HydraResearchLLC/Nautilus-Hardware/Nautilus PCBs/EIP PCB/EIP PCB Rev0.1/Extruders in Serise PCB/OUTPUT/BOM/Bill of Materials-EIP PCB0.1.xls

Comment | Description | Designator | Digi-Key Part Number | Footprint | LibRef | Manufacturer | Manufacturer Part Number | Quantity
Header 4 | CONN HEADER 4POS .100 VERT TIN | E0-1, E0-2 | WM4113-ND | HDR1X4 | Header 4 | Molex, LLC | 0022272041 | 2.0
Header 4H | CONN RECEPT 4POS .100 R/A PCB | P1 | WM3002-ND | HDR1X4H | Header 4H |  | 0022152046 | 1.0
