HydraResearchLLC/Nautilus-Hardware/Nautilus PCBs/EIP PCB/EIP PCB Rev0.1/Extruders in Serise PCB/OUTPUT/BOM/Bill of Materials-REV0.3.xls

Comment | Description | Designator | Footprint | LibRef | Quantity
Header 4H | CONN RECEPT 4POS .100 R/A PCB |  | HDR1X4H | Header 4H | 1.0
Header 4 | CONN HEADER 4POS .100 VERT TIN | E0-1, E0-2 | HDR1X4 | Header 4 | 2.0
