HydraResearchLLC/Nautilus-Hardware/Nautilus PCBs/Tool Head PCB/REV0.3_modified/REV0.3_modified/OUTPUT/BOM/Bill of Materials-REV0.3.xls

Comment | Description | Designator | Footprint | LibRef | Quantity
A125081CT |  | U01, U02, U03, U04 | A125081CT-ND | A125081CT | 4.0
WM17990CT |  | U11, U12, U13, U14 | WM17990CT-ND-l | WM17990CT | 4.0
