HydraResearchLLC/Nautilus-Hardware/Nautilus PCBs/Tool Head PCB/REV0.3_modified/REV0.3_modified/OUTPUT/BOM/Bill of Materials-REV0.3.xlsx

Comment | Description | Designator | Footprint | LibRef | MPN | Quantity
A125081CT |  | U01, U02, U03, U04 | A125081CT-ND | A125081CT | A125081CT-ND | 4
WM17990CT |  | U11, U12, U13, U14 | WM17990CT-ND-l | WM17990CT | WM17990CT-ND | 4
