HydraResearchLLC/Nautilus-Hardware/Nautilus PCBs/Tool PCB/REV0.4_modified/REV0.4_modified/OUTPUT/BOM/Bill of Materials-REV04.xls

Comment | Description | Designator | Footprint | LibRef | MPN | Quantity
WM17990CT |  | 1, 2, 3, 4 | WM17990CT-ND-l | WM17990CT | WM17990CT-ND | 4.0
CONTACT |  | J1, J2, J3, J4 | CONTRACT PAD | CONTACT | N/C | 4.0
