HydraResearchLLC/Nautilus-Hardware/Acrylic Enclosure/Acrylic Enclosure v1/XYZ v1.dxf

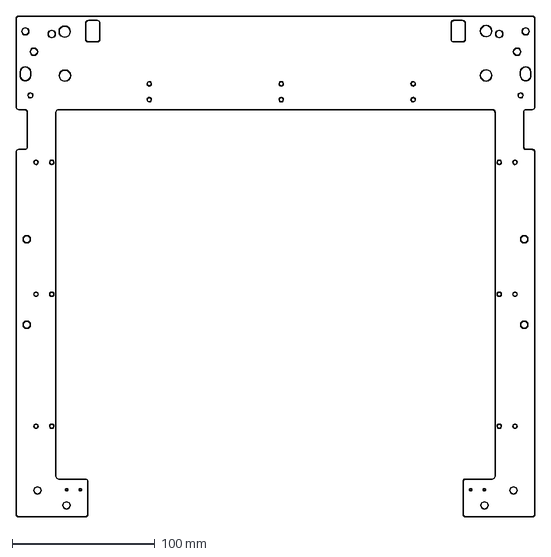
[picture p1: CAD file, 2019-06-13]
Acrylic Enclosure/Acrylic Enclosure v1/XYZ v1.dxf
364.0 x 351.2 mm
