HydraResearchLLC/Nautilus-Hardware/Jig & Fixtures/Hot Teighten Jig Top.stl

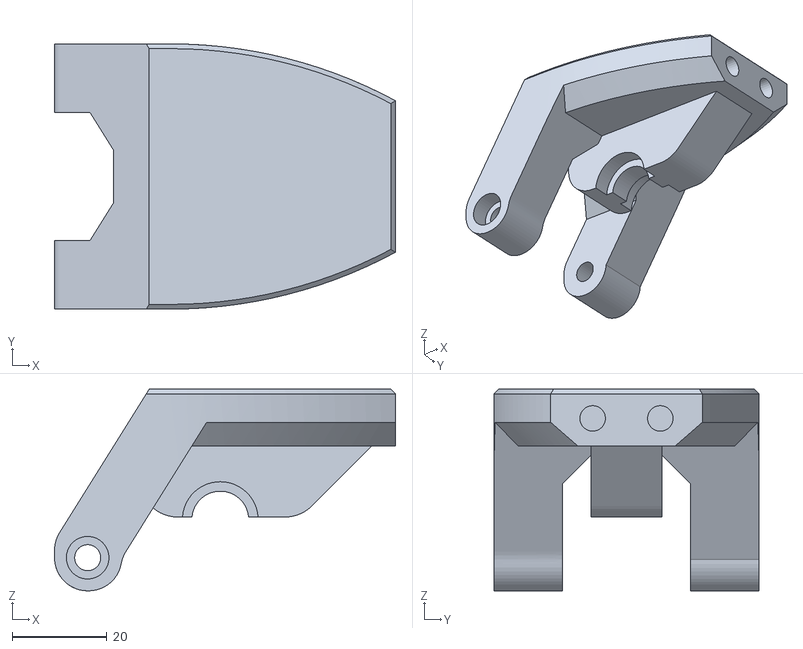
[picture p2: CAD file, 2019-05-24]
Jig & Fixtures/Hot Teighten Jig Top.stl
72.0 x 56.0 x 42.6
