HydraResearchLLC/Nautilus-Hardware/Machined Parts/Belt Tensioner/Belt Tensioner v1.step

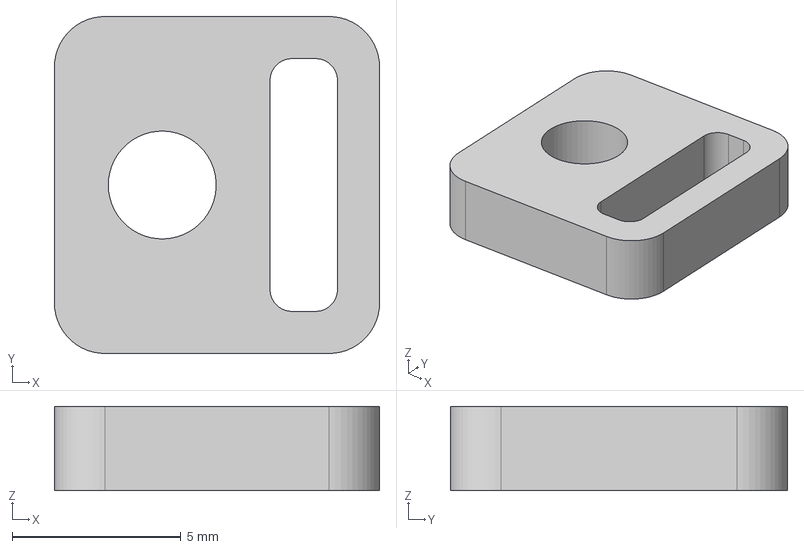
[picture p3: CAD file, 2019-05-24]
Machined Parts/Belt Tensioner/Belt Tensioner v1.step
9.65 x 10.0 x 2.50 mm
