HydraResearchLLC/Nautilus-Hardware/Machined Parts/Build Plate/Build Plate Rev0.9/Build Plate Rev0.9.step

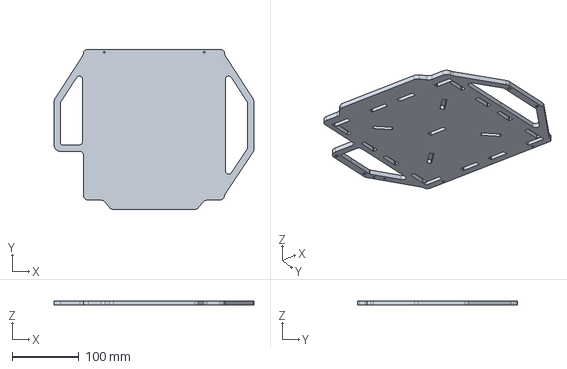
[picture p4: CAD file, 2019-05-24]
Machined Parts/Build Plate/Build Plate Rev0.9/Build Plate Rev0.9.step
300.0 x 240.0 x 6.35 mm
