HydraResearchLLC/Nautilus-Hardware/Nautilus PCBs/EIP PCB/EIP PCB Rev0.1/Extruders in Serise PCB/OUTPUT/ExportSTEP/PCB1.step

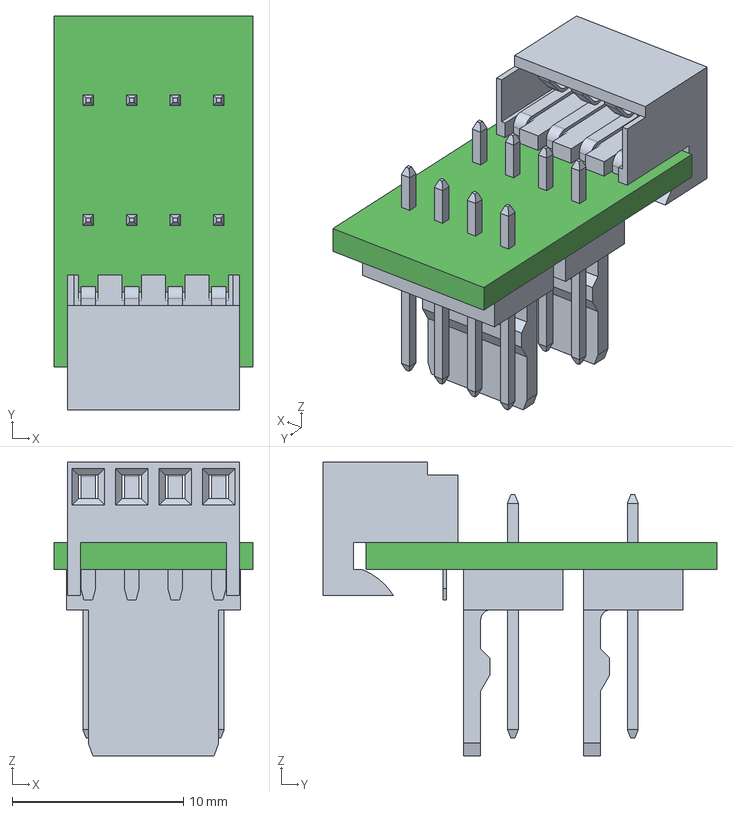
[picture p5: CAD file, 2019-05-24]
Nautilus PCBs/EIP PCB/EIP PCB Rev0.1/Extruders in Serise PCB/OUTPUT/ExportSTEP/PCB1.step
11.6 x 23.0 x 17.2 mm
Board
