HydraResearchLLC/Nautilus-Hardware/Nautilus PCBs/Tool Head PCB/REV0.3_modified/REV0.3_modified/OUTPUT/ExportSTEP/PCB1.step

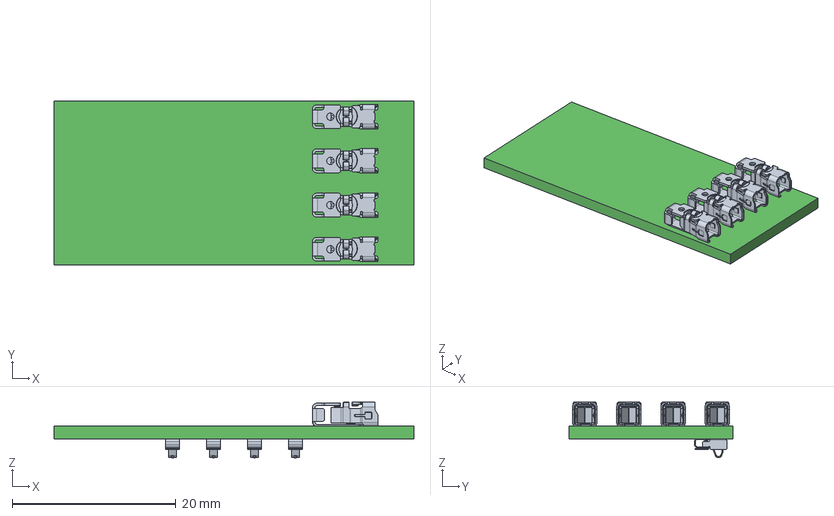
[picture p6: CAD file, 2019-05-24]
Nautilus PCBs/Tool Head PCB/REV0.3_modified/REV0.3_modified/OUTPUT/ExportSTEP/PCB1.step
44.0 x 20.0 x 6.79 mm
Board
c-2286211-3-a-3d x 4
