HydraResearchLLC/Nautilus-Hardware/Nautilus PCBs/Tool PCB/REV0.4_modified/REV0.4_modified/OUTPUT/ExportSTEP/REV04.step

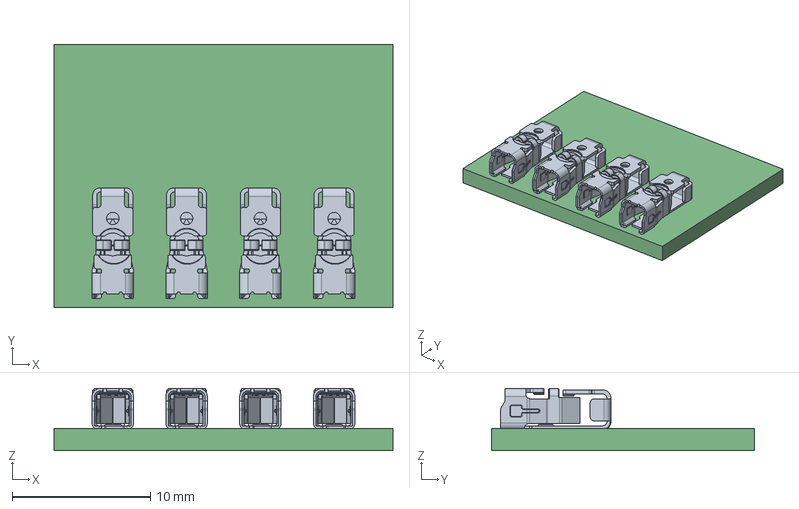
[picture p7: CAD file, 2019-05-24]
Nautilus PCBs/Tool PCB/REV0.4_modified/REV0.4_modified/OUTPUT/ExportSTEP/REV04.step
24.5 x 19.0 x 4.49 mm
Board
