HydraResearchLLC/Nautilus-Hardware/Printed Parts/STL/IO Cover Plate/IO a (2).stl

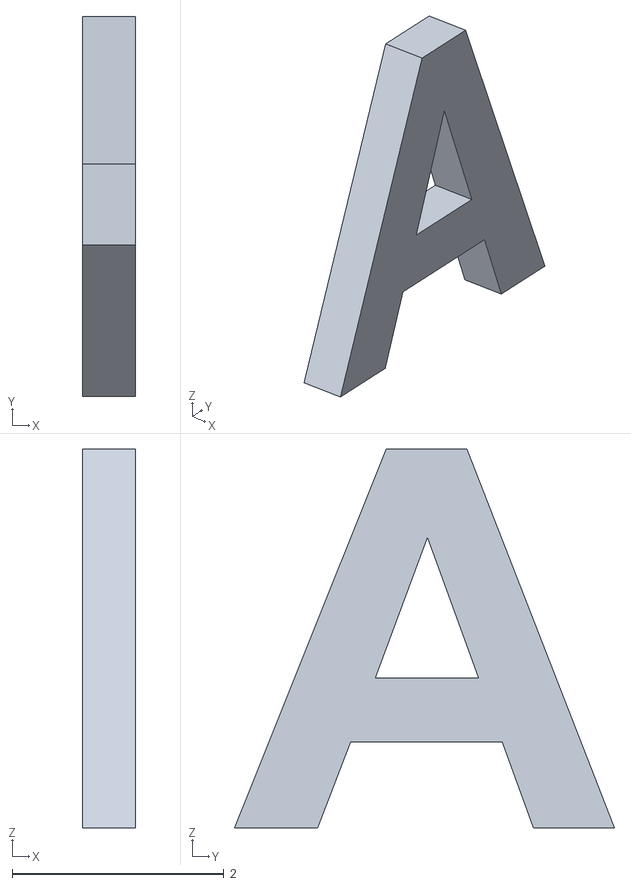
[picture p8: CAD file, 2019-05-24]
Printed Parts/STL/IO Cover Plate/IO a (2).stl
0.5 x 3.59 x 3.58
