HydraResearchLLC/Nautilus-Hardware/Printed Parts/STL/Y Back L.stl

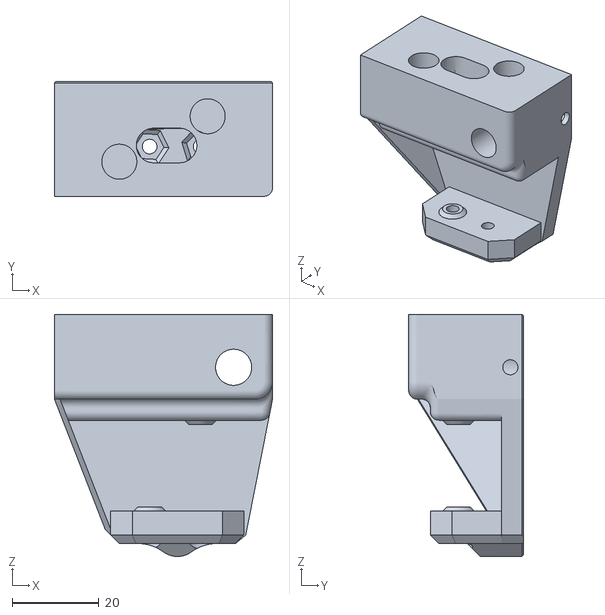
[picture p9: CAD file, 2019-06-29]
Printed Parts/STL/Y Back L.stl
50.4 x 26.5 x 55.9
