HydraResearchLLC/Nautilus-Hardware/Jig & Fixtures/Silicon Square 2'' Jig Top.stl

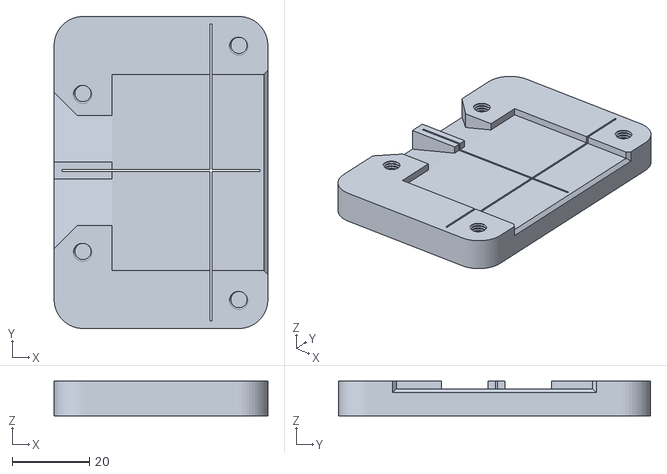
[picture p11: CAD file, 2019-05-24]
Jig & Fixtures/Silicon Square 2'' Jig Top.stl
55.5 x 81.0 x 9.00
