HydraResearchLLC/Nautilus-Hardware/Jig & Fixtures/TC PTFE Jig Pt1.stl

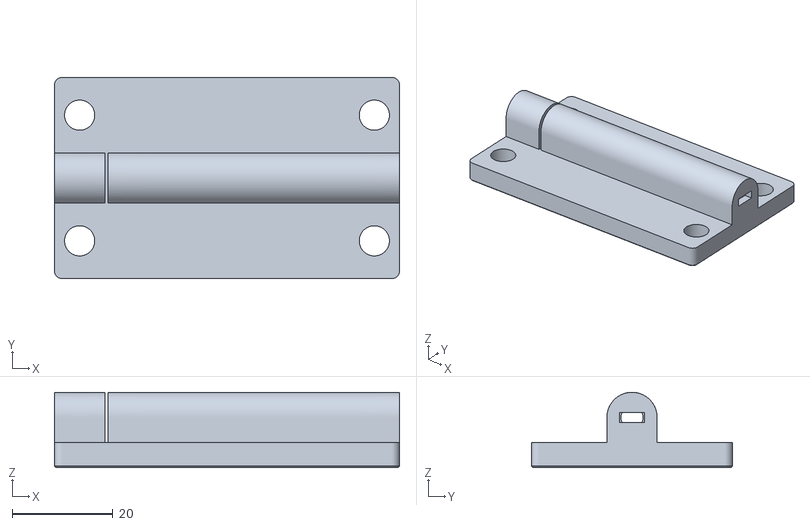
[picture p13: CAD file, 2019-05-24]
Jig & Fixtures/TC PTFE Jig Pt1.stl
68.6 x 40.0 x 15.0
