HydraResearchLLC/Nautilus-Hardware/Machined Parts/Print Surface/Build Surface rev0.4.dxf

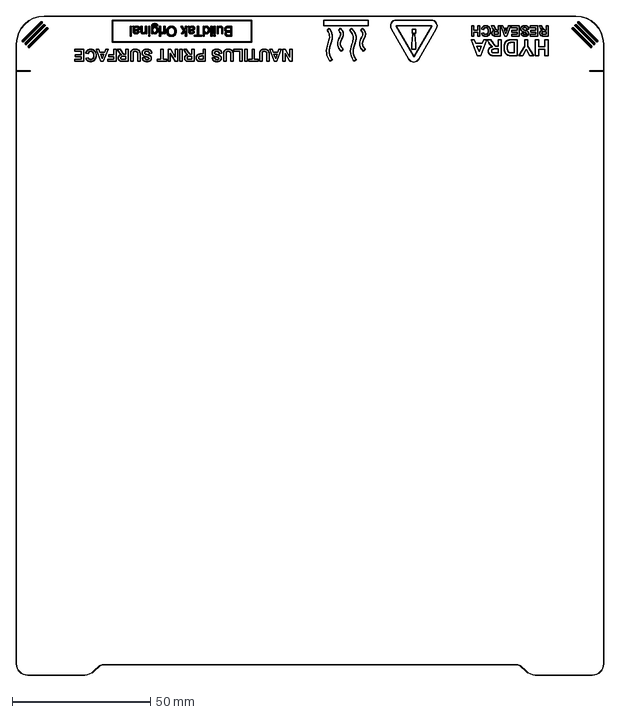
[picture p14: CAD file, 2019-05-24]
Machined Parts/Print Surface/Build Surface rev0.4.dxf
212.0 x 238.0 mm
