HydraResearchLLC/Nautilus-Hardware/Printed Parts/STL/IO Cover Plate/IO Cover Plate.stl

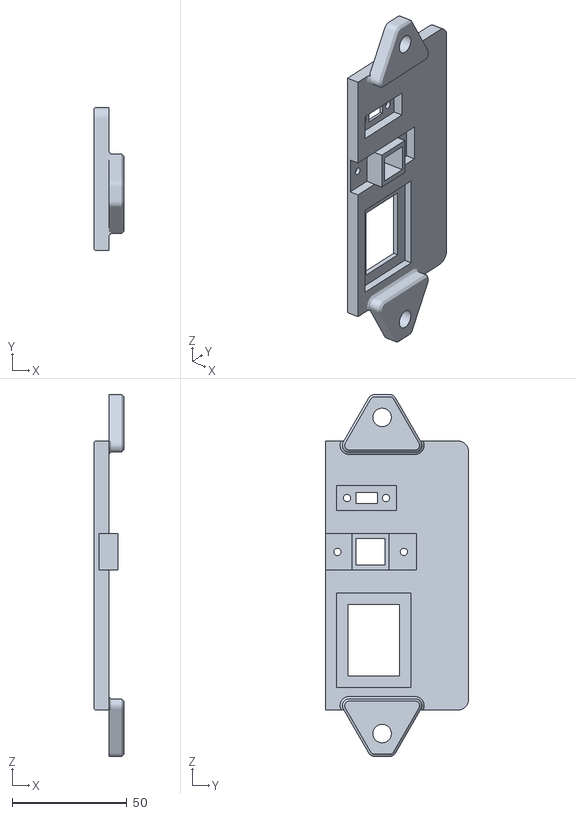
[picture p15: CAD file, 2019-05-24]
Printed Parts/STL/IO Cover Plate/IO Cover Plate.stl
13.1 x 62.6 x 158.0
