HydraResearchLLC/Nautilus-Hardware/Printed Parts/STL/Z-Axis Bottom Mount.stl

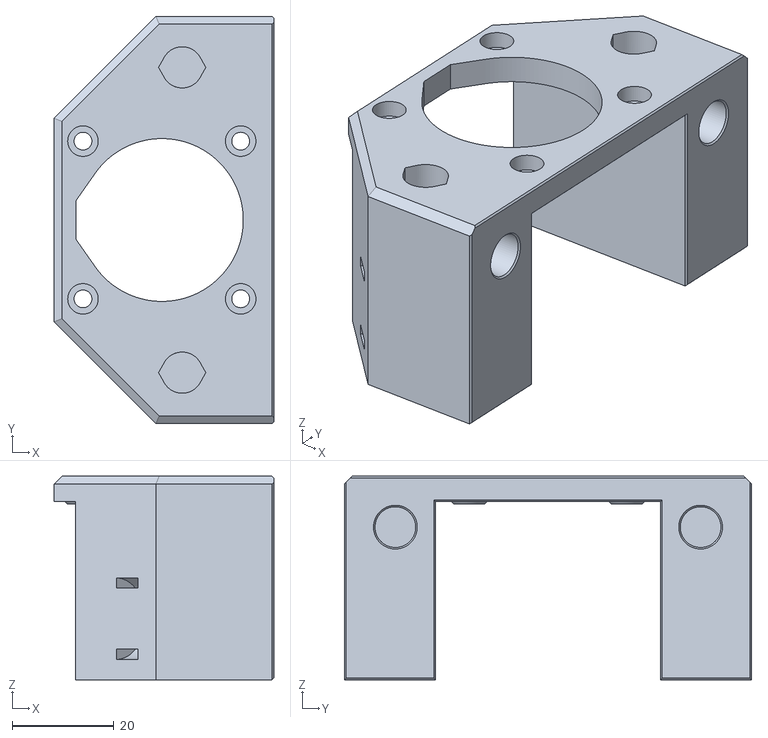
[picture p16: CAD file, 2019-06-29]
Printed Parts/STL/Z-Axis Bottom Mount.stl
43.1 x 80.0 x 40.0
