HydraResearchLLC/Nautilus-Hardware/Acrylic Enclosure/Acrylic Enclosure v1/Frame Side L v1.dxf

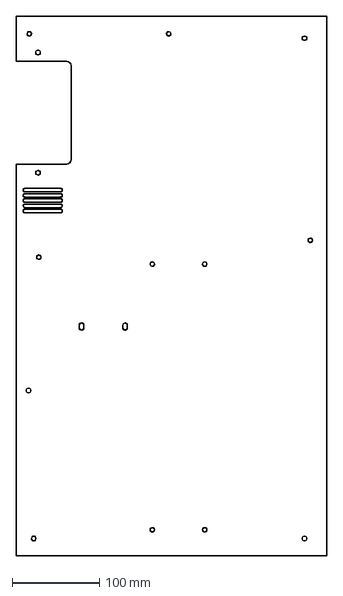
[picture p17: CAD file, 2019-06-13]
Acrylic Enclosure/Acrylic Enclosure v1/Frame Side L v1.dxf
356.7 x 620.3 mm
