HydraResearchLLC/Nautilus-Hardware/Jig & Fixtures/TH Test Jig.stl

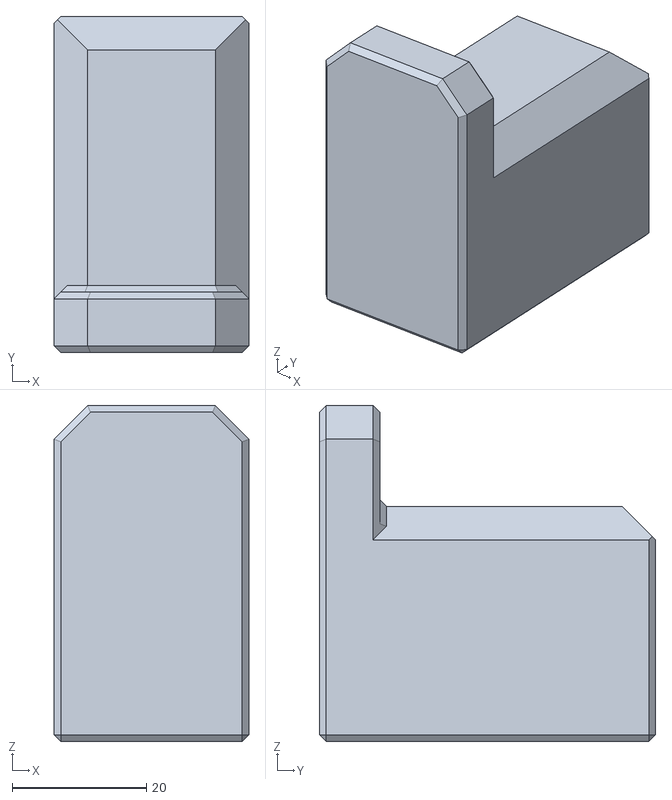
[picture p18: CAD file, 2019-05-24]
Jig & Fixtures/TH Test Jig.stl
29.0 x 50.0 x 50.0
