HydraResearchLLC/Nautilus-Hardware/Printed Parts/STL/IO Cover Plate/IO i.stl

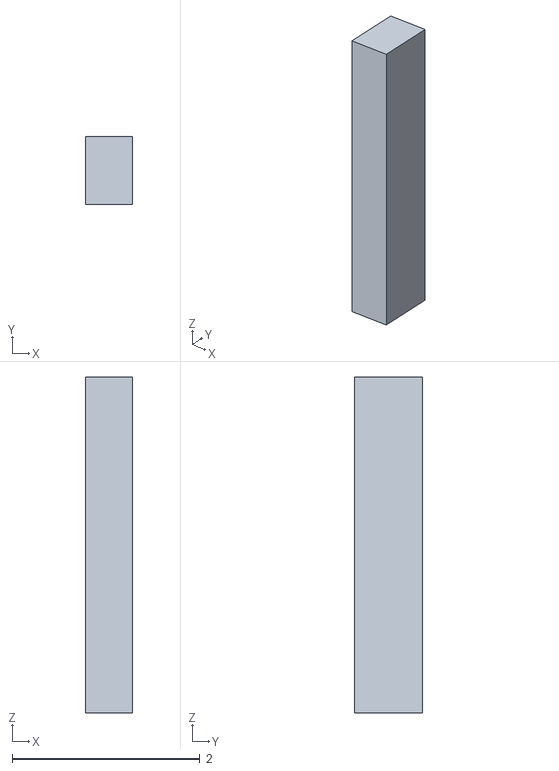
[picture p19: CAD file, 2019-05-24]
Printed Parts/STL/IO Cover Plate/IO i.stl
0.5 x 0.723 x 3.58
