HydraResearchLLC/Nautilus-Hardware/Printed Parts/STL/Tool Cartridge B 250.stl

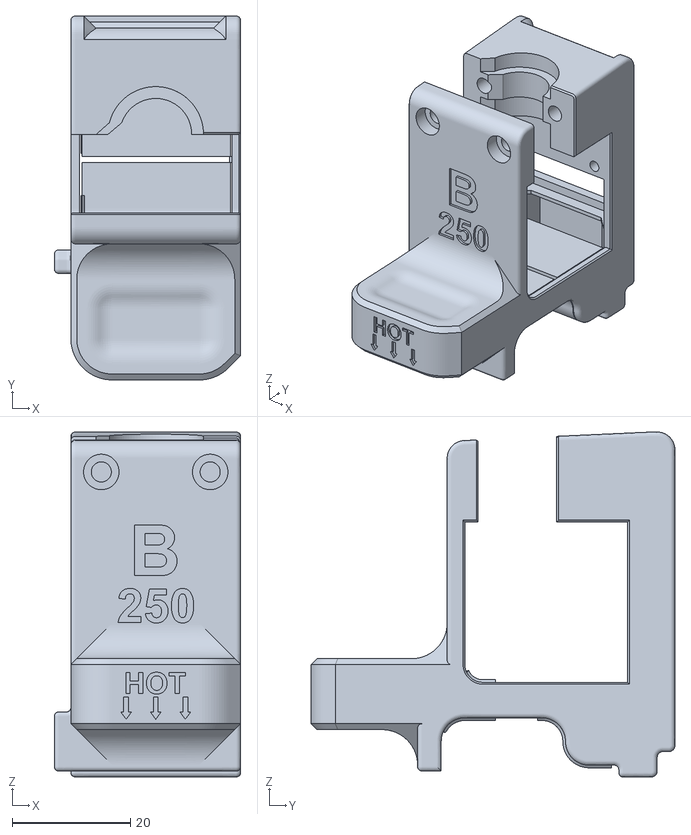
[picture p20: CAD file, 2019-06-13]
Printed Parts/STL/Tool Cartridge B 250.stl
31.5 x 61.5 x 58.3
