HydraResearchLLC/Nautilus-Hardware/Acrylic Enclosure/Acrylic Enclosure v1/Electonics Enclosure Back v1.dxf

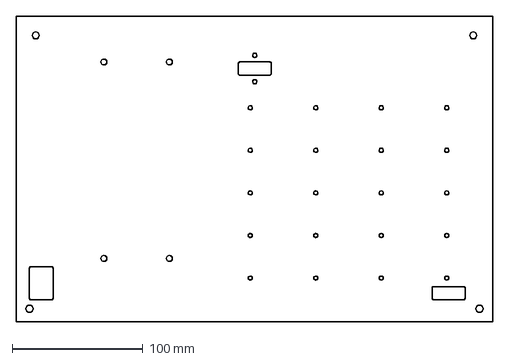
[picture p21: CAD file, 2019-05-24]
Acrylic Enclosure/Acrylic Enclosure v1/Electonics Enclosure Back v1.dxf
363.6 x 233.5 mm
