HydraResearchLLC/Nautilus-Hardware/Jig & Fixtures/Silicon Square 2'' Jig Bottom.stl

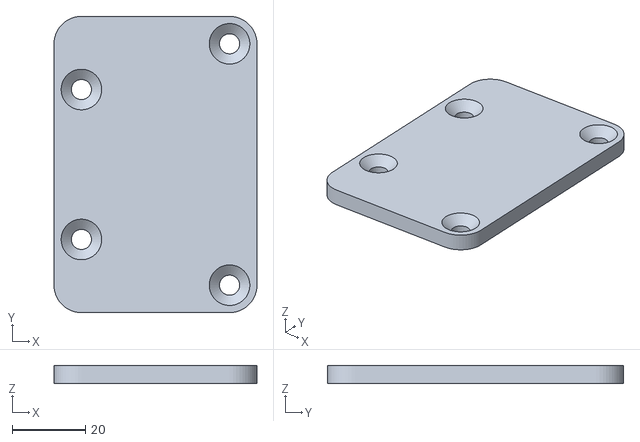
[picture p22: CAD file, 2019-05-24]
Jig & Fixtures/Silicon Square 2'' Jig Bottom.stl
55.5 x 81.0 x 5.00
