HydraResearchLLC/Nautilus-Hardware/Machined Parts/Print Surface/Build Surface rev 0.7 (no graphics).dxf

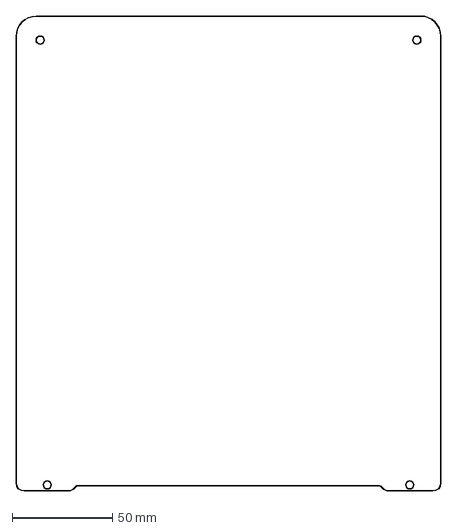
[picture p23: CAD file, 2019-05-24]
Machined Parts/Print Surface/Build Surface rev 0.7 (no graphics).dxf
212.0 x 237.0 mm
