HydraResearchLLC/Nautilus-Hardware/Printed Parts/STL/IO Cover Plate/IO O.stl

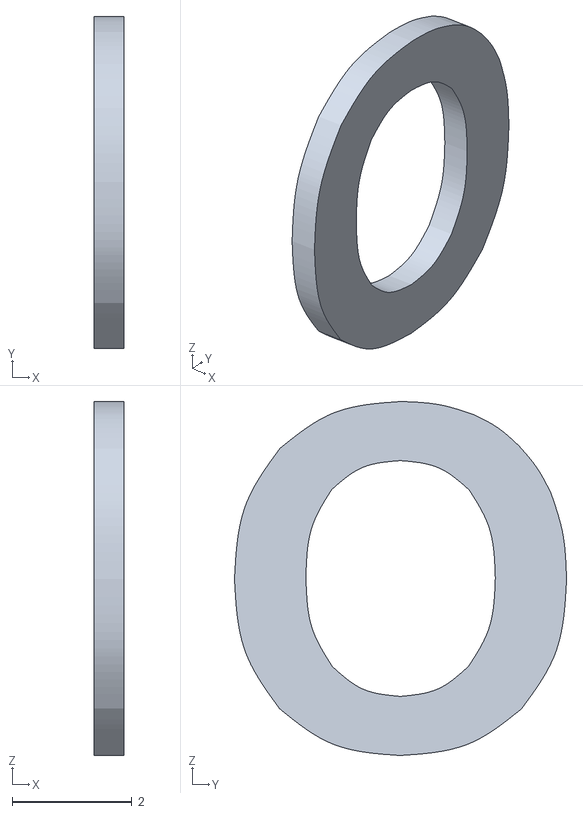
[picture p24: CAD file, 2019-05-24]
Printed Parts/STL/IO Cover Plate/IO O.stl
0.5 x 5.55 x 5.92
