HydraResearchLLC/Nautilus-Hardware/Printed Parts/STL/XY-Axis Idler Spacer.stl

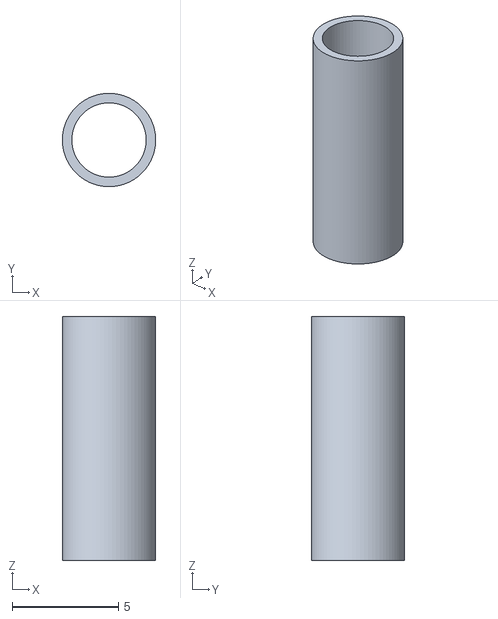
[picture p25: CAD file, 2019-06-13]
Printed Parts/STL/XY-Axis Idler Spacer.stl
4.40 x 4.40 x 11.5
