HydraResearchLLC/Nautilus-Hardware/Acrylic Enclosure/Acrylic Enclosure v1/Frame Back Rev v1.dxf

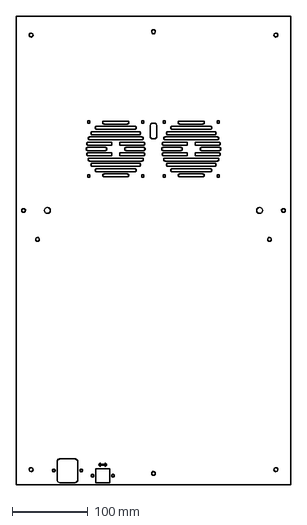
[picture p26: CAD file, 2019-05-24]
Acrylic Enclosure/Acrylic Enclosure v1/Frame Back Rev v1.dxf
364.0 x 620.3 mm
