HydraResearchLLC/Nautilus-Hardware/Jig & Fixtures/Hot Tighten Jig Bottom.stl

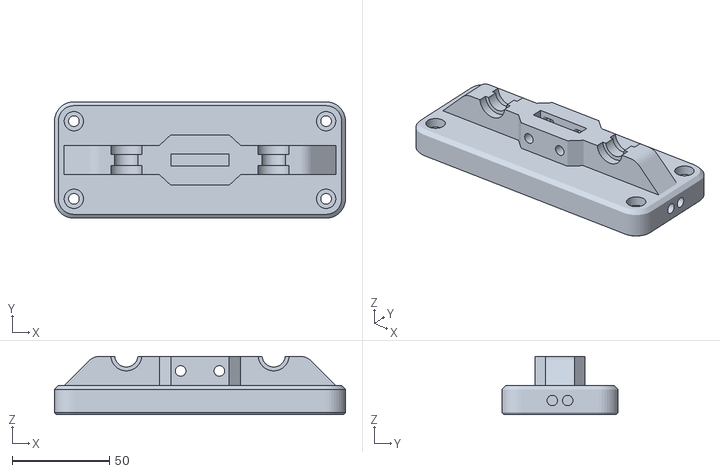
[picture p27: CAD file, 2019-05-24]
Jig & Fixtures/Hot Tighten Jig Bottom.stl
150.0 x 60.0 x 30.0
