HydraResearchLLC/Nautilus-Hardware/Acrylic Enclosure/Acrylic Enclosure v1/Frame Front v1.dxf

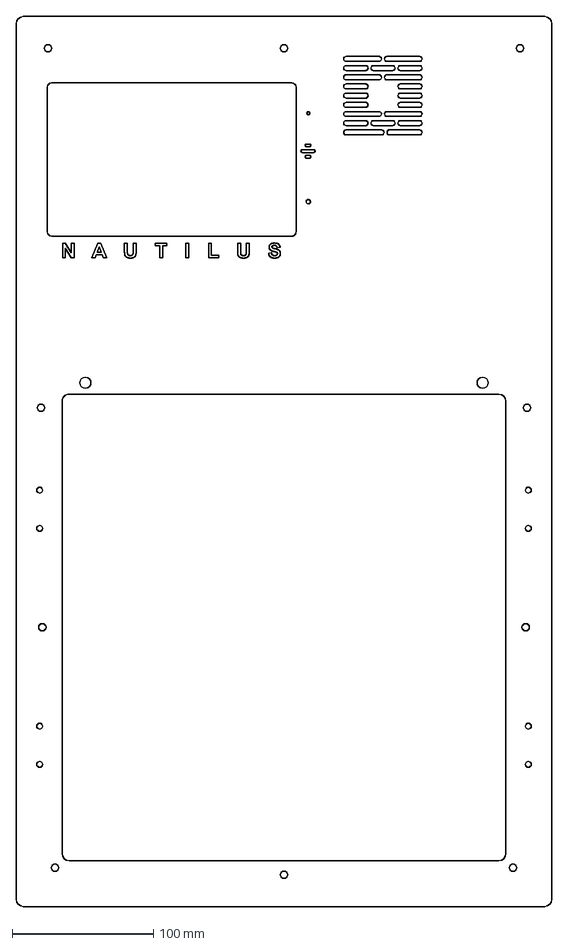
[picture p28: CAD file, 2019-05-24]
Acrylic Enclosure/Acrylic Enclosure v1/Frame Front v1.dxf
379.0 x 629.8 mm
