HydraResearchLLC/Nautilus-Hardware/Jig & Fixtures/FIP PTFE Jig Pt2.stl

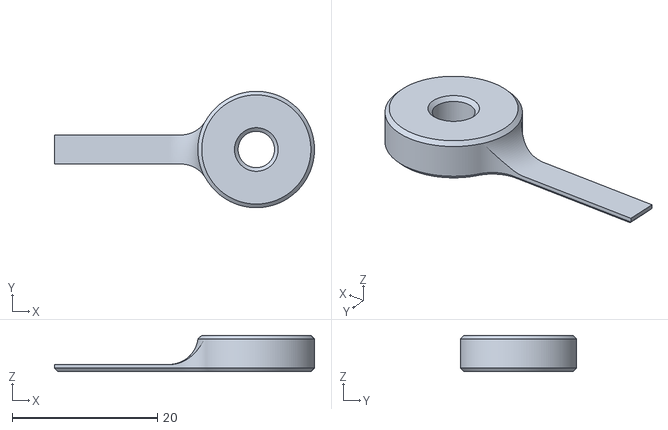
[picture p29: CAD file, 2019-05-24]
Jig & Fixtures/FIP PTFE Jig Pt2.stl
35.7 x 16.0 x 5.00
