HydraResearchLLC/Nautilus-Hardware/Machined Parts/Print Surface/Build Surface rev0.2 (w grapichs).dxf

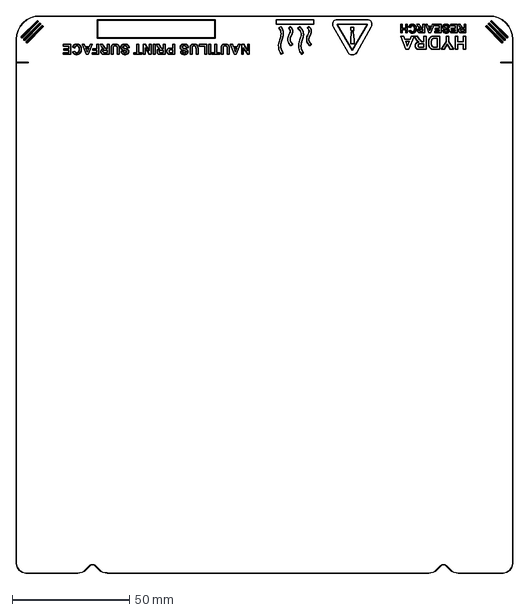
[picture p30: CAD file, 2019-05-24]
Machined Parts/Print Surface/Build Surface rev0.2 (w grapichs).dxf
212.0 x 238.0 mm
