HydraResearchLLC/Nautilus-Hardware/Printed Parts/STL/IO Cover Plate/IO nn.stl

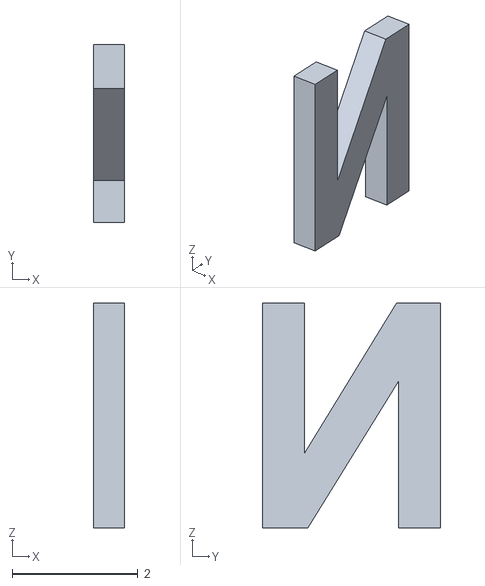
[picture p31: CAD file, 2019-05-24]
Printed Parts/STL/IO Cover Plate/IO nn.stl
0.5 x 2.84 x 3.58
