HydraResearchLLC/Nautilus-Hardware/Acrylic Enclosure/Acrylic Enclosure v1/Frame Bottom v1.dxf

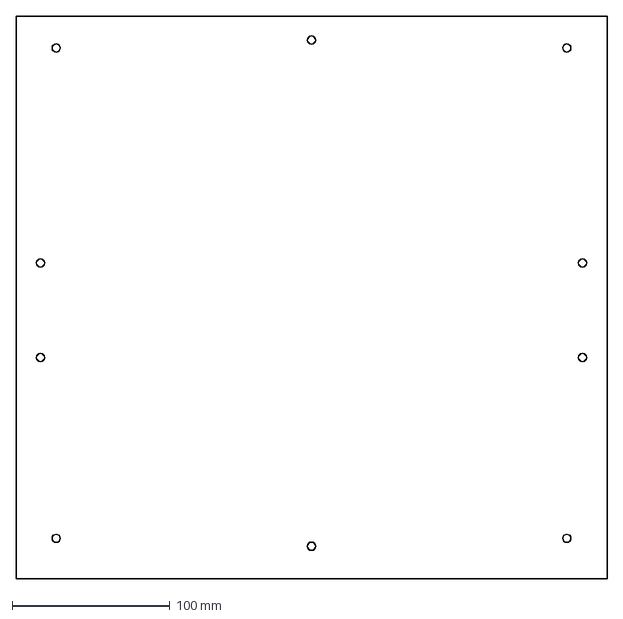
[picture p32: CAD file, 2019-05-24]
Acrylic Enclosure/Acrylic Enclosure v1/Frame Bottom v1.dxf
375.0 x 356.7 mm
