HydraResearchLLC/Nautilus-Hardware/Printed Parts/STL/IO Cover Plate/IO F.stl

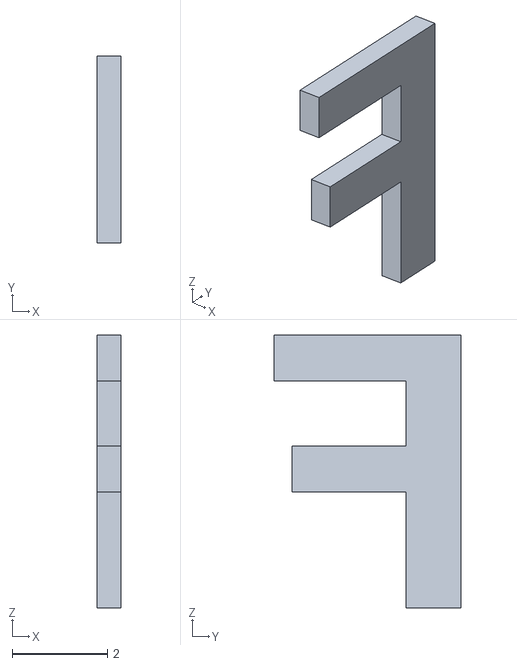
[picture p33: CAD file, 2019-05-24]
Printed Parts/STL/IO Cover Plate/IO F.stl
0.5 x 3.93 x 5.73
