HydraResearchLLC/Nautilus-Hardware/Printed Parts/STL/Tool Head Gantry.stl

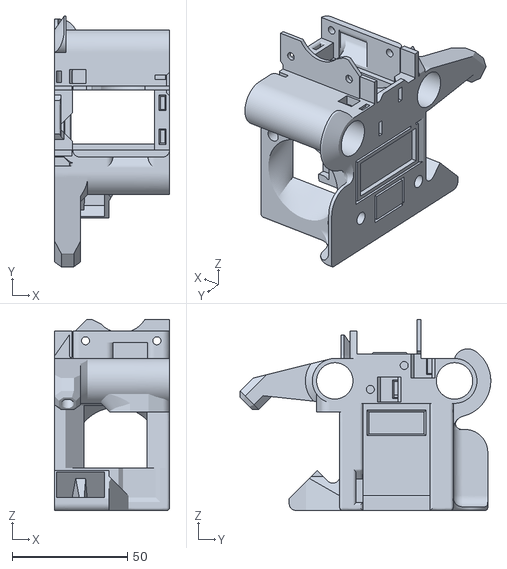
[picture p34: CAD file, 2019-06-13]
Printed Parts/STL/Tool Head Gantry.stl
50.0 x 108.9 x 82.9
