HydraResearchLLC/Nautilus-Hardware/Acrylic Enclosure/Acrylic Enclosure v1/Door v1.dxf

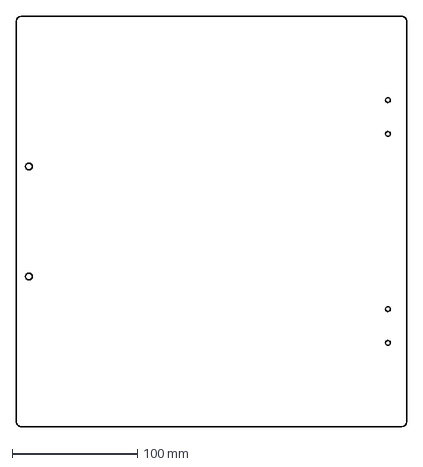
[picture p35: CAD file, 2019-05-24]
Acrylic Enclosure/Acrylic Enclosure v1/Door v1.dxf
312.0 x 328.1 mm
