HydraResearchLLC/Nautilus-Hardware/Jig & Fixtures/TC Test Jig.stl

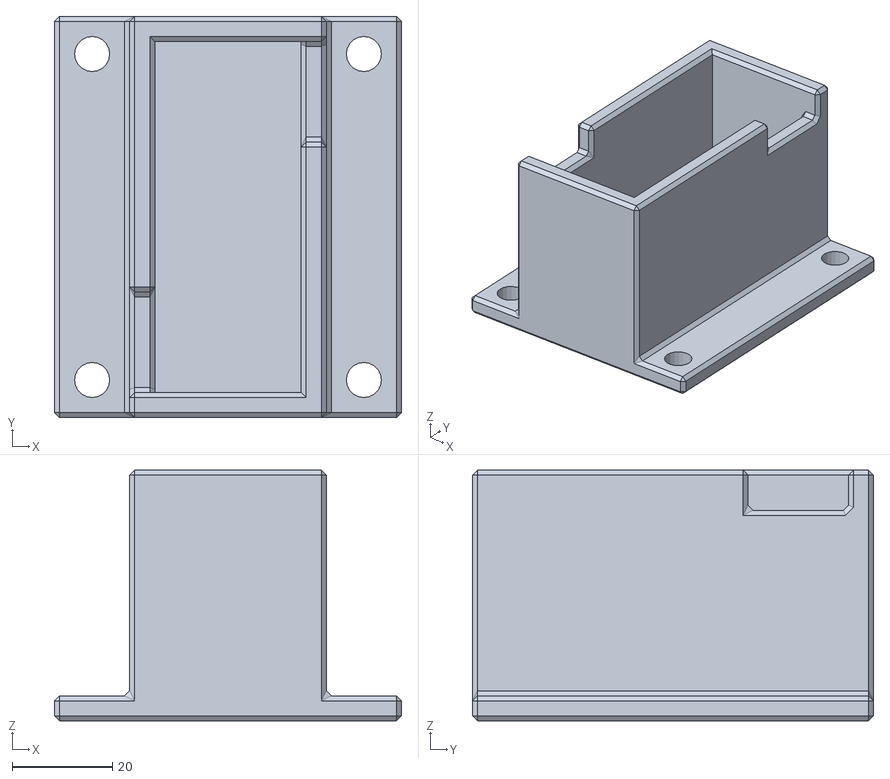
[picture p36: CAD file, 2019-05-24]
Jig & Fixtures/TC Test Jig.stl
69.2 x 80.0 x 50.0
