HydraResearchLLC/Nautilus-Hardware/Printed Parts/STL/Build Plate Cable Mount.stl

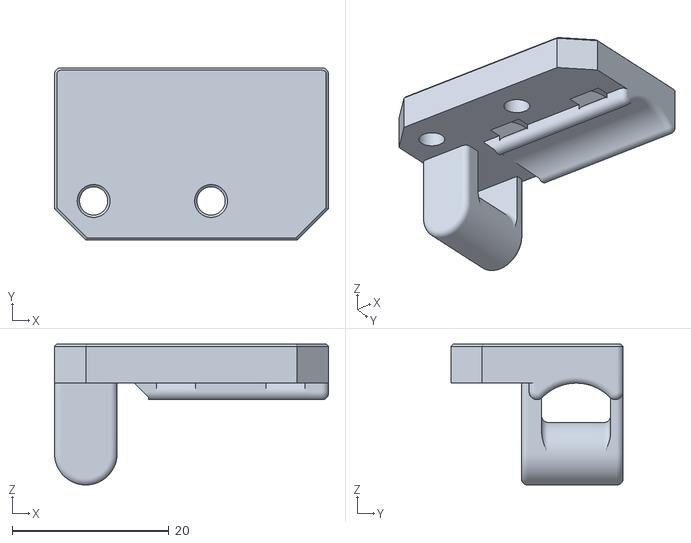
[picture p37: CAD file, 2019-06-13]
Printed Parts/STL/Build Plate Cable Mount.stl
35.0 x 22.0 x 18.0
