HydraResearchLLC/Nautilus-Hardware/Printed Parts/STL/IO Cover Plate/IO n.stl

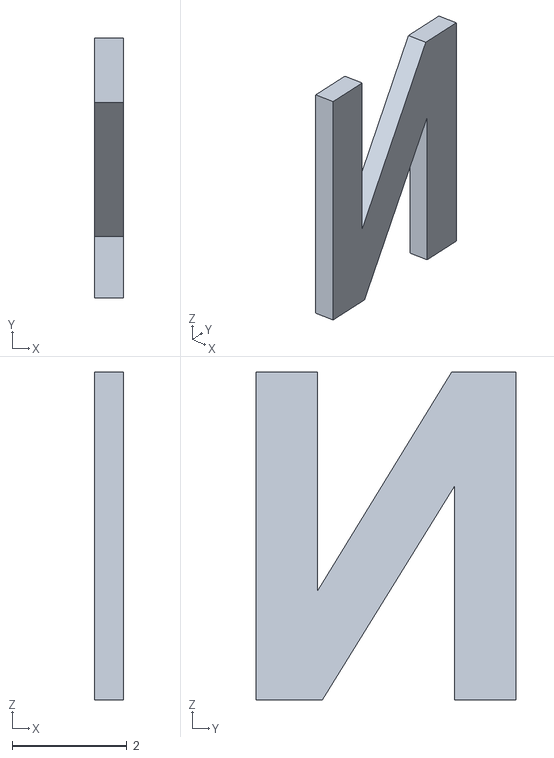
[picture p38: CAD file, 2019-05-24]
Printed Parts/STL/IO Cover Plate/IO n.stl
0.5 x 4.54 x 5.73
