HydraResearchLLC/Nautilus-Hardware/Jig & Fixtures/Band Sawe Mag Strips Jig.stl

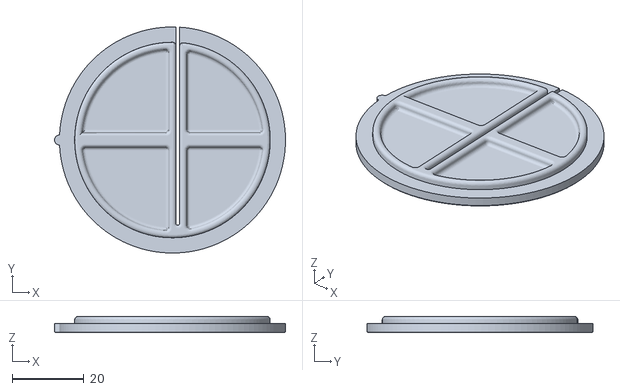
[picture p39: CAD file, 2019-05-24]
Jig & Fixtures/Band Sawe Mag Strips Jig.stl
64.4 x 63.0 x 4.50
