HydraResearchLLC/Nautilus-Hardware/Printed Parts/STL/Extruder Body.stl

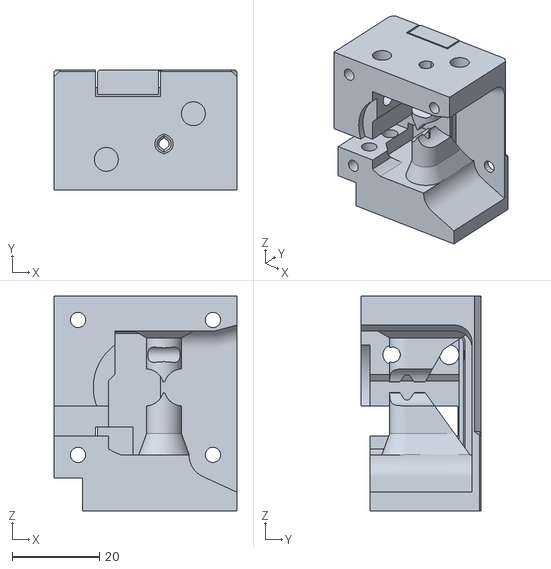
[picture p40: CAD file, 2019-06-13]
Printed Parts/STL/Extruder Body.stl
42.0 x 27.5 x 49.4
