HydraResearchLLC/Nautilus-Hardware/Printed Parts/STL/IO Cover Plate/IO m.stl

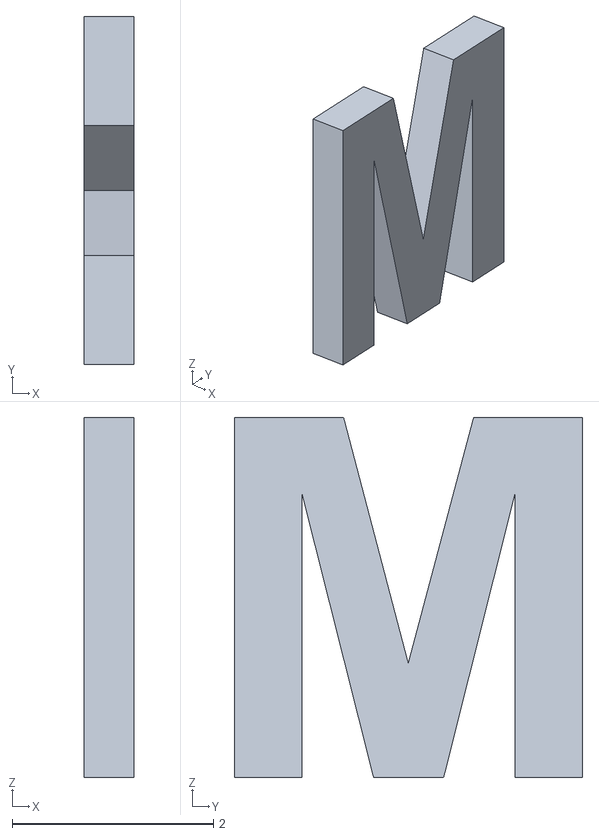
[picture p41: CAD file, 2019-05-24]
Printed Parts/STL/IO Cover Plate/IO m.stl
0.5 x 3.46 x 3.58
