HydraResearchLLC/Nautilus-Hardware/Jig & Fixtures/FIP PTFE Jig Pt1.stl

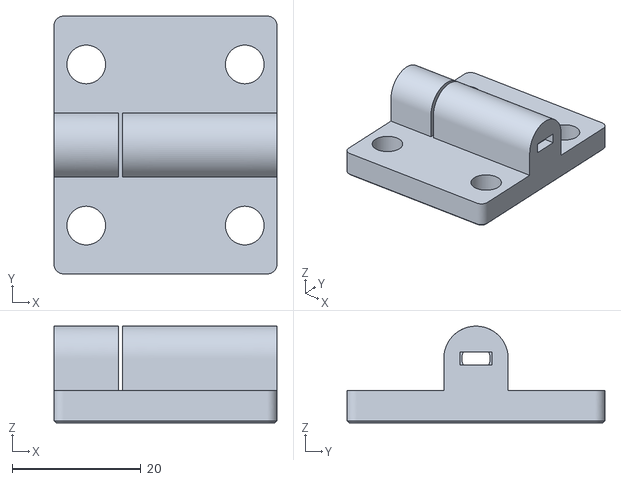
[picture p42: CAD file, 2019-05-24]
Jig & Fixtures/FIP PTFE Jig Pt1.stl
34.6 x 40.0 x 15.0
