HydraResearchLLC/Nautilus-Hardware/Printed Parts/STL/Door Mag Holder.stl

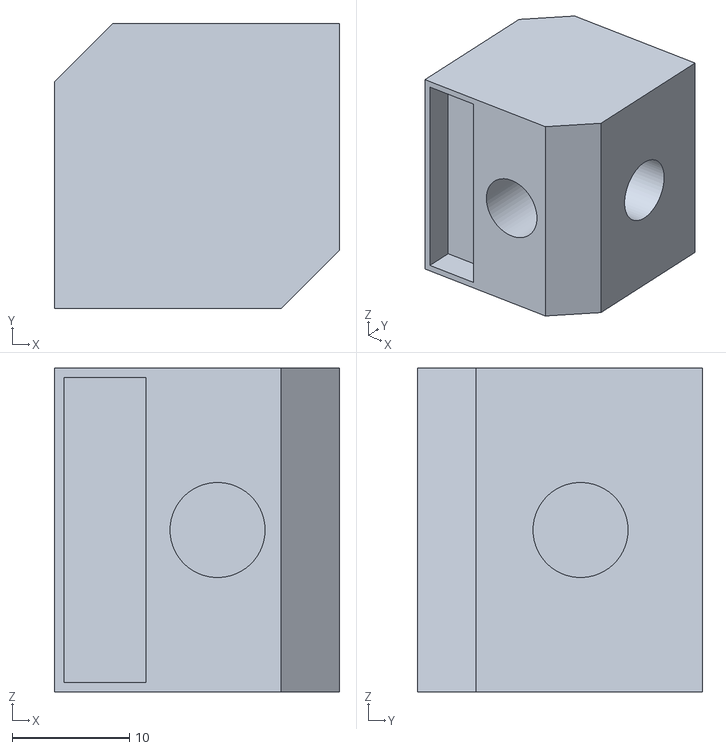
[picture p43: CAD file, 2019-05-24]
Printed Parts/STL/Door Mag Holder.stl
24.3 x 24.3 x 27.6
