HydraResearchLLC/Nautilus-Hardware/Printed Parts/STL/IO Cover Plate/IO p.stl

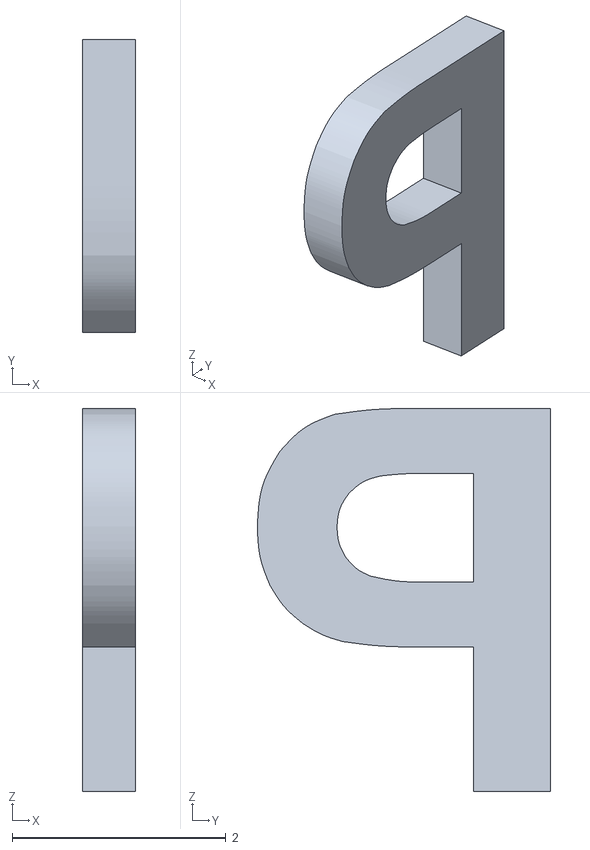
[picture p44: CAD file, 2019-05-24]
Printed Parts/STL/IO Cover Plate/IO p.stl
0.5 x 2.74 x 3.58
