HydraResearchLLC/Nautilus-Hardware/Printed Parts/STL/Duet Touch Mount.stl

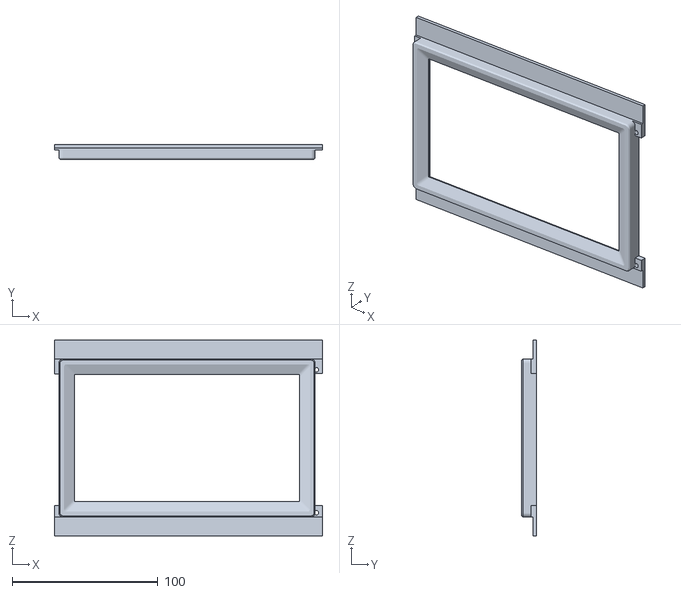
[picture p45: CAD file, 2019-05-24]
Printed Parts/STL/Duet Touch Mount.stl
183.7 x 9.95 x 134.2
