HydraResearchLLC/Nautilus-Hardware/Printed Parts/STL/Wire Guide Top.stl

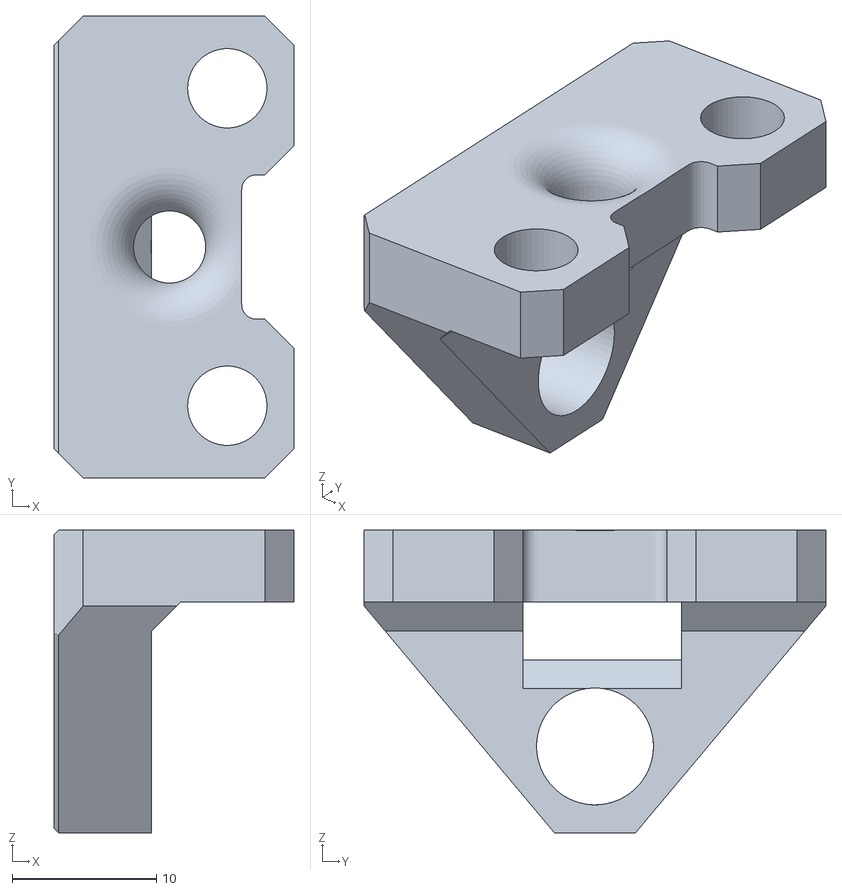
[picture p46: CAD file, 2019-05-24]
Printed Parts/STL/Wire Guide Top.stl
16.6 x 32.0 x 21.0
