HydraResearchLLC/Nautilus-Hardware/Printed Parts/STL/IO Cover Plate/IO e.stl

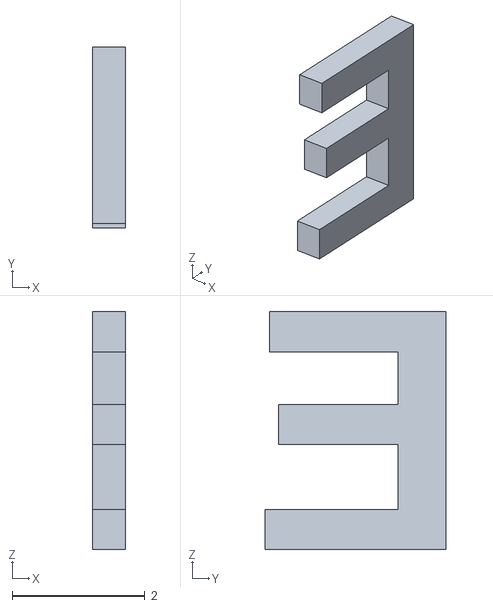
[picture p47: CAD file, 2019-05-24]
Printed Parts/STL/IO Cover Plate/IO e.stl
0.5 x 2.72 x 3.58
