HydraResearchLLC/Nautilus-Hardware/Printed Parts/STL/Nautils Rubber Feet.stl

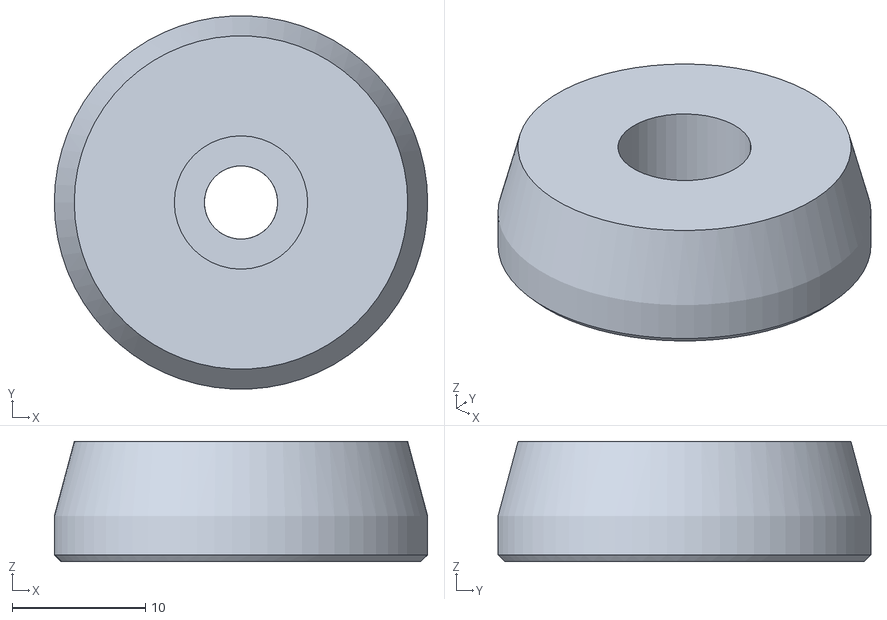
[picture p48: CAD file, 2019-05-24]
Printed Parts/STL/Nautils Rubber Feet.stl
28.0 x 28.0 x 9.00
