HydraResearchLLC/Nautilus-Hardware/Printed Parts/STL/IO Cover Plate/IO l.stl

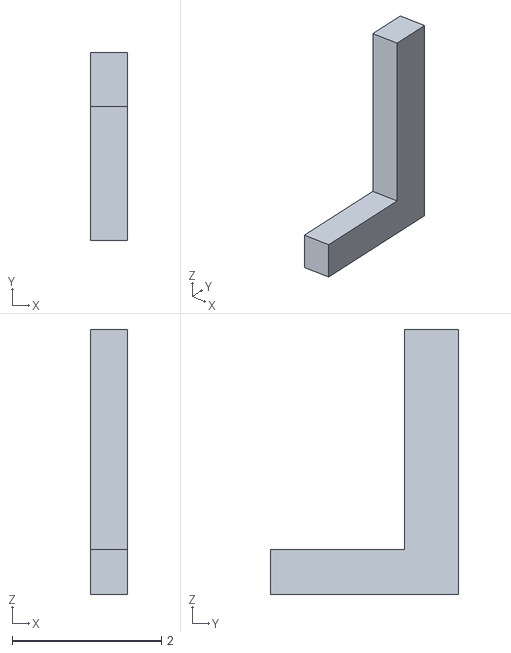
[picture p49: CAD file, 2019-05-24]
Printed Parts/STL/IO Cover Plate/IO l.stl
0.5 x 2.52 x 3.55
