HydraResearchLLC/Nautilus-Hardware/Printed Parts/STL/Purge Bucket.stl

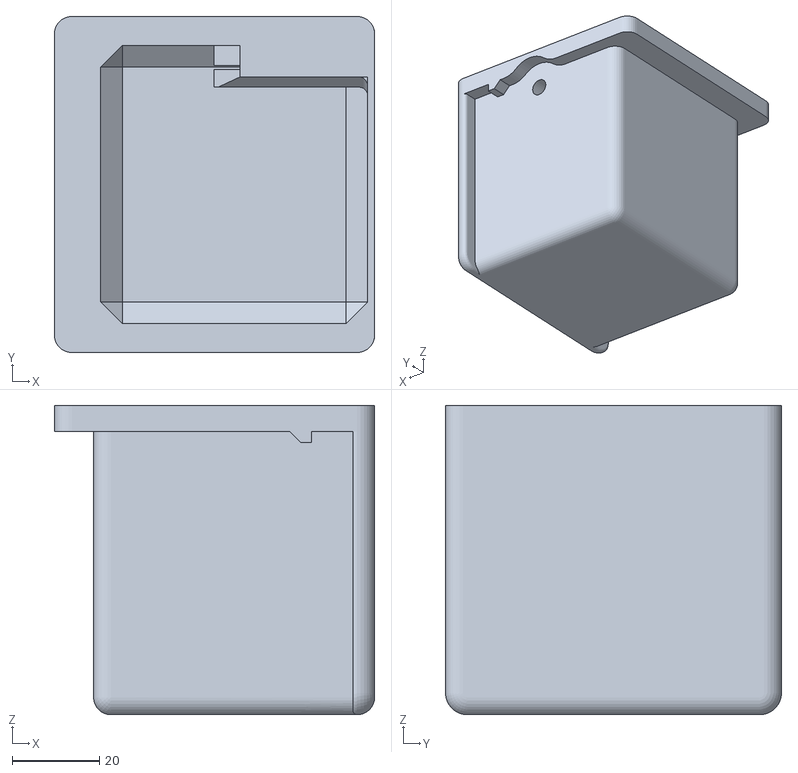
[picture p50: CAD file, 2019-05-24]
Printed Parts/STL/Purge Bucket.stl
73.5 x 77.1 x 71.0
