HydraResearchLLC/Nautilus-Hardware/Printed Parts/STL/Wire Guide Chamber.stl

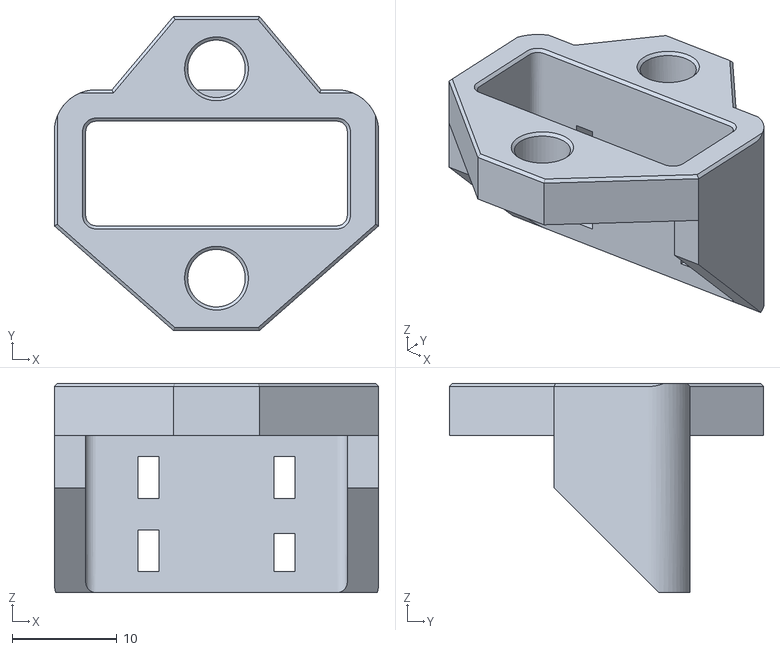
[picture p51: CAD file, 2019-05-24]
Printed Parts/STL/Wire Guide Chamber.stl
31.0 x 30.0 x 20.0
