HydraResearchLLC/Nautilus-Hardware/Printed Parts/STL/Ethernet Cover.stl

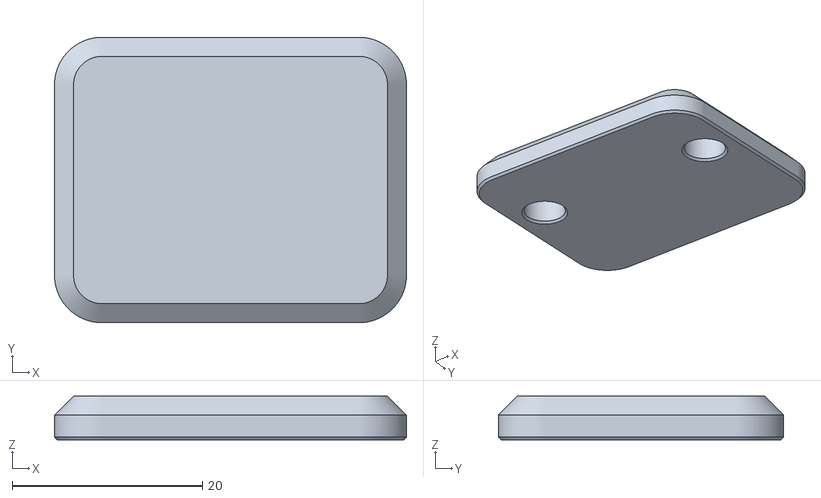
[picture p52: CAD file, 2019-05-24]
Printed Parts/STL/Ethernet Cover.stl
37.0 x 30.0 x 4.60
