HydraResearchLLC/Nautilus-Hardware/Printed Parts/STL/Door Handle.stl

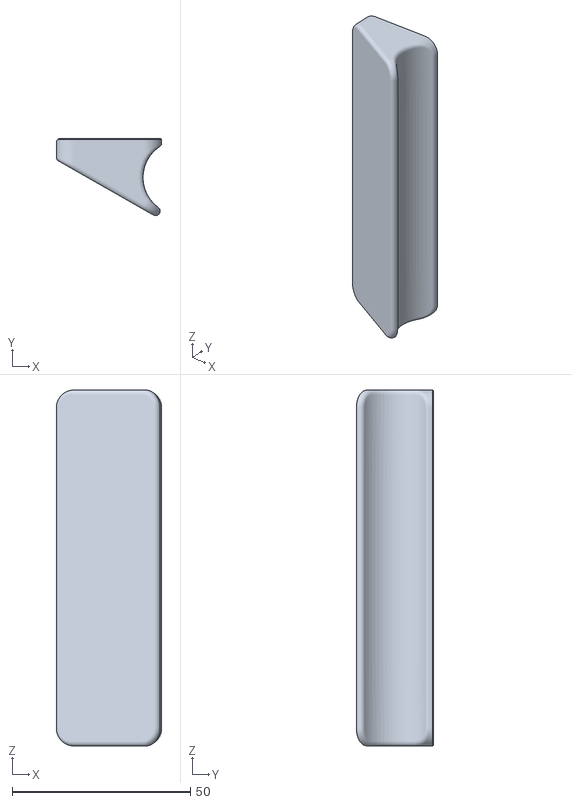
[picture p53: CAD file, 2019-05-24]
Printed Parts/STL/Door Handle.stl
29.6 x 21.7 x 100.0
