HydraResearchLLC/Nautilus-Hardware/Printed Parts/STL/Duet Mount.stl

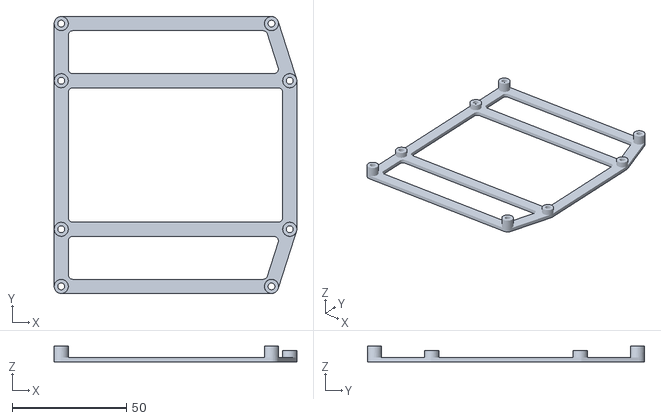
[picture p54: CAD file, 2019-05-24]
Printed Parts/STL/Duet Mount.stl
106.2 x 121.2 x 7.00
