HydraResearchLLC/Nautilus-Hardware/Printed Parts/STL/Electronics Enclosure bottoms.stl

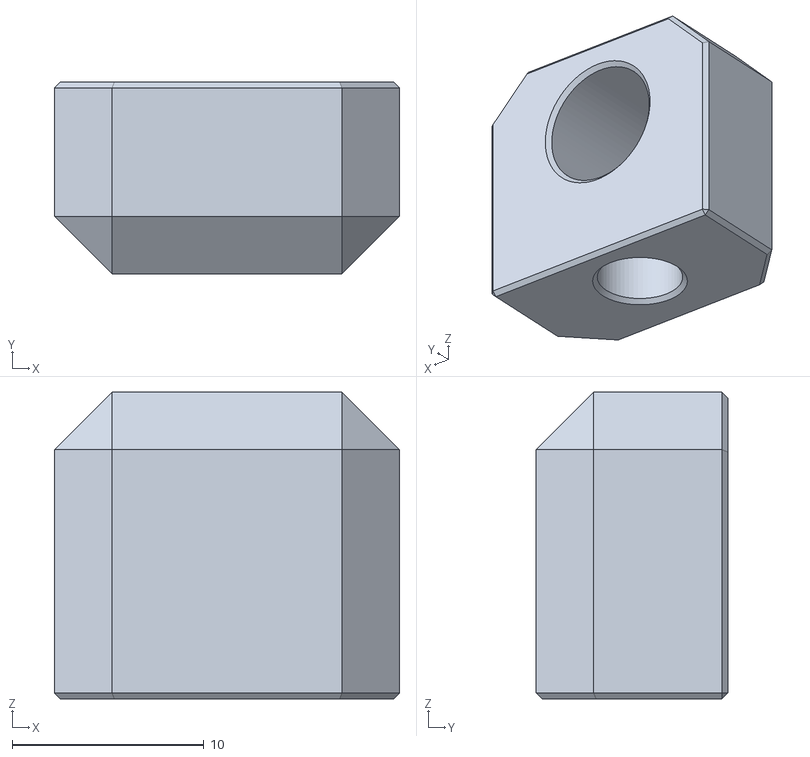
[picture p55: CAD file, 2019-05-24]
Printed Parts/STL/Electronics Enclosure bottoms.stl
18.0 x 10.0 x 16.0
