HydraResearchLLC/Nautilus-Hardware/Printed Parts/STL/Y Front L.stl

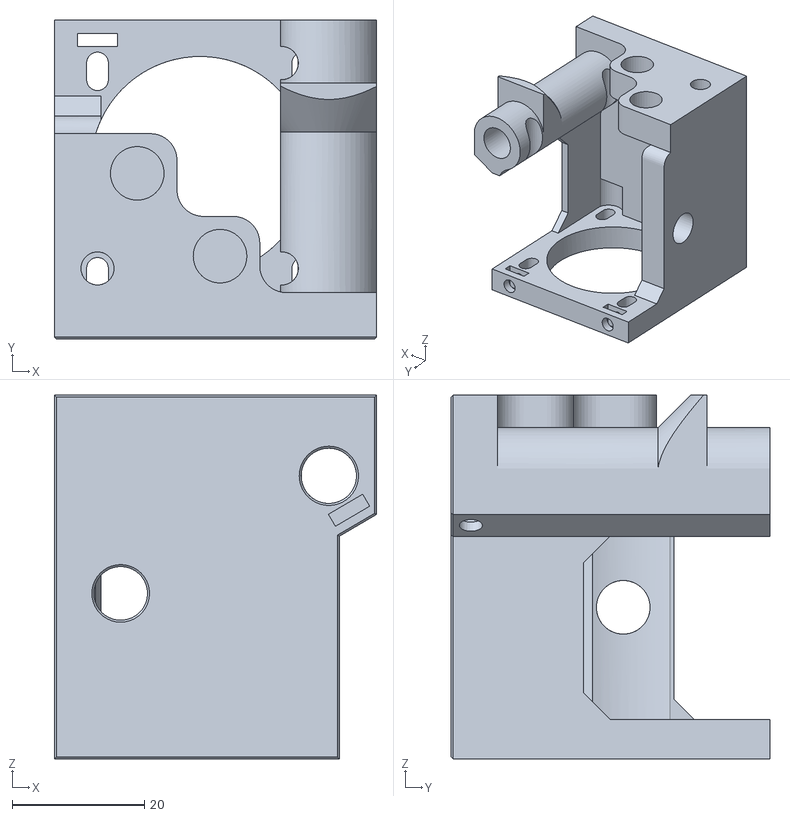
[picture p56: CAD file, 2019-05-24]
Printed Parts/STL/Y Front L.stl
48.6 x 48.1 x 55.0
