HydraResearchLLC/Nautilus-Hardware/Printed Parts/STL/Spool Holder.stl

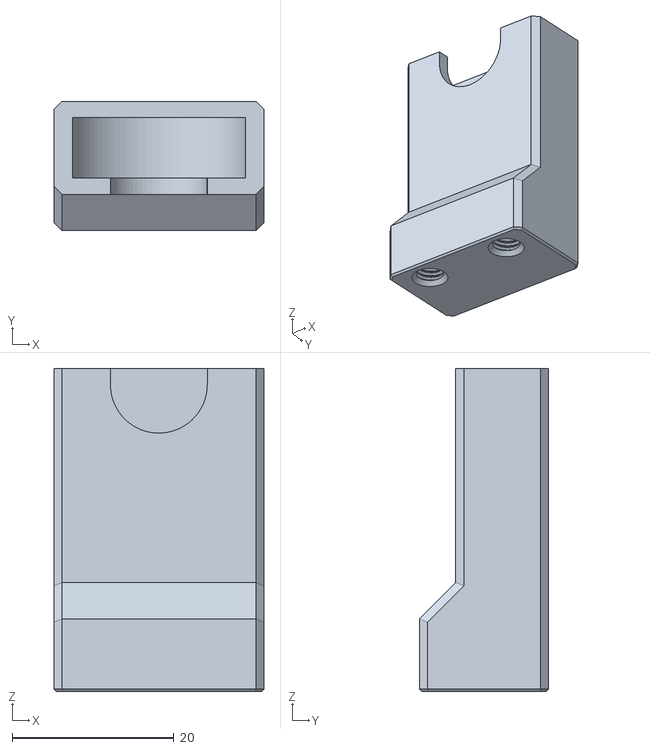
[picture p57: CAD file, 2019-05-24]
Printed Parts/STL/Spool Holder.stl
26.0 x 16.0 x 40.0
