HydraResearchLLC/Nautilus-Hardware/Printed Parts/STL/Extruder Cover.stl

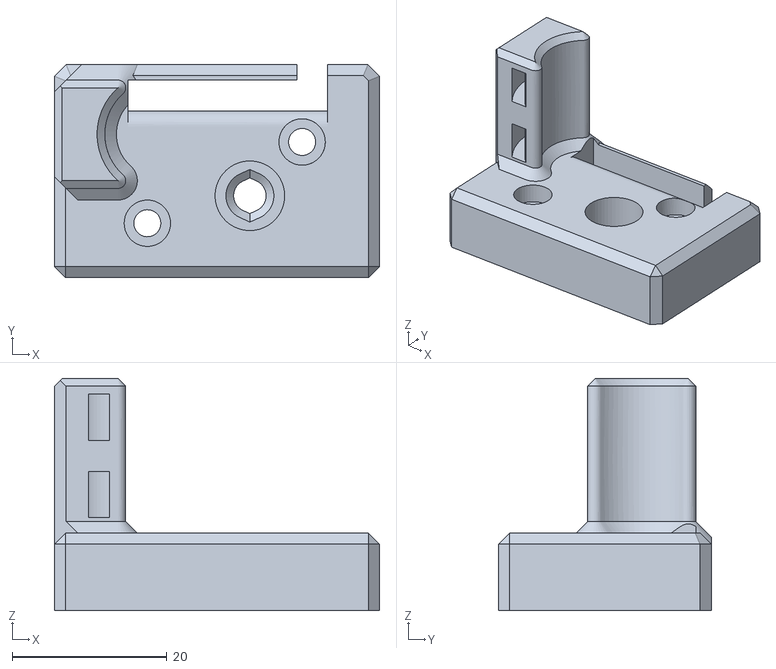
[picture p58: CAD file, 2019-05-24]
Printed Parts/STL/Extruder Cover.stl
42.0 x 27.5 x 30.0
