HydraResearchLLC/Nautilus-Hardware/Printed Parts/STL/Z-Axis Top Mount.stl

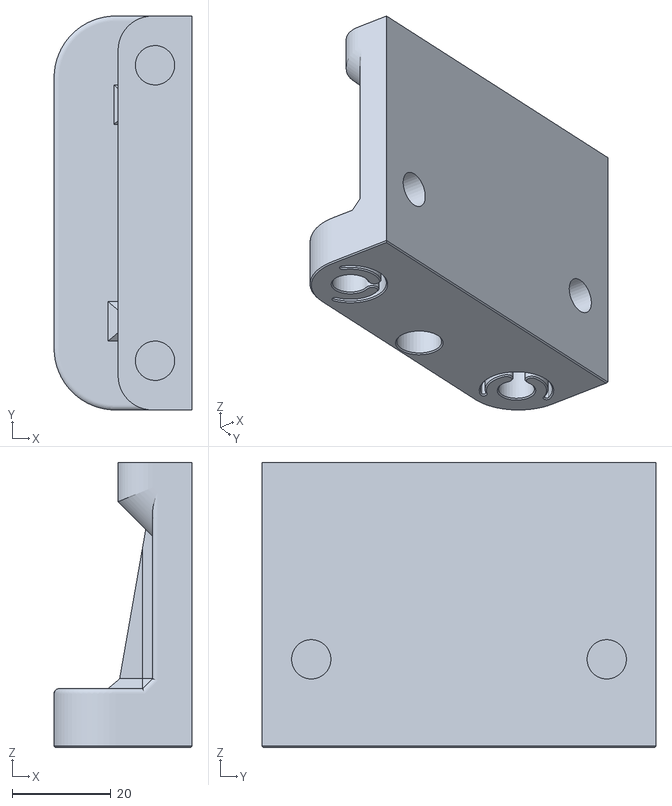
[picture p59: CAD file, 2019-05-24]
Printed Parts/STL/Z-Axis Top Mount.stl
28.0 x 80.0 x 57.9
