HydraResearchLLC/Nautilus-Hardware/Printed Parts/STL/Tool Cartridge Clip.stl

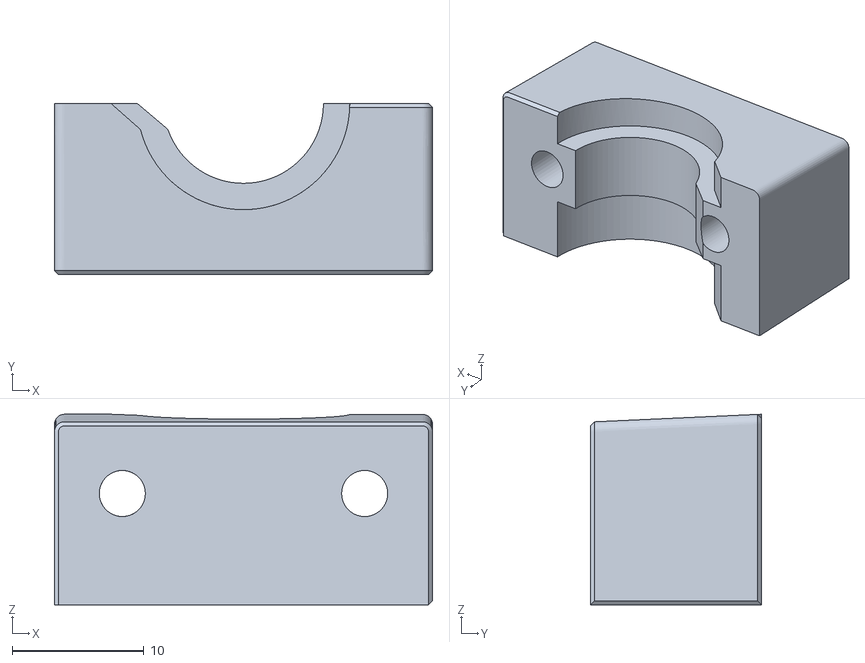
[picture p60: CAD file, 2019-05-24]
Printed Parts/STL/Tool Cartridge Clip.stl
28.7 x 13.0 x 14.5
