HydraResearchLLC/Nautilus-Hardware/Printed Parts/STL/Electronics Enclosure Bracket Tops.stl

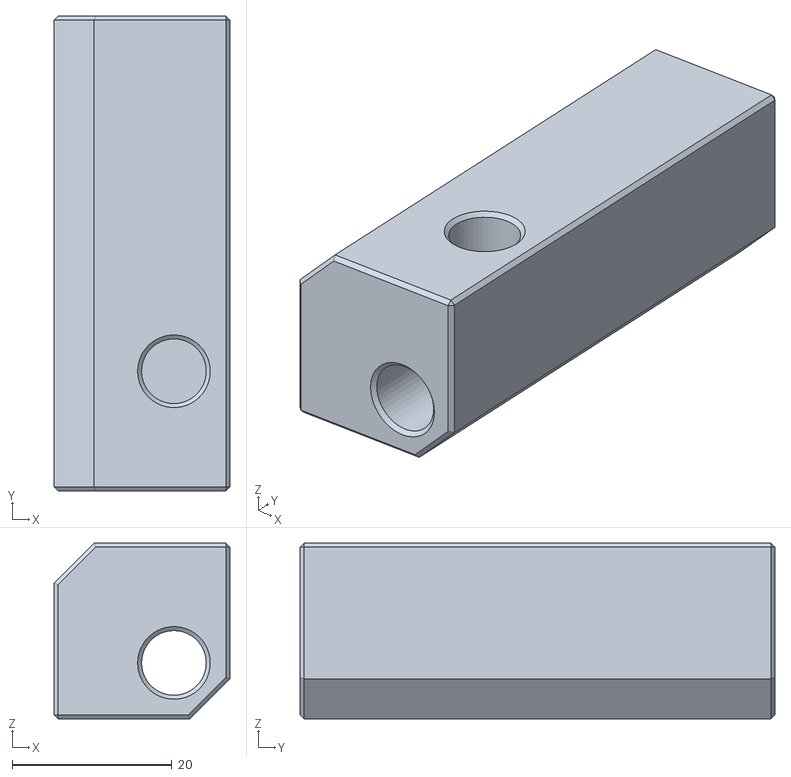
[picture p61: CAD file, 2019-05-24]
Printed Parts/STL/Electronics Enclosure Bracket Tops.stl
22.0 x 59.5 x 22.0
