HydraResearchLLC/Nautilus-Hardware/Printed Parts/STL/Extruder Idle Lever.stl

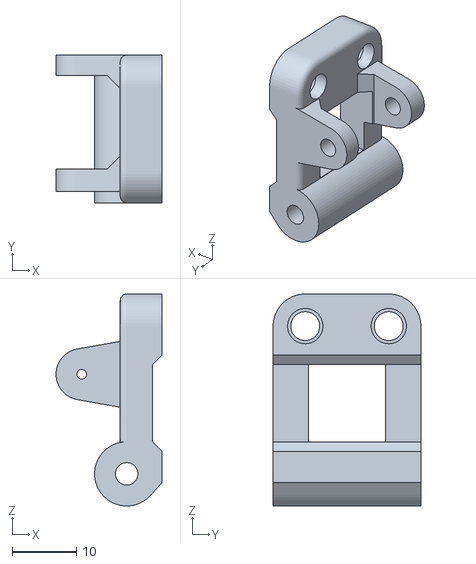
[picture p62: CAD file, 2019-05-24]
Printed Parts/STL/Extruder Idle Lever.stl
16.5 x 23.0 x 33.0
