HydraResearchLLC/Nautilus-Hardware/Printed Parts/STL/Power Inlet Mount.stl

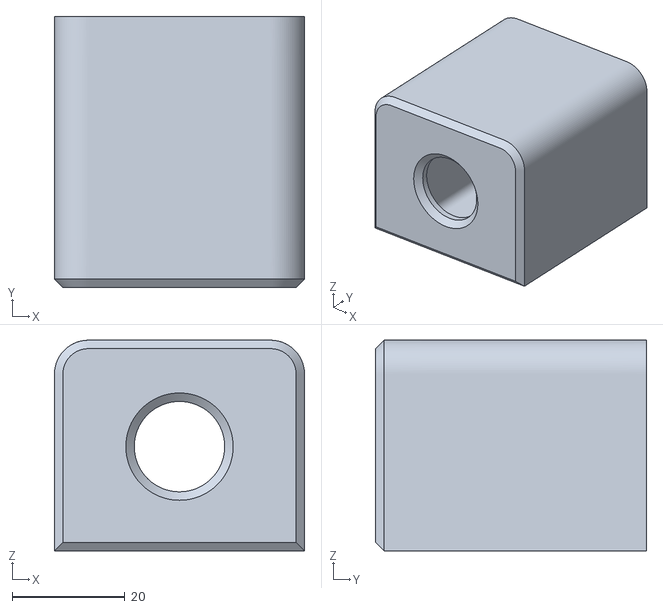
[picture p63: CAD file, 2019-05-24]
Printed Parts/STL/Power Inlet Mount.stl
44.3 x 48.0 x 37.3
