HydraResearchLLC/Nautilus-Hardware/Printed Parts/STL/FIP Body.stl

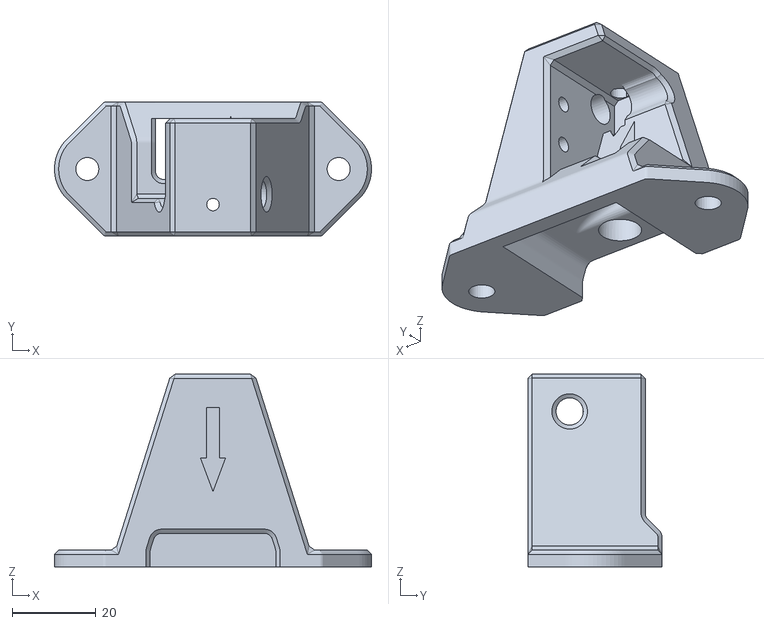
[picture p64: CAD file, 2019-05-24]
Printed Parts/STL/FIP Body.stl
75.7 x 32.0 x 46.0
