HydraResearchLLC/Nautilus-Hardware/Printed Parts/STL/Frame Center Bracket.stl

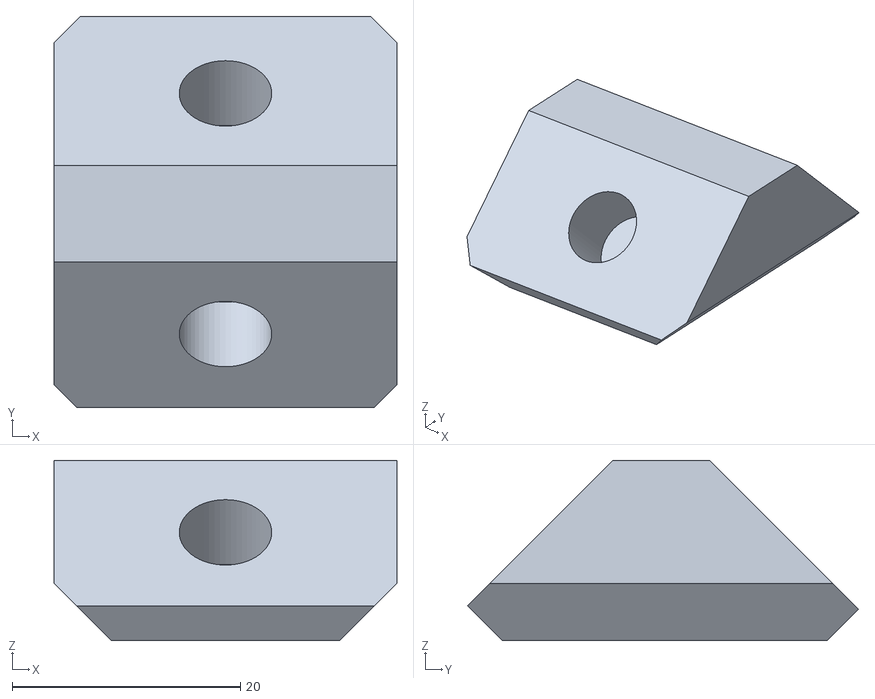
[picture p65: CAD file, 2019-05-24]
Printed Parts/STL/Frame Center Bracket.stl
30.0 x 34.2 x 15.8
