HydraResearchLLC/Nautilus-Hardware/Printed Parts/STL/Y Gantry L.stl

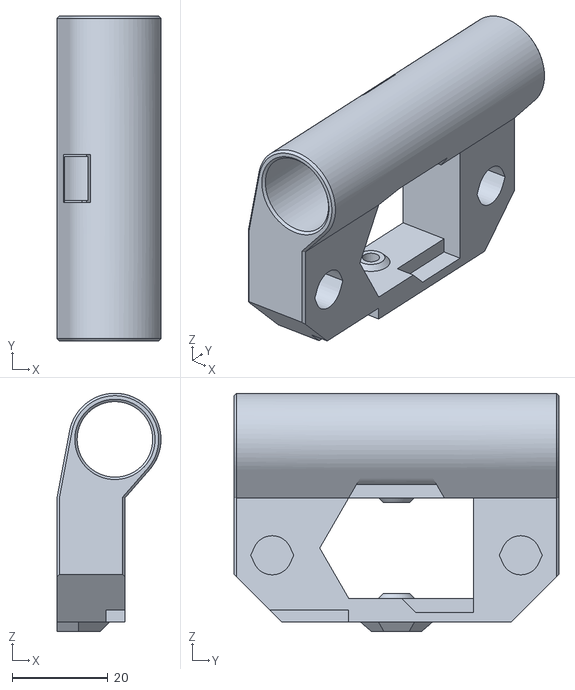
[picture p66: CAD file, 2019-05-24]
Printed Parts/STL/Y Gantry L.stl
21.8 x 68.0 x 49.9
