HydraResearchLLC/Nautilus-Hardware/Printed Parts/STL/Y Gantry R.stl

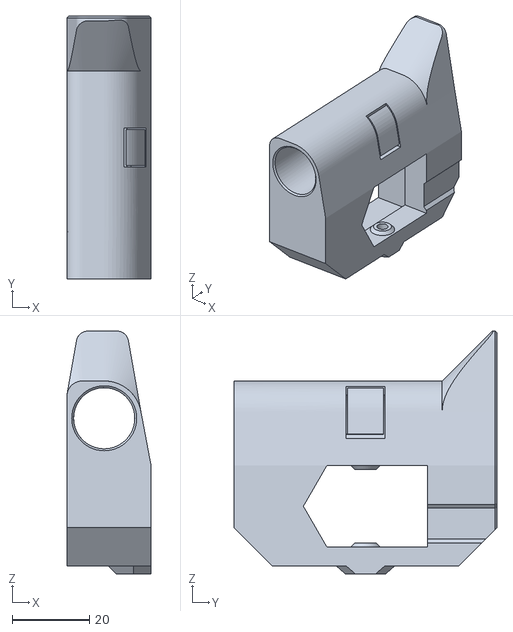
[picture p67: CAD file, 2019-05-24]
Printed Parts/STL/Y Gantry R.stl
21.8 x 68.0 x 62.8
