HydraResearchLLC/Nautilus-Hardware/Printed Parts/STL/Frame Conner Bracket.stl

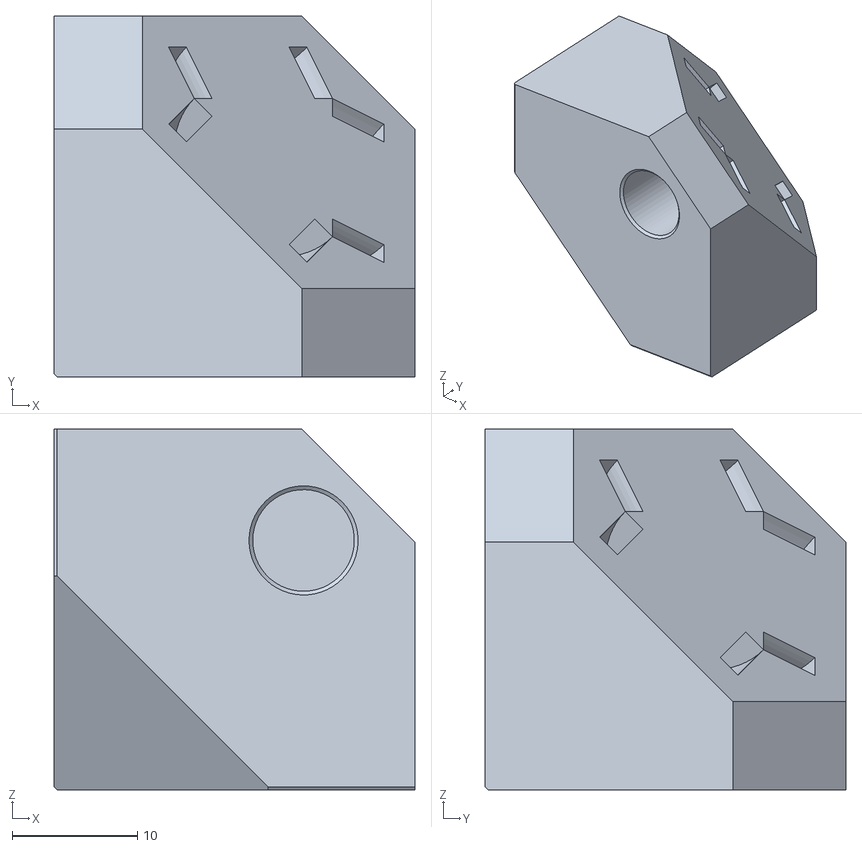
[picture p68: CAD file, 2019-05-24]
Printed Parts/STL/Frame Conner Bracket.stl
28.8 x 28.8 x 28.8
