HydraResearchLLC/Nautilus-Hardware/Printed Parts/STL/Y Front R.stl

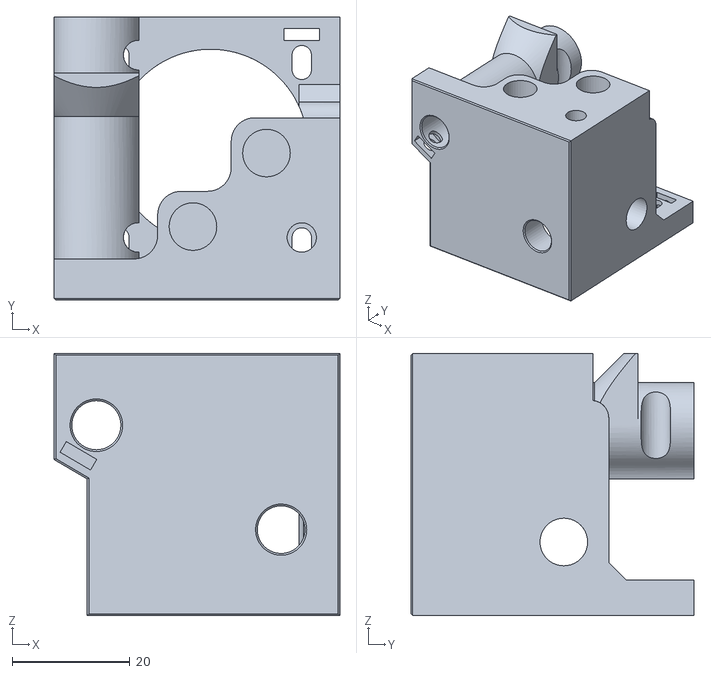
[picture p69: CAD file, 2019-05-24]
Printed Parts/STL/Y Front R.stl
48.6 x 48.1 x 44.6
