HydraResearchLLC/Nautilus-Hardware/Printed Parts/STL/Tool Head Cover.stl

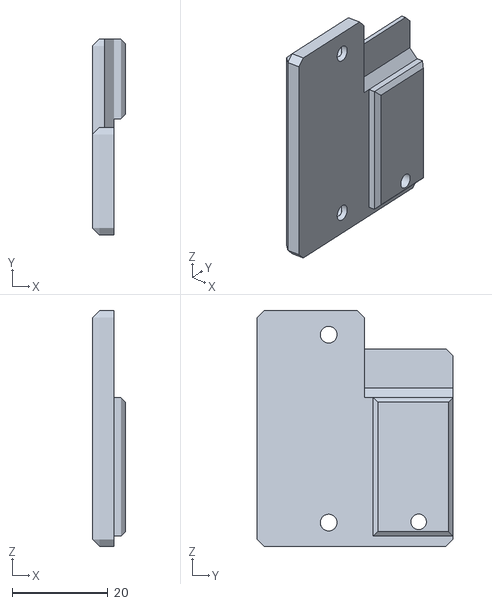
[picture p70: CAD file, 2019-05-24]
Printed Parts/STL/Tool Head Cover.stl
6.95 x 41.0 x 49.3
