HydraResearchLLC/Nautilus-Hardware/Printed Parts/STL/FIP Arrow.stl

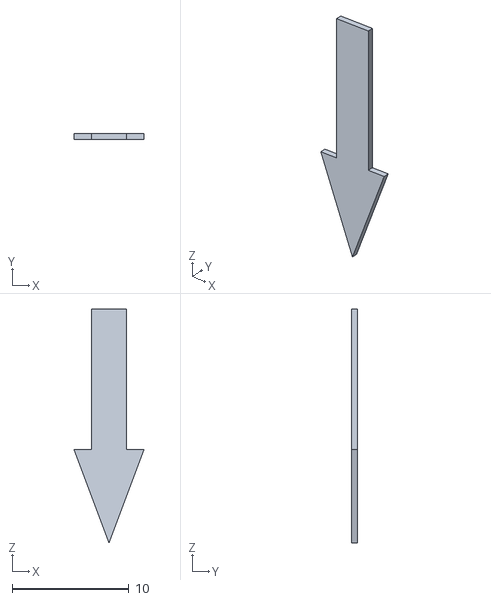
[picture p71: CAD file, 2019-05-24]
Printed Parts/STL/FIP Arrow.stl
6.00 x 0.5 x 20.0
