HydraResearchLLC/Nautilus-Hardware/Printed Parts/STL/Fume Vent Cover.stl

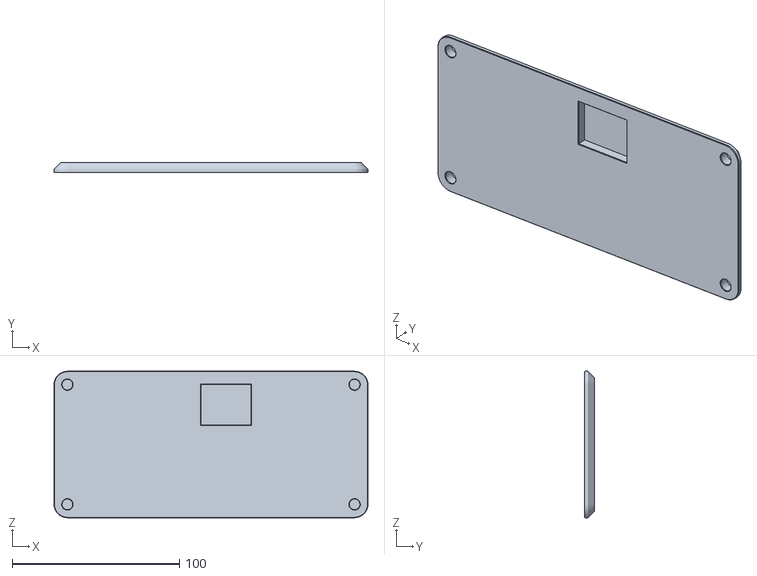
[picture p72: CAD file, 2019-05-24]
Printed Parts/STL/Fume Vent Cover.stl
187.5 x 6.00 x 87.5
