HydraResearchLLC/Nautilus-Hardware/Printed Parts/STL/Purge Bucket Mount.stl

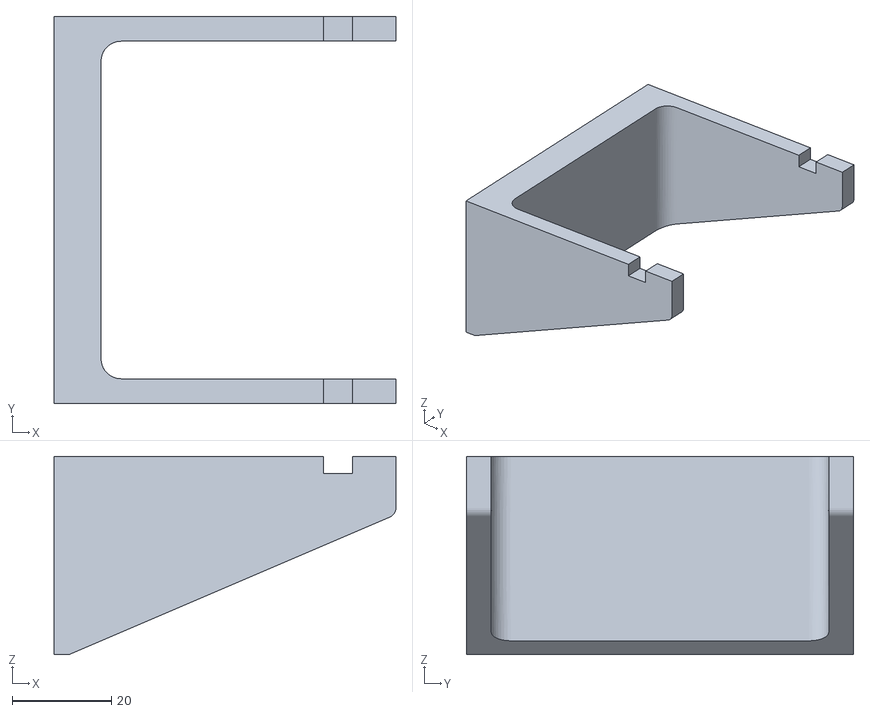
[picture p73: CAD file, 2019-05-24]
Printed Parts/STL/Purge Bucket Mount.stl
69.0 x 78.1 x 40.0
