HydraResearchLLC/Nautilus-Hardware/Printed Parts/STL/Z Carriage.stl

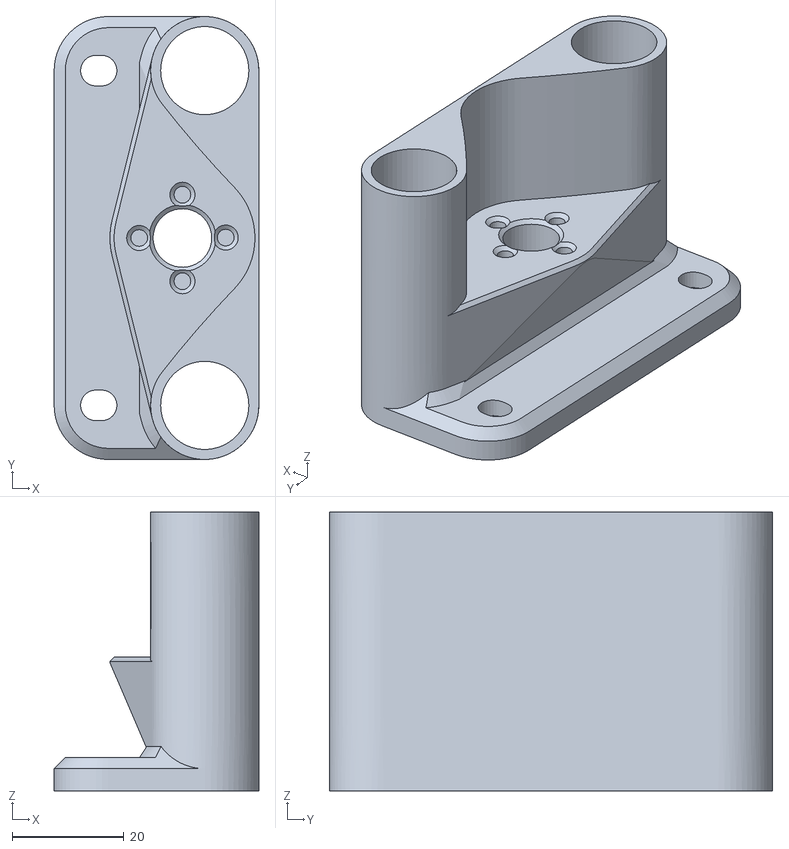
[picture p74: CAD file, 2019-05-24]
Printed Parts/STL/Z Carriage.stl
36.7 x 79.4 x 50.0
