HydraResearchLLC/Nautilus-Hardware/(list of files, cad)

Other CAD files:
Nautilus PCBs/Tool Head PCB/Too Head PCB REV0.3/Too Head PCB REV0.3/OUTPUT/ExportSTEP/PCB1.step
Nautilus PCBs/Tool PCB/Tool Rev 0.4/REV0.4/REV0.4/OUTPUT/ExportSTEP/REV04.step
Printed Parts/STL/Y Back R.stl
Printed Parts/STL/IO Cover Plate/IO a (1).stl
Printed Parts/STL/Tool Cartridge X 800.stl
Printed Parts/STL/Tool Cartridge X 400.stl
Acrylic Enclosure/Acrylic Enclosure Rev0.2/Back rev0.2.dxf
Acrylic Enclosure/Acrylic Enclosure Rev0.2/Bottom rev0.2.dxf
Acrylic Enclosure/Acrylic Enclosure Rev0.2/Door rev0.2.dxf
Acrylic Enclosure/Acrylic Enclosure Rev0.2/Electronics Enclosure Back rev0.2.dxf
Acrylic Enclosure/Acrylic Enclosure Rev0.2/Front rev0.2.dxf
Acrylic Enclosure/Acrylic Enclosure Rev0.2/Side L rev0.2.dxf
Acrylic Enclosure/Acrylic Enclosure Rev0.2/Side R rev0.2.dxf
Acrylic Enclosure/Acrylic Enclosure Rev0.2/Top rev 0.2.dxf
Acrylic Enclosure/Acrylic Enclosure Rev0.2/XY rev0.2.dxf
Acrylic Enclosure/Acrylic Enclosure Rev0.3/Top Rev0.3.dxf
Acrylic Enclosure/Acrylic Enclosure Rev0.4/Back rev0.4.dxf
Acrylic Enclosure/Acrylic Enclosure Rev0.4/Bottom rev0.4.dxf
Acrylic Enclosure/Acrylic Enclosure Rev0.4/Door rev0.4.dxf
Acrylic Enclosure/Acrylic Enclosure Rev0.4/Electronics Enclosure rev0.4.dxf
Acrylic Enclosure/Acrylic Enclosure Rev0.4/Front rev0.4.dxf
Acrylic Enclosure/Acrylic Enclosure Rev0.4/Side L rev0.4.dxf
Acrylic Enclosure/Acrylic Enclosure Rev0.4/Side R rev0.4.dxf
Acrylic Enclosure/Acrylic Enclosure Rev0.4/Top rev0.4.1.dxf
Acrylic Enclosure/Acrylic Enclosure Rev0.4/Top rev0.4.2.dxf
Acrylic Enclosure/Acrylic Enclosure Rev0.4/Top rev0.4.dxf
Acrylic Enclosure/Acrylic Enclosure Rev0.4/XYZ rev0.4.dxf
Acrylic Enclosure/Acrylic Enclosure Rev0.5/Back Rev0.5.dxf
Acrylic Enclosure/Acrylic Enclosure Rev0.5/Bottom Rev0.5.dxf
Acrylic Enclosure/Acrylic Enclosure Rev0.5/Door Rev0.5.dxf
Acrylic Enclosure/Acrylic Enclosure Rev0.5/Electronics Back Rev0.5.dxf
Acrylic Enclosure/Acrylic Enclosure Rev0.5/Front Rev0.5.dxf
Acrylic Enclosure/Acrylic Enclosure Rev0.5/Side L Rev0.5.dxf
Acrylic Enclosure/Acrylic Enclosure Rev0.5/Side R Rev0.5.dxf
Acrylic Enclosure/Acrylic Enclosure Rev0.5/Top Rev0.5.dxf
Acrylic Enclosure/Acrylic Enclosure Rev0.5/Top Single Rev0.5.1.dxf
Acrylic Enclosure/Acrylic Enclosure Rev0.5/XYZ Rev0.5.dxf
Acrylic Enclosure/Acrylic Enclosure Rev0.9/Frame Side L Rev0.9.dxf
Acrylic Enclosure/Acrylic Enclosure Rev0.9/Frame Side R Rev0.9.dxf
Acrylic Enclosure/Acrylic Enclosure Rev0.9/Top Rev0.9.dxf
Acrylic Enclosure/Acrylic Enclosure Rev0.9/XYZ Rev0.9.dxf
Machined Parts/Build Plate/Build Plate Rev0.2/Build Plate Rev0.2.iges
Machined Parts/Build Plate/Build Plate Rev0.8/Build Plate Rev0.8.step
Machined Parts/Build Plate/Build Plate rev0.3/Build Plate rev0.3.iges
Machined Parts/Build Plate/Build Plate rev0.4/Build Plate rev0.4.iges
Machined Parts/Build Plate/Build Plate rev0.5/Build Plate rev0.iges
Machined Parts/Build Plate/Build Plate rev0.6/Build Plate rev0.iges
Machined Parts/Build Plate/Build Plate rev0.7/Build Plate Rev0.7.step
Machined Parts/Build Plate/Build Plate rev0.7/Build Plate rev0.7.iges
Machined Parts/Build Plate/Build Plate rev0.7/Build Plate v127.step
Machined Parts/Print Surface/Build Surface rev0.2.dxf
Machined Parts/Print Surface/Build Surface rev0.3.dxf
Machined Parts/Print Surface/Build Surface rev0.5 (no graphics).dxf
Machined Parts/Print Surface/Build Surface rev0.6 (no graphics).dxf
Printed Parts/STL/IO Cover Plate/IO F (1).stl
Printed Parts/STL/IO Cover Plate/IO O (1).stl
Printed Parts/STL/IO Cover Plate/IO n (2).stl
