HydraResearchLLC/Nautilus-Hardware/Machined Parts/Print Surface/Print-Surface-Marking-PEI-rev0.4.pdf

NAUTILUS PRINT SURFACE HYDRATM

RESEARCH | BuildTak TM PEI
