HydraResearchLLC/Nautilus-Hardware/Machined Parts/Belt Tensioner/Belt Tensioner Drawing V1.pdf

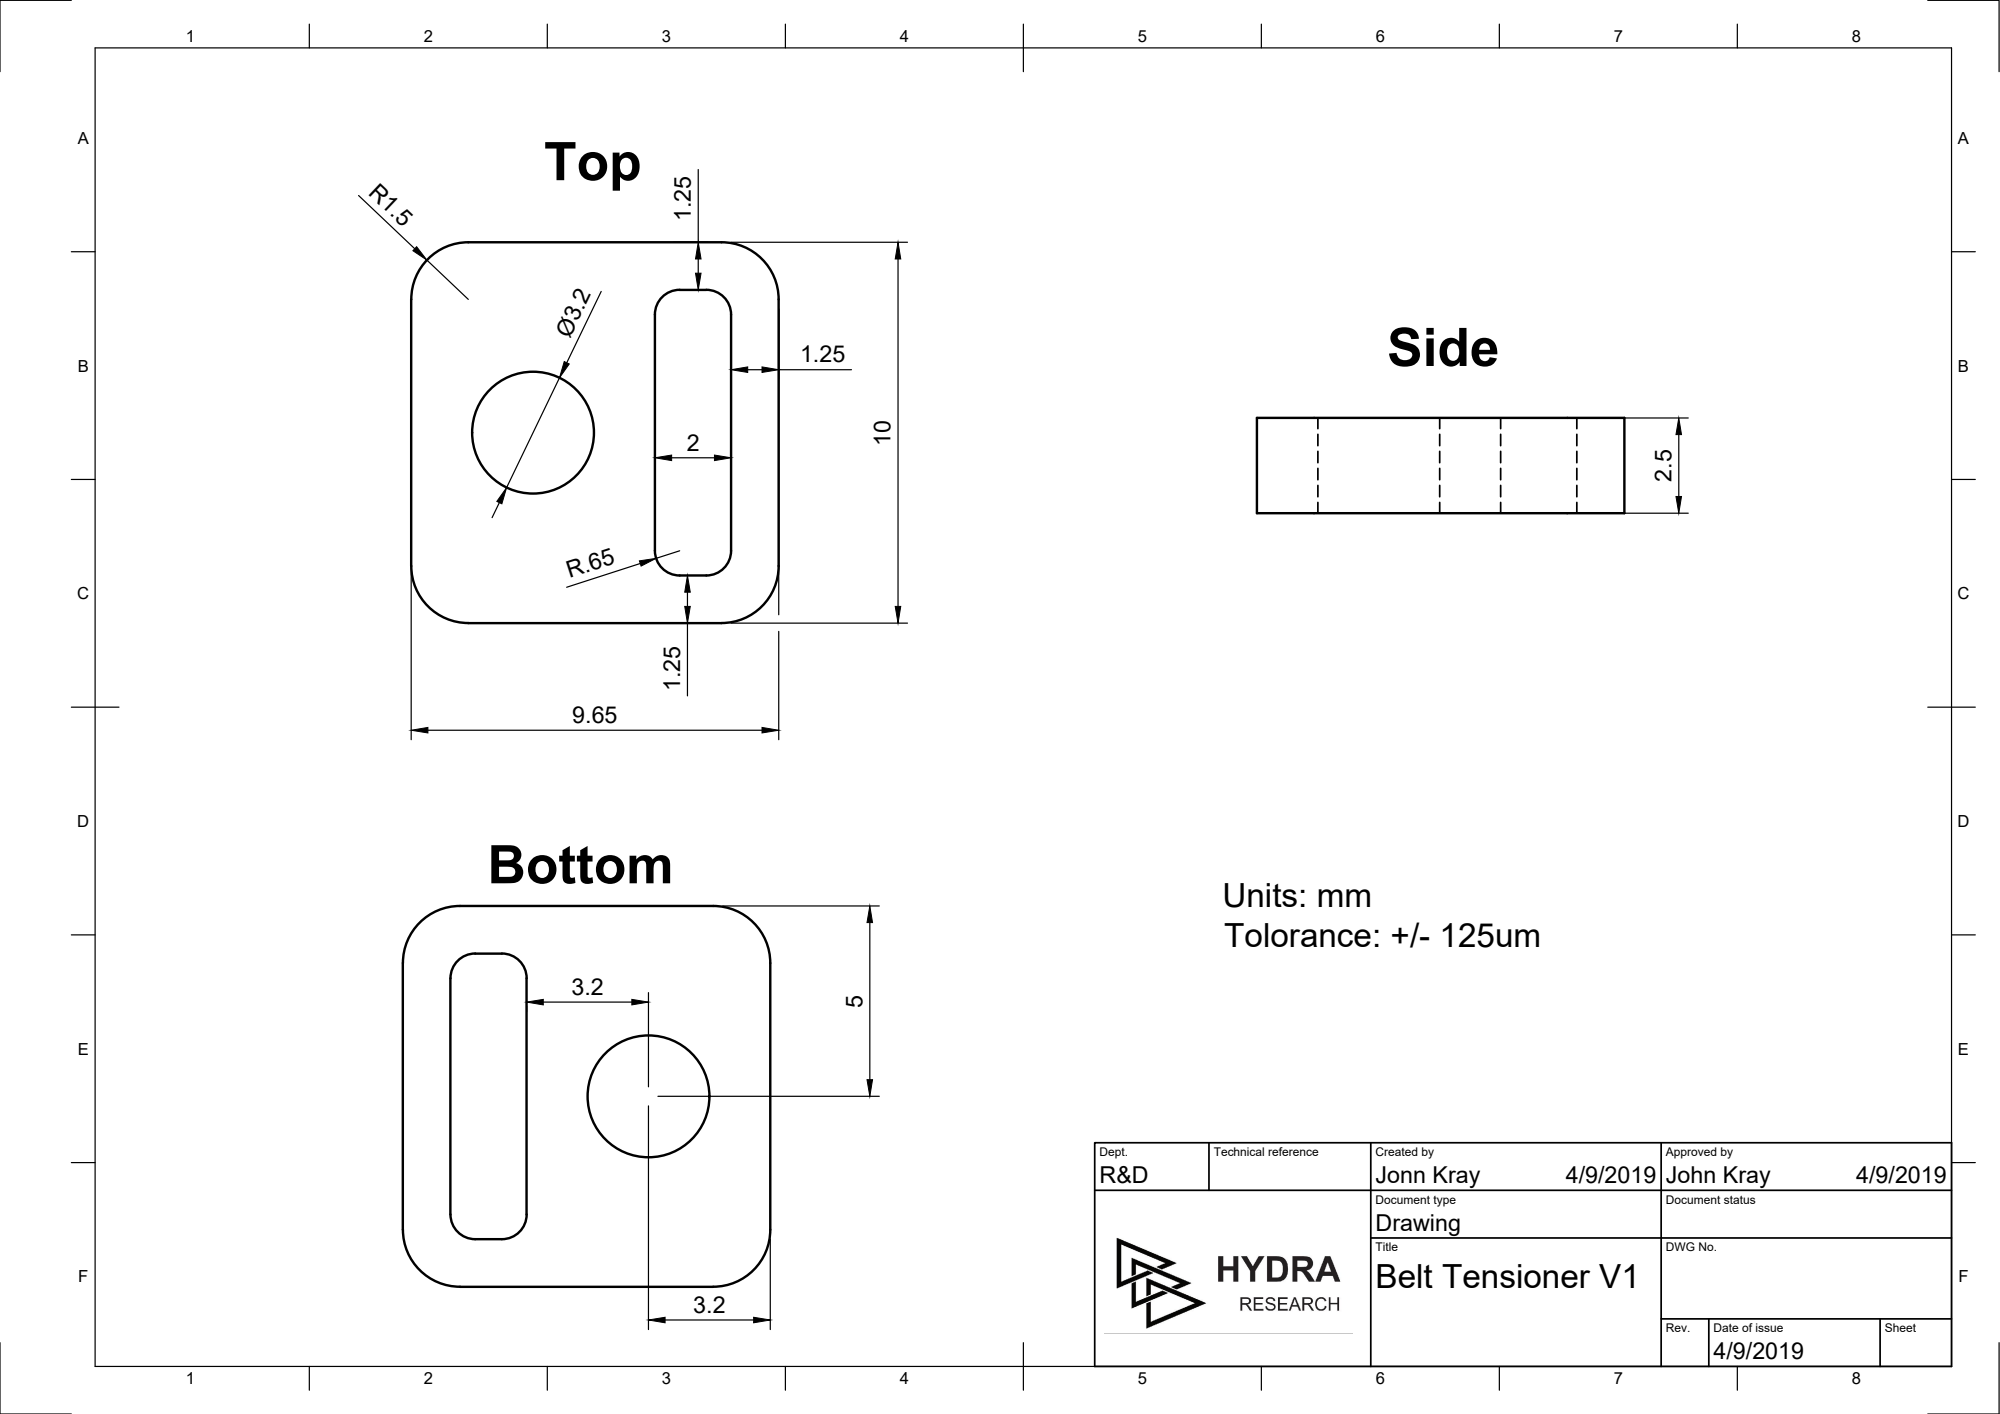
[picture p75: page 1]
Units: mm Tolorance: +/- 125um

Dept. R&D | Technical reference | Created by Jonn Kray 4/9/2019 | Approved by John Kray 4/9/2019

Document type Drawing | Document status

Title Belt Tensioner V1 | DWG No.

Rev. | Date of issue 4/9/2019 | Sheet
