HydraResearchLLC/Nautilus-Hardware/Machined Parts/Print Surface/Print Surface Dwaring (not text).pdf

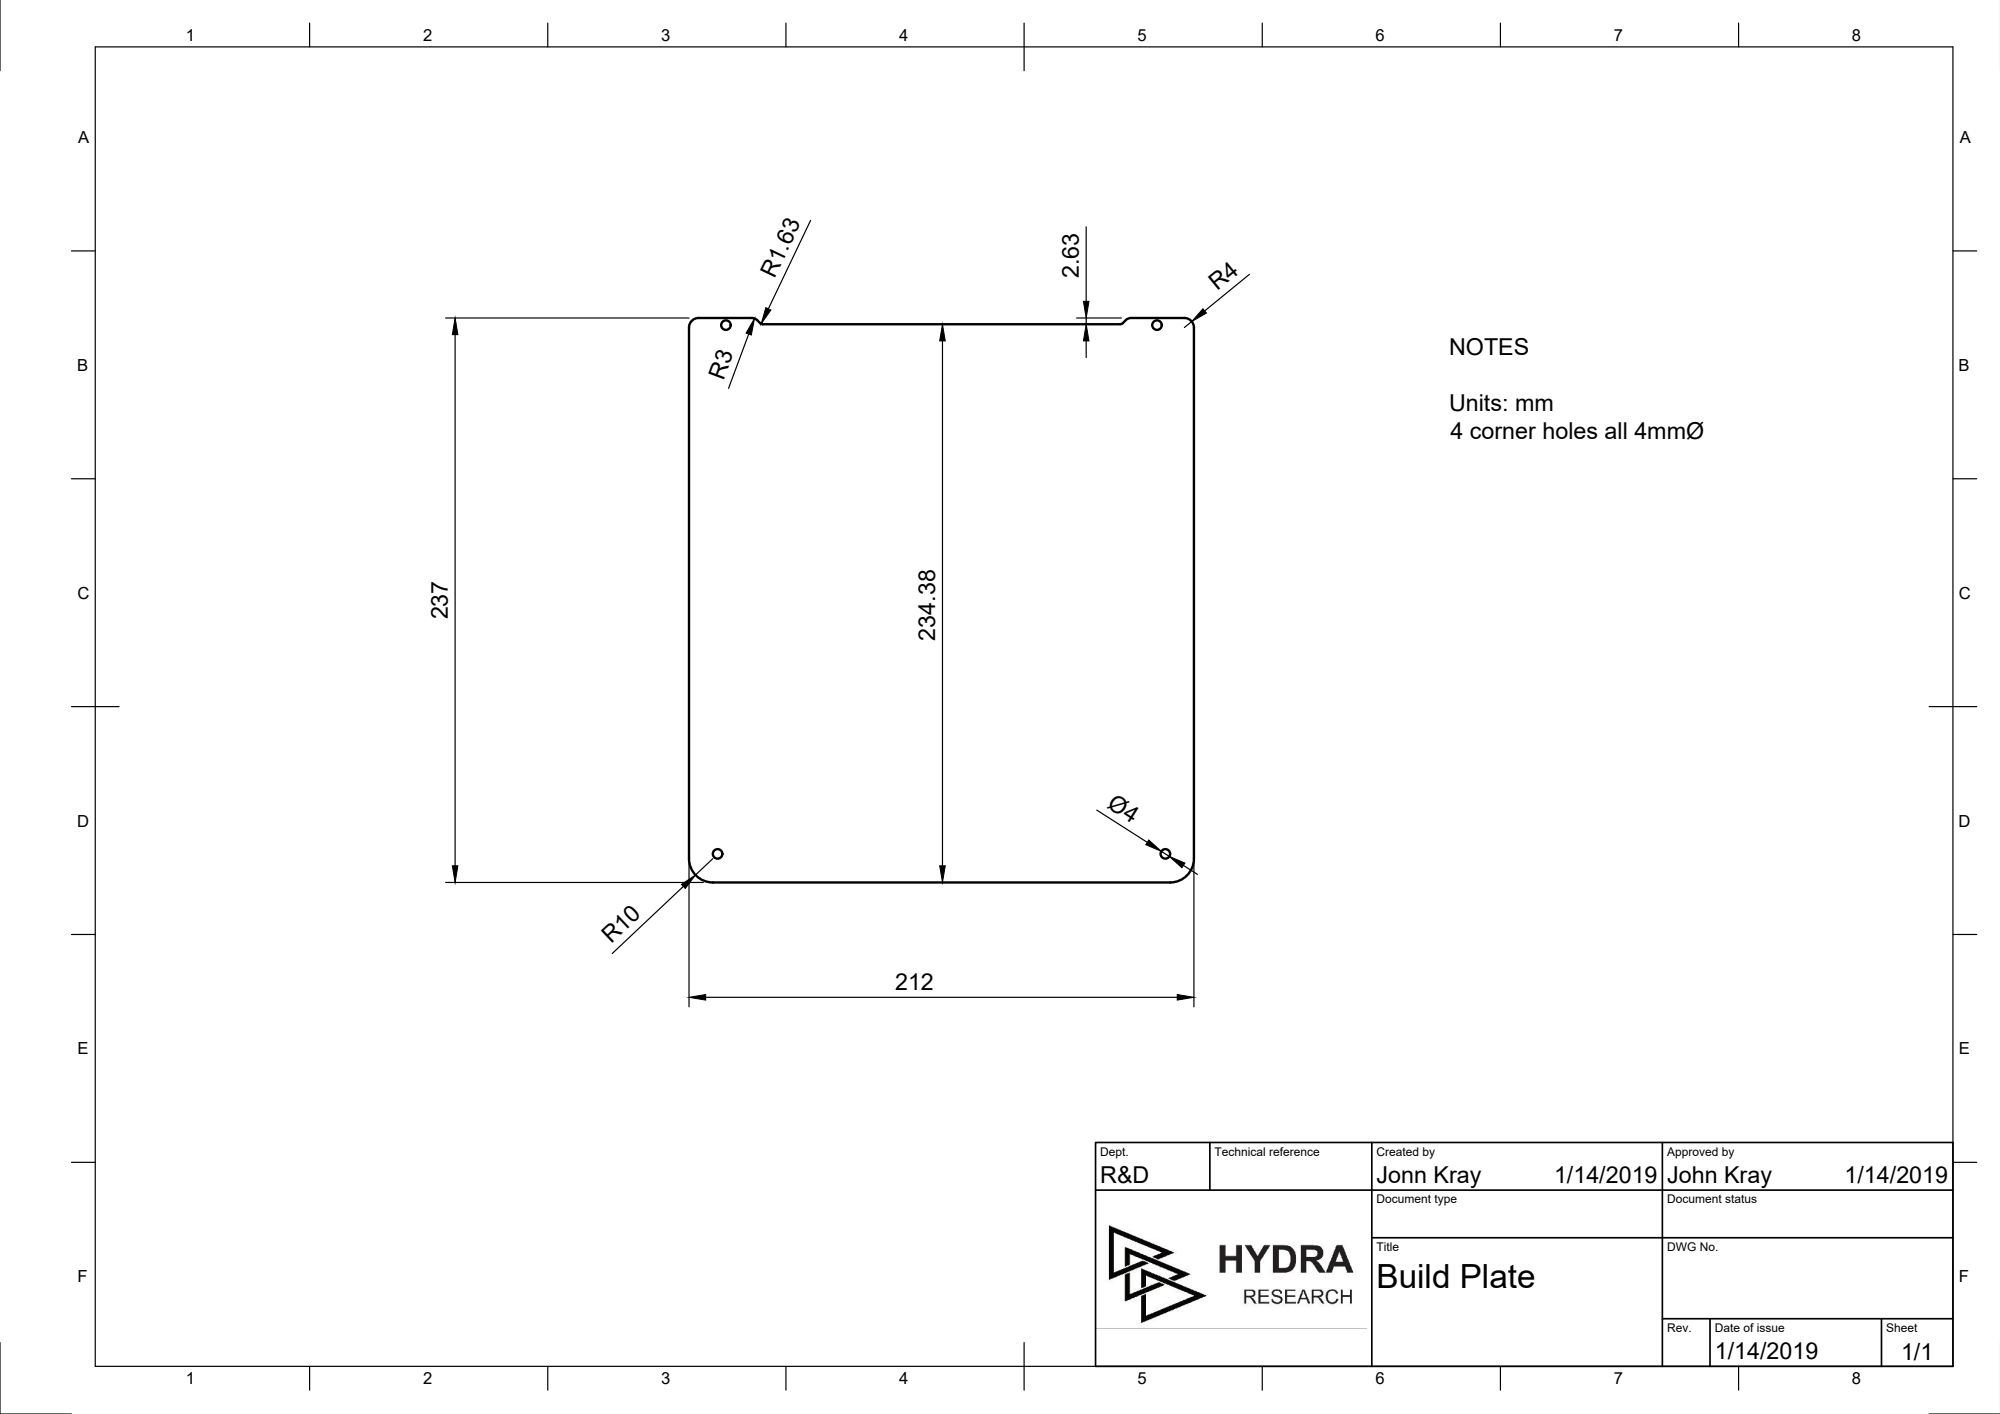
[picture p76: page 1]
R3 NOTES

Units: mm
4 corner holes all 4mmØ

Dept. R&D | Technical reference | Created by Jonn Kray 1/14/2019 | Approved by John Kray 1/14/2019

Document type | Document status

Title Build Plate | DWG No.

Rev. | Date of issue 1/14/2019 | Sheet 1/1
