HydraResearchLLC/Nautilus-Hardware/Machined Parts/Build Plate/Build Plate Rev0.9/Build Plate Drawing Rev0.9.pdf

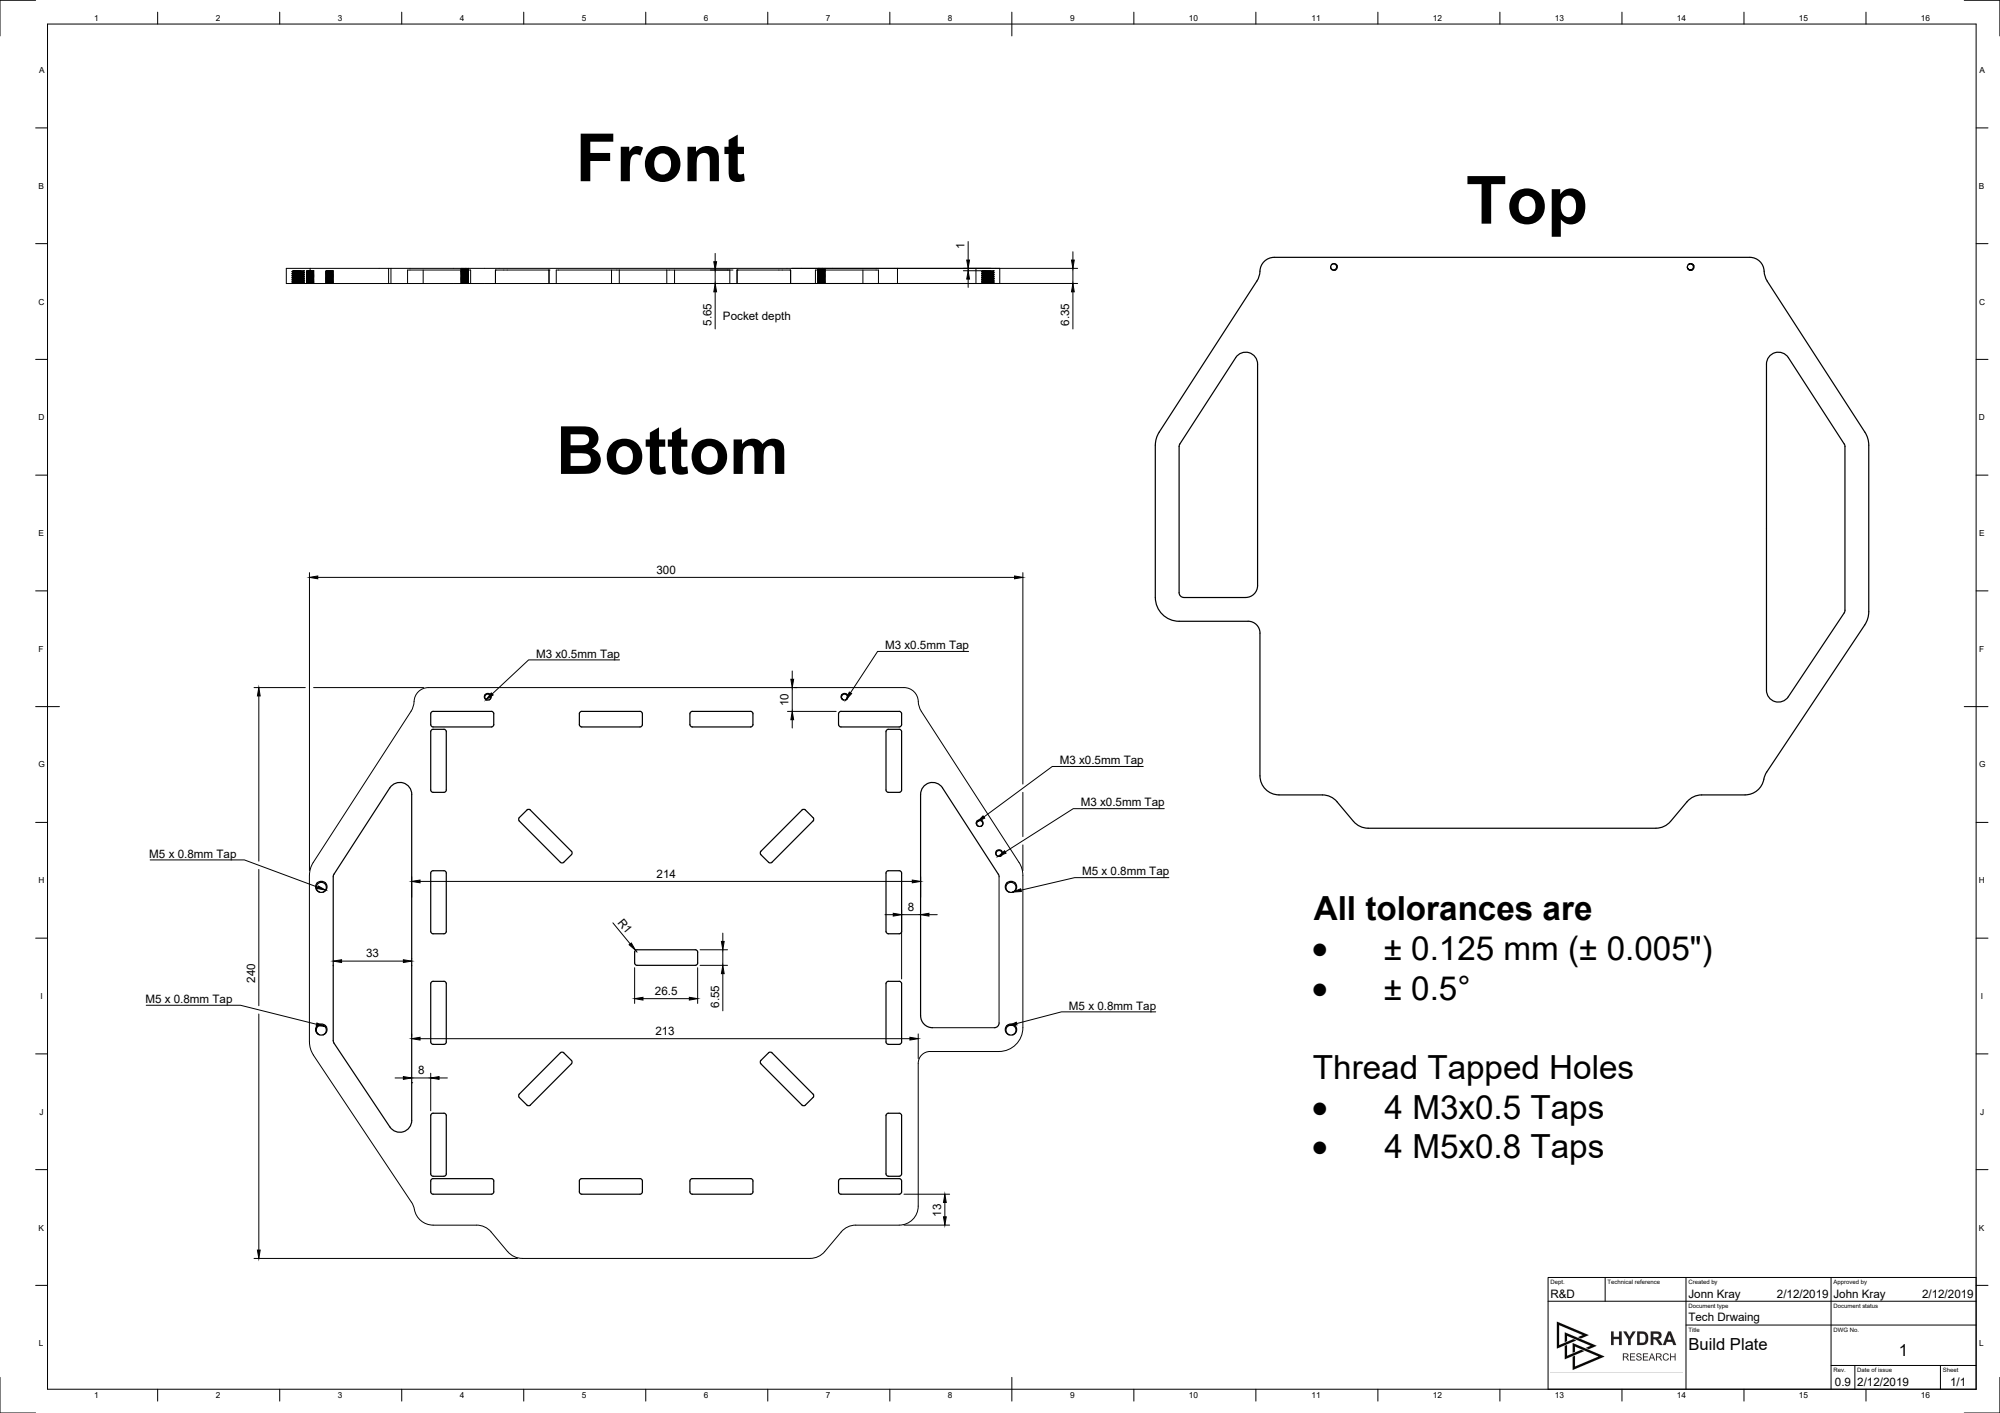
[picture p77: page 1]
M3 x0.5mm Tap; M3 x0.5mm Tap M3 x0.5mm Tap; M5 x 0.8mm Tap; All tolorances are · ± 0.125 mm (± 0.005") · ± 0.5°; Pocket depth

Thread Tapped Holes
· 4 M3x0.5 Taps
· 4 M5x0.8 Taps

Dept. R&D | Technical reference | Created by Jonn Kray 2/12/2019 | Approved by John Kray 2/12/2019

Document type Tech Drwaing | Document status

Title | DWG No. 1 Build Plate

Rev. 0.9 | Date of issue 2/12/2019 | Sheet 1/1
