HydraResearchLLC/Nautilus-Hardware/Nautilus PCBs/EIP PCB/EIP PCB Rev0.1/Extruders In Parallel PCB Drawing v2.pdf

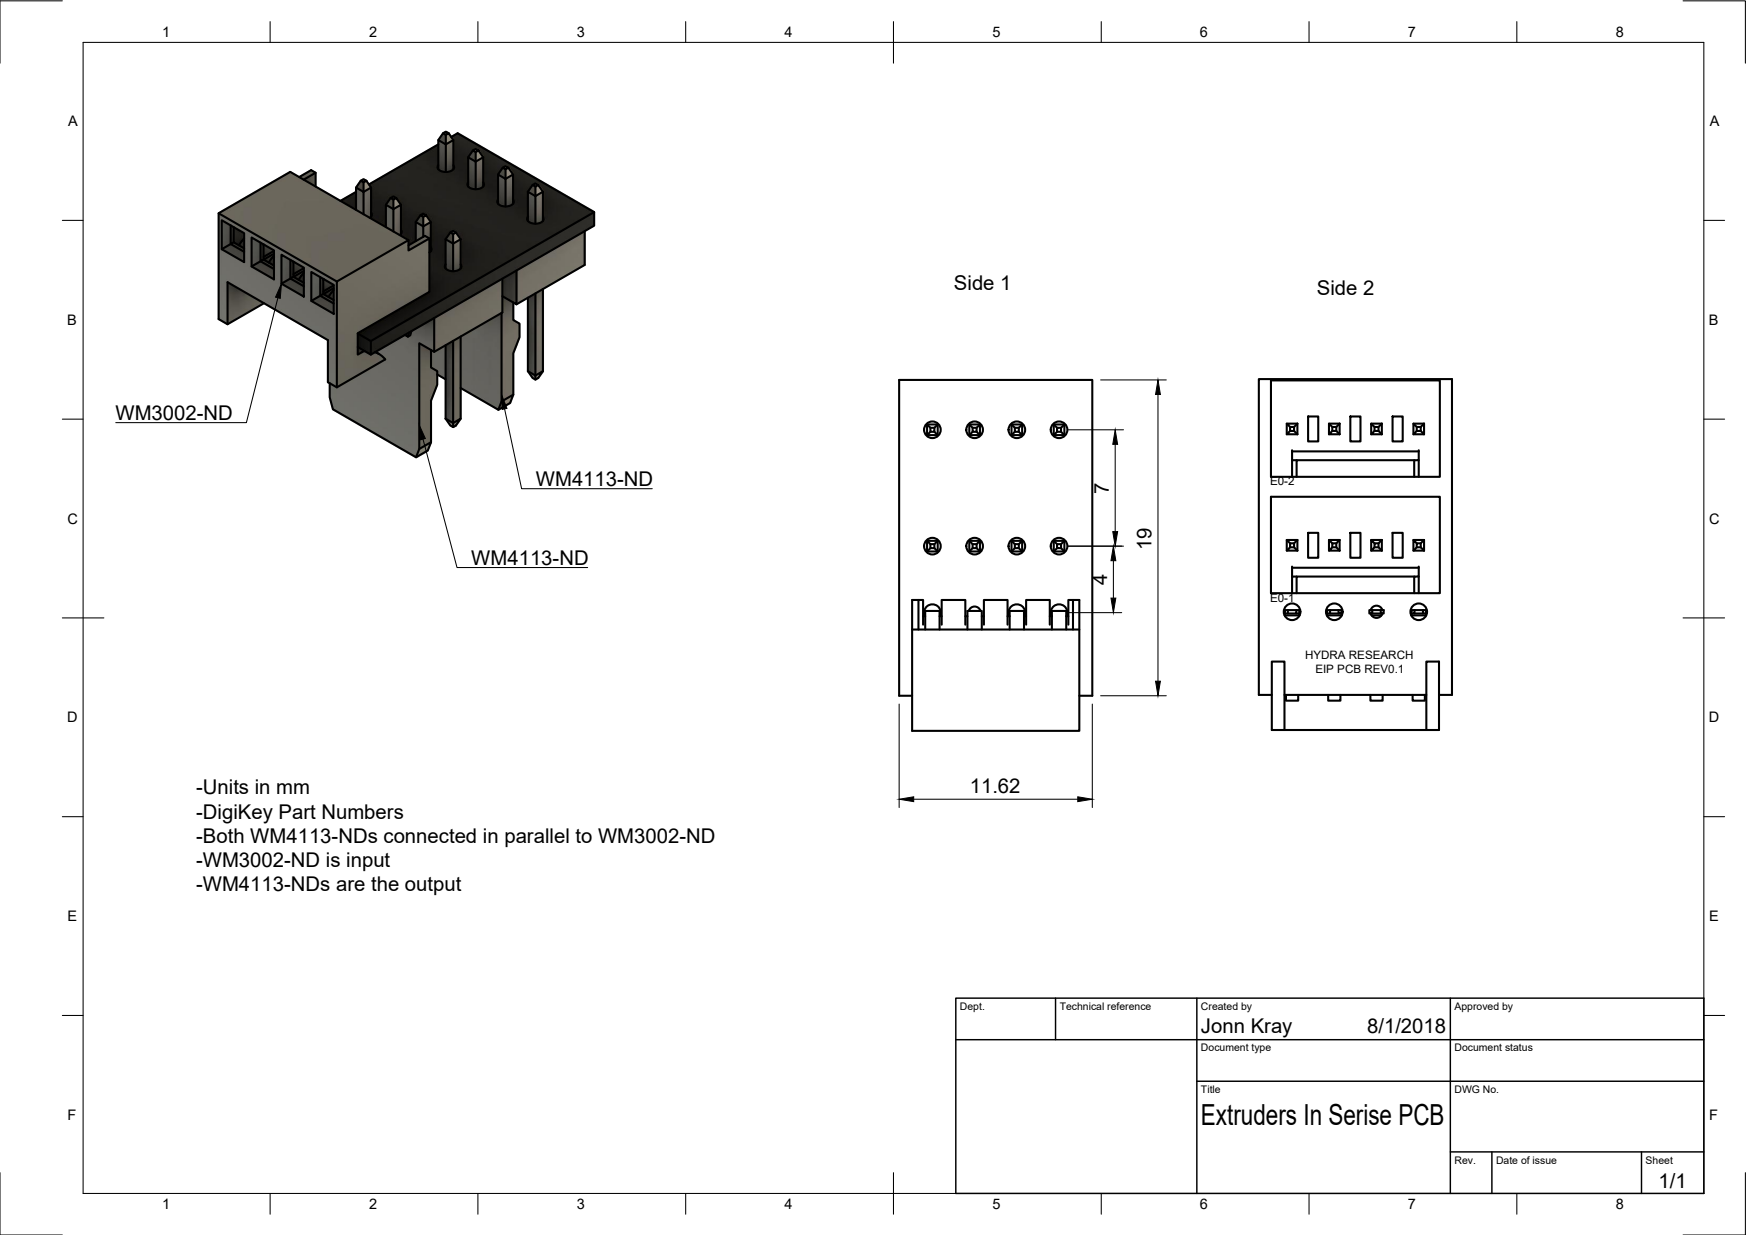
[picture p78: page 1]
HYDRA RESEARCH EIP PCB REV0.1; Side 1; Side 2

-Units in mm
-DigiKey Part Numbers
-Both WM4113-NDs connected in parallel to WM3002-ND
-WM3002-ND is input
-WM4113-NDs are the output

Dept. | Technical reference | Created by 8/1/2018 Jonn Kray | Approved by

Document type | Document status

Title Extruders In Serise PCB | DWG No.

Rev. | Date of issue | Sheet 1/1
