HydraResearchLLC/Nautilus-Hardware/Nautilus PCBs/Tool Head PCB/Tool Head PCB Rev0.4/Tool Head PCB Drawing Rev0.4.pdf

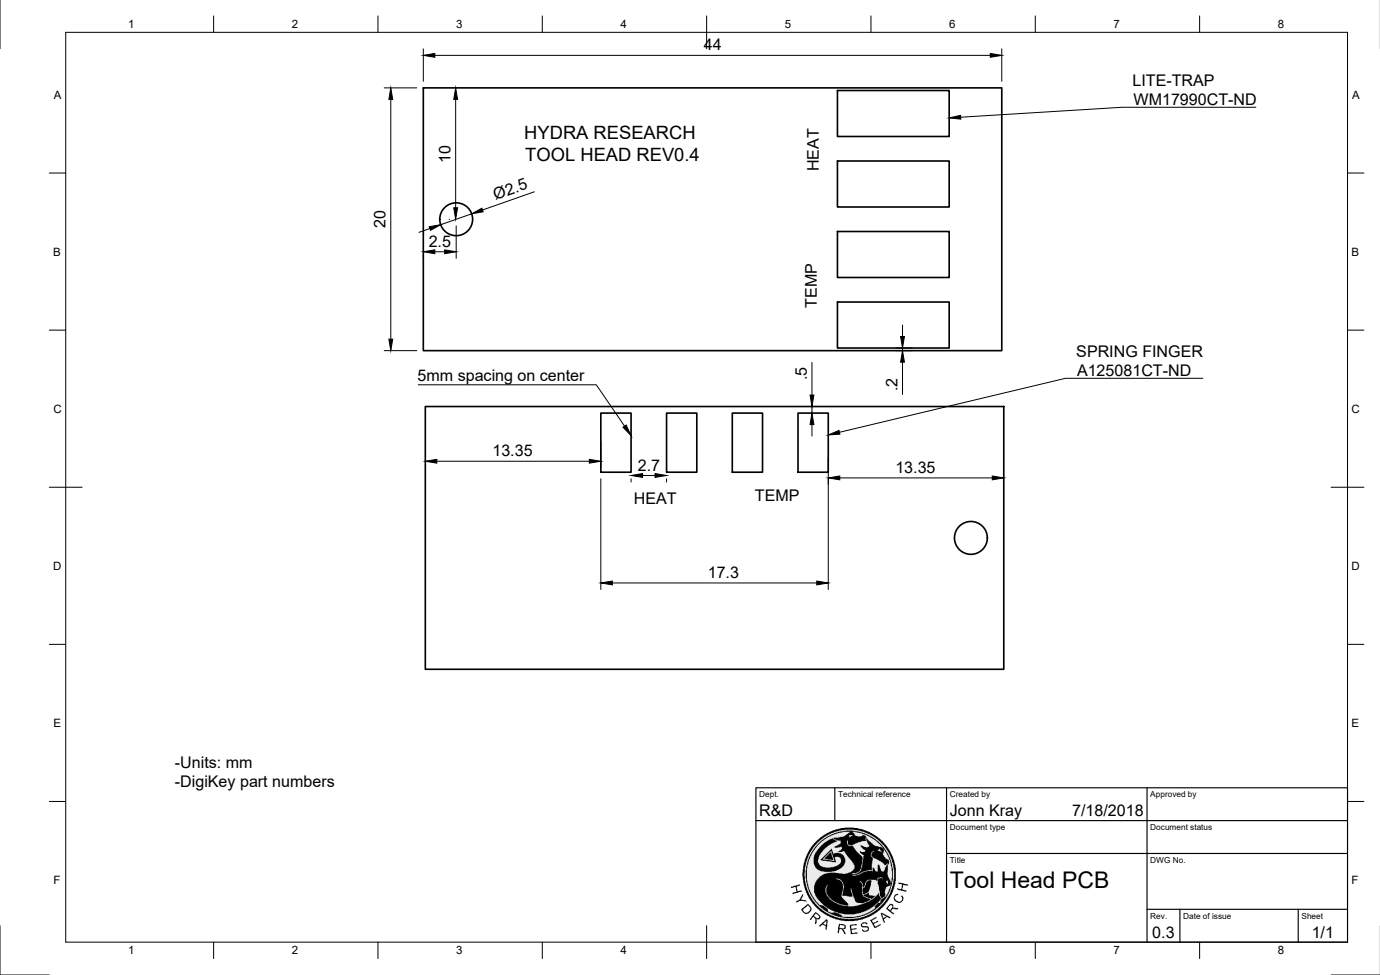
[picture p79: page 1]
HYDRA RESEARCH TOOL HEAD REV0.4; SPRING FINGER; HEAT; TEMP HEAT TEMP

5mm spacing on center

-Units: mm
-DigiKey part numbers

Dept. R&D | Technical reference | Created by Jonn Kray 7/18/2018 | Approved by

Document type | Document status

Title Tool Head PCB | DWG No.

Rev. 0.3 | Date of issue | Sheet 1/1
