HydraResearchLLC/Nautilus-Hardware/Nautilus PCBs/Tool PCB/Tool Rev 0.4/Tool PCB Drawing Rev0.4.pdf

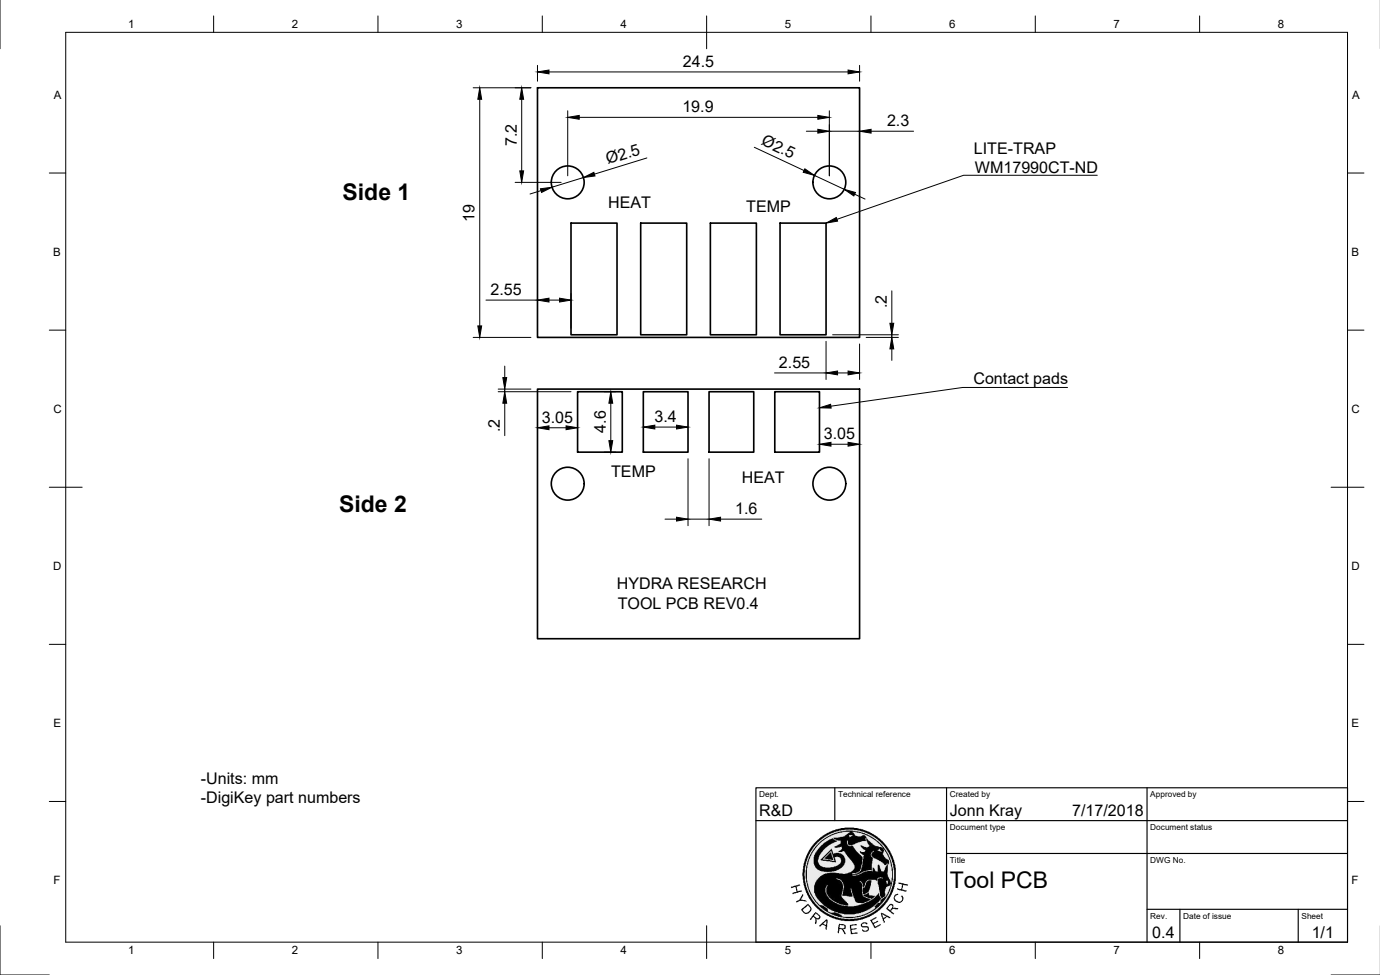
[picture p80: page 1]
Side 1; Side 2; HYDRA RESEARCH TOOL PCB REV0.4; -Units: mm; -DigiKey part numbers; Contact pads

Dept. R&D | Technical reference | Created by Jonn Kray 7/17/2018 | Approved by

Document type | Document status

Title Tool PCB | DWG No.

Rev. 0.4 | Date of issue | Sheet 1/1
