HydraResearchLLC/Nautilus-Hardware/Nautilus PCBs/EIP PCB/EIP PCB Rev0.1/Extruders in Serise PCB/OUTPUT/REV03 PCB.PDF

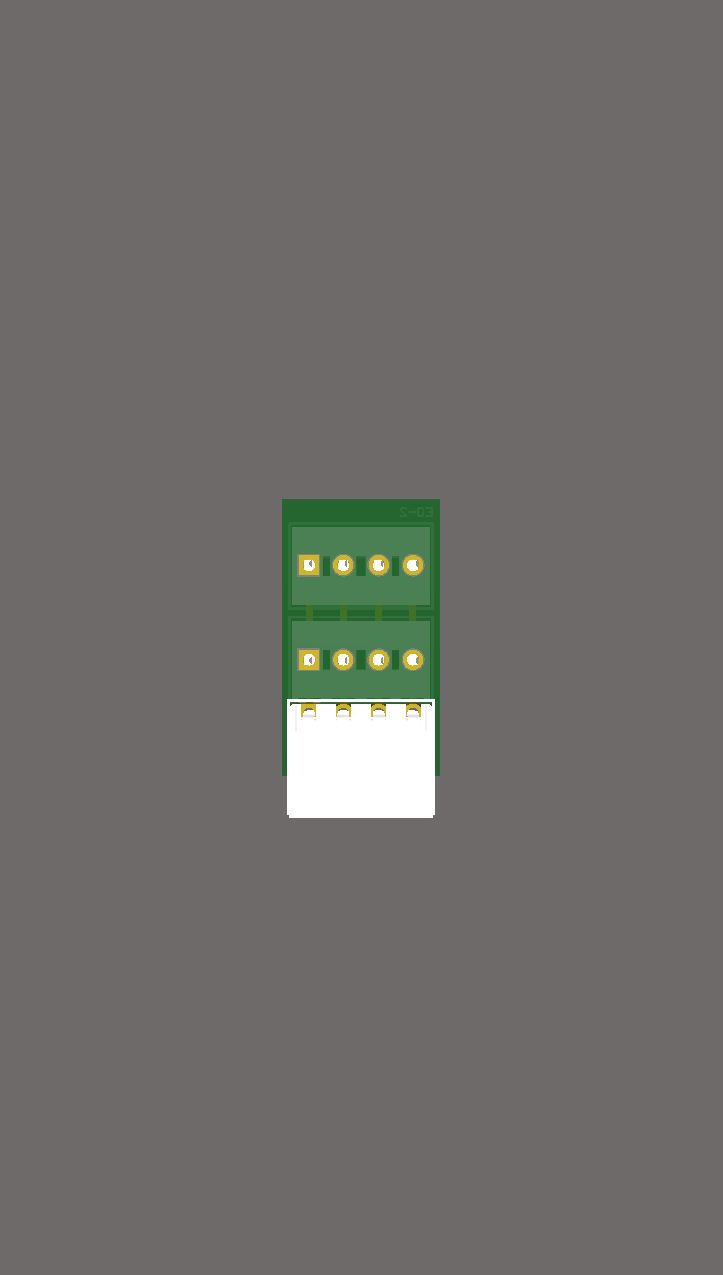
[picture p81: page 1]

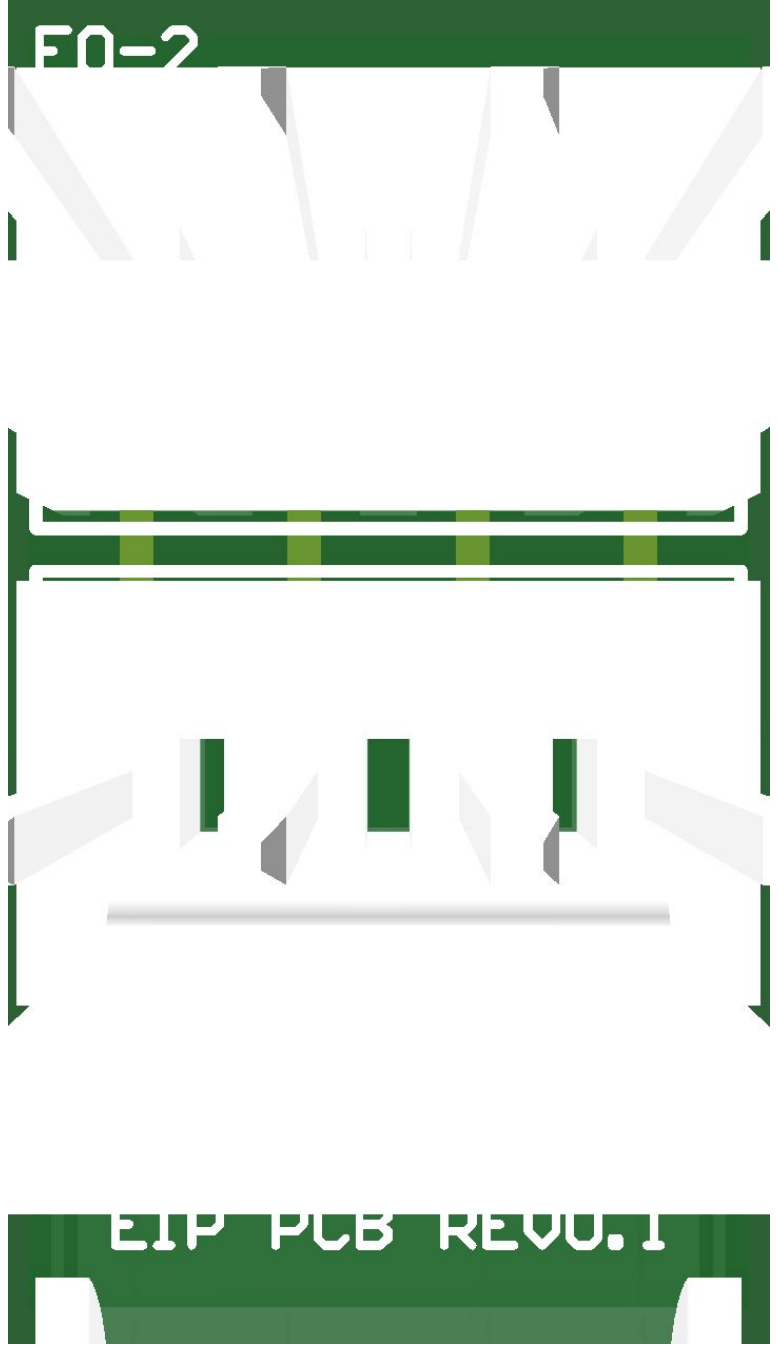
[picture p82: page 2]

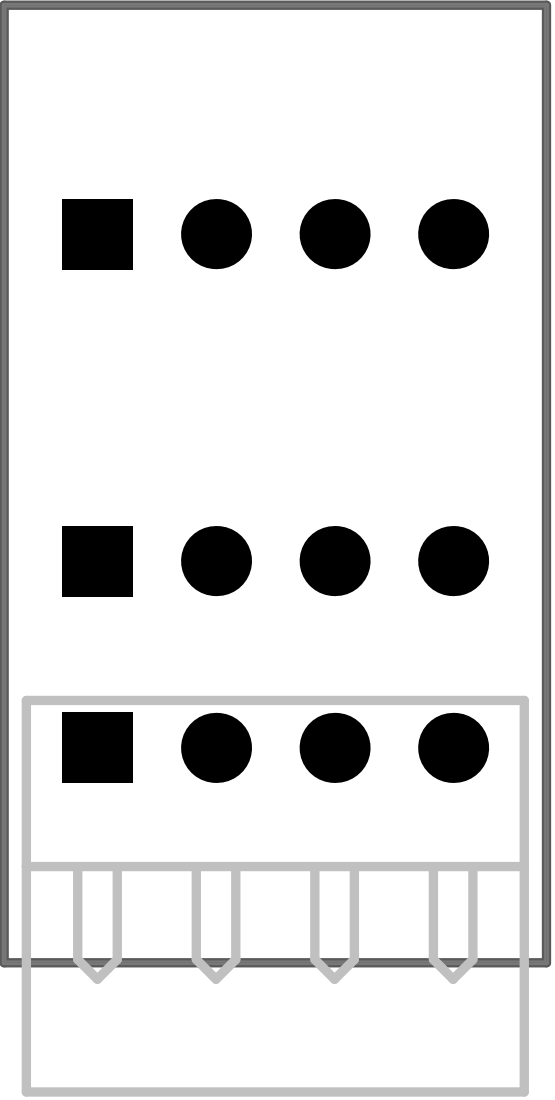
[picture p83: page 3]

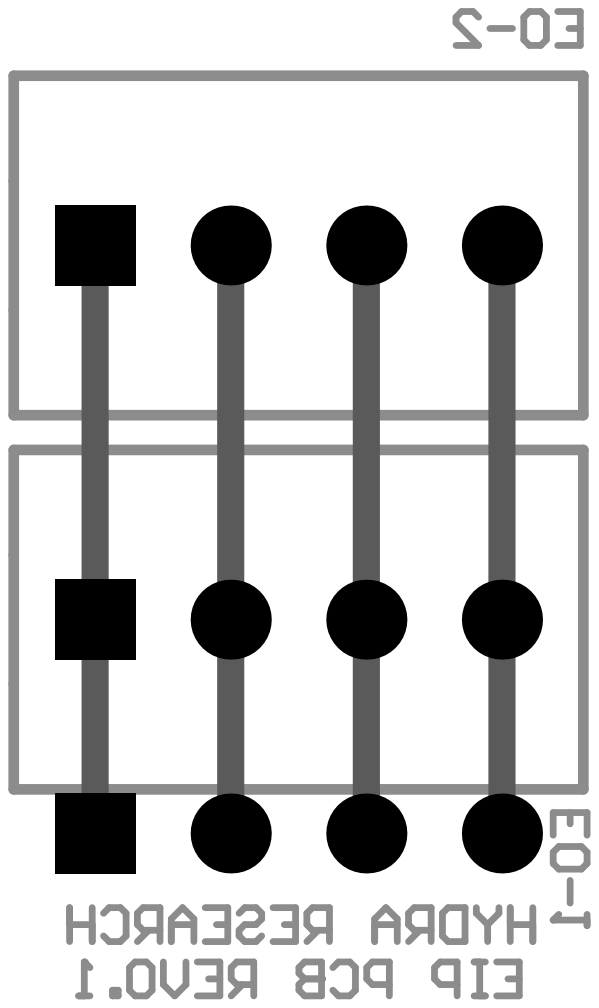
[picture p84: page 4]

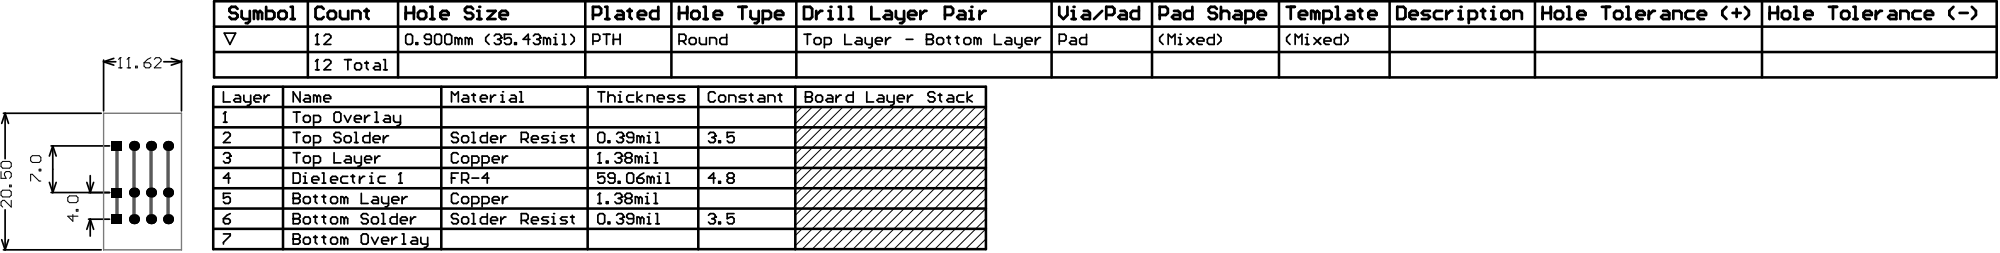
[picture p85: page 5]

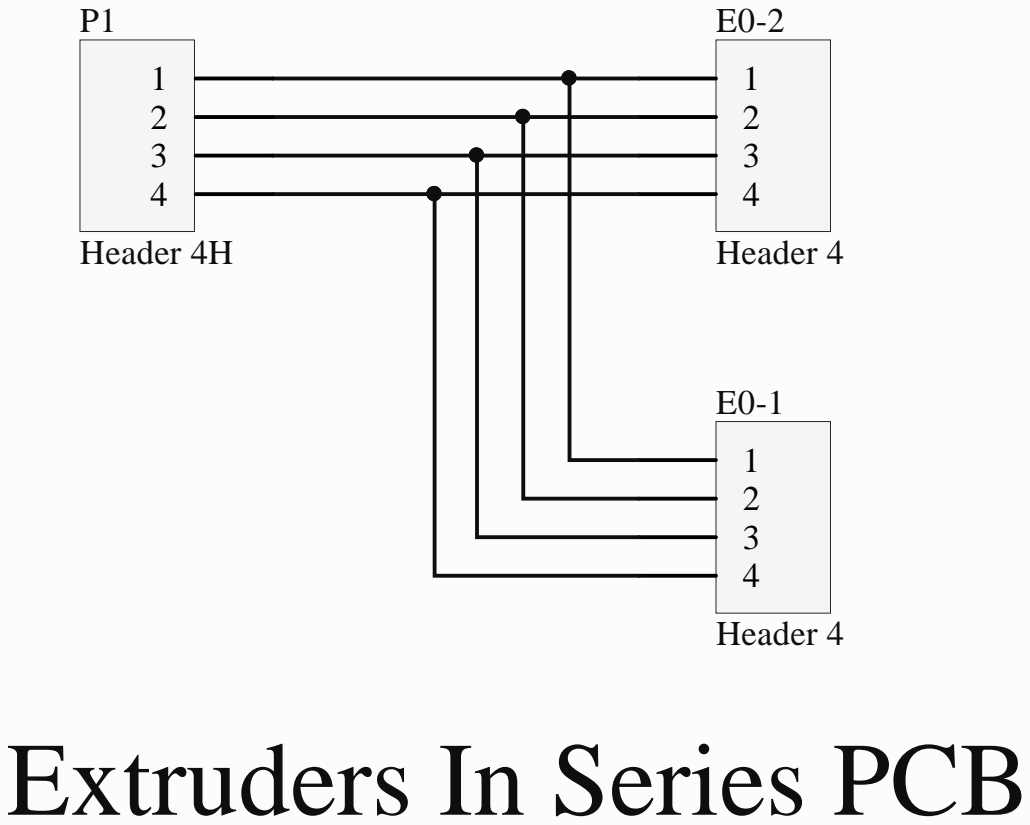
[picture p86: page 6]

Extruders In Series PCB
