HydraResearchLLC/Nautilus-Hardware/Nautilus PCBs/EIP PCB/EIP PCB Rev0.1/Extruders in Serise PCB/OUTPUT/REV03 SCH.PDF

Extruders In Series PCB
