HydraResearchLLC/Nautilus-Hardware/Nautilus PCBs/Tool Head PCB/REV0.3_modified/REV0.3_modified/OUTPUT/REV03 PCB.PDF

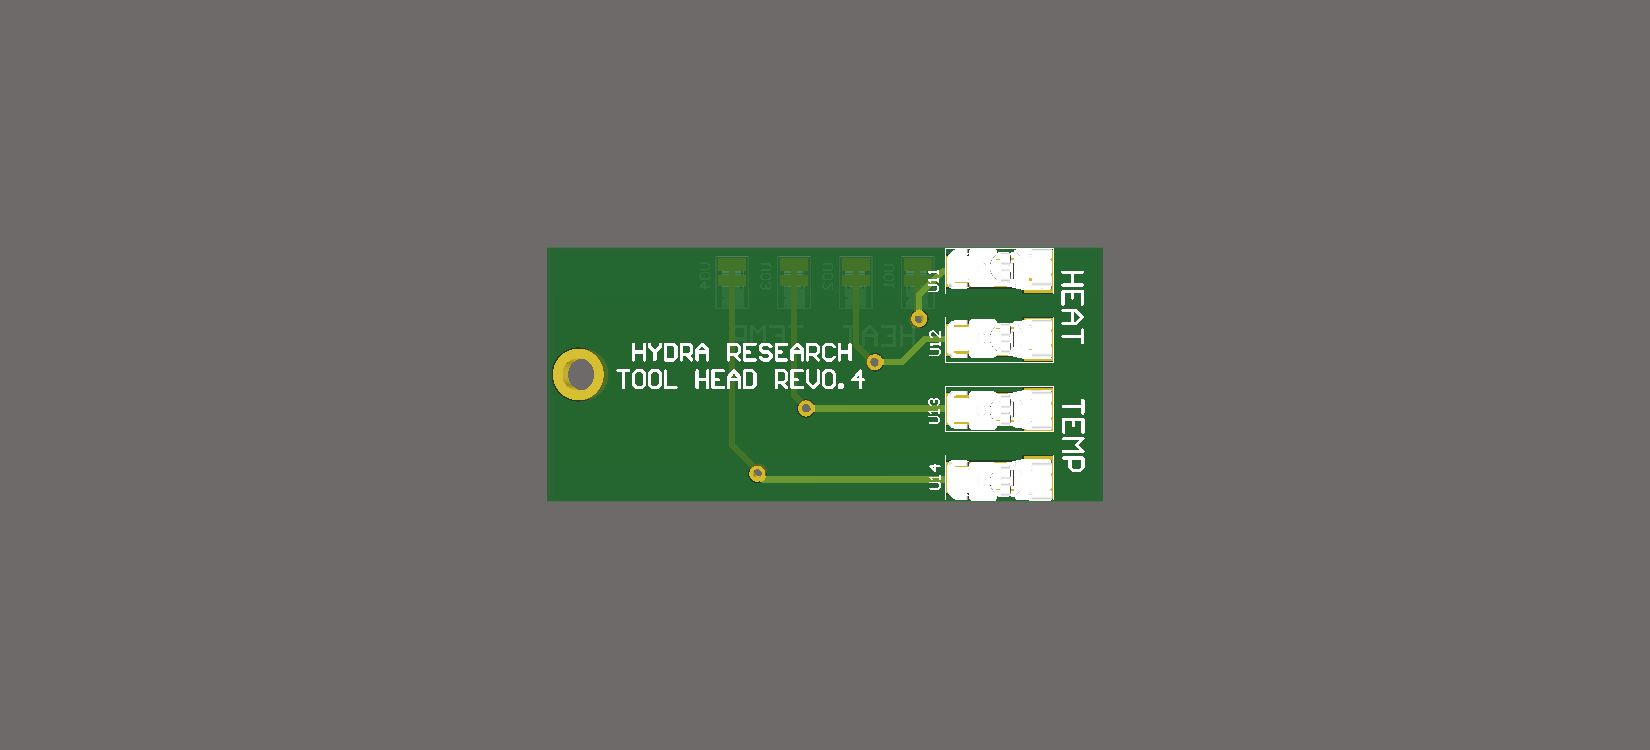
[picture p87: page 1]

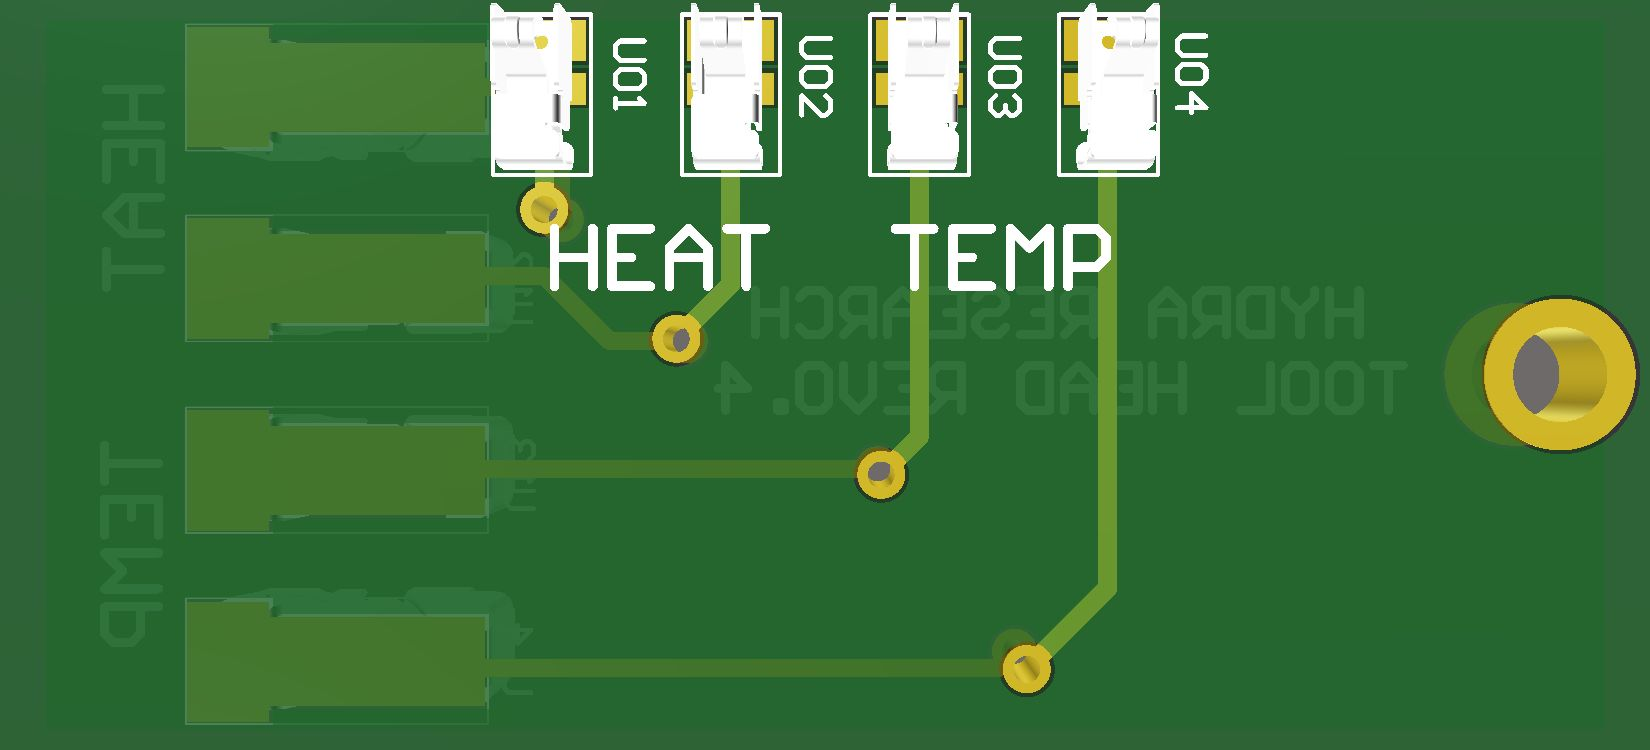
[picture p88: page 2]

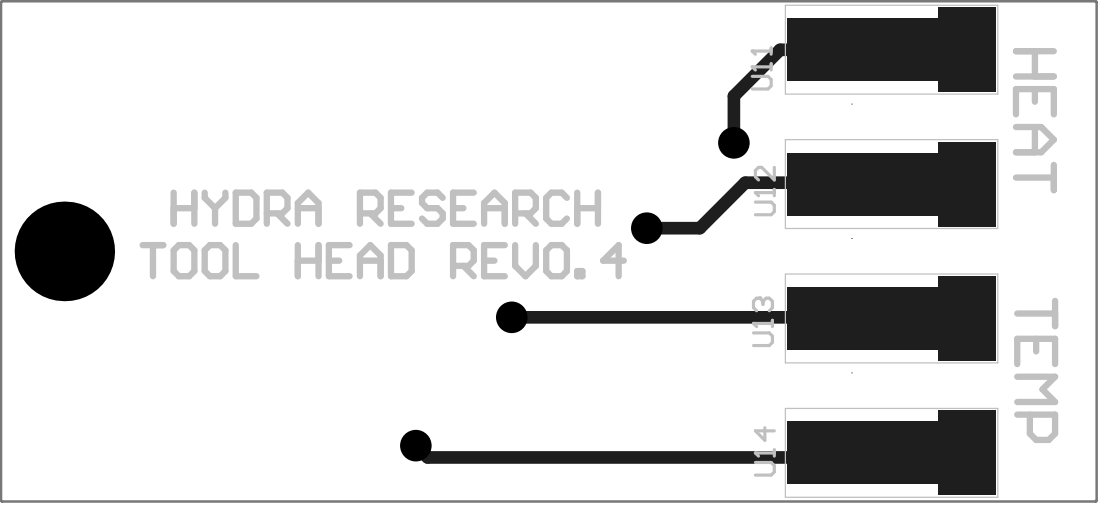
[picture p89: page 3]

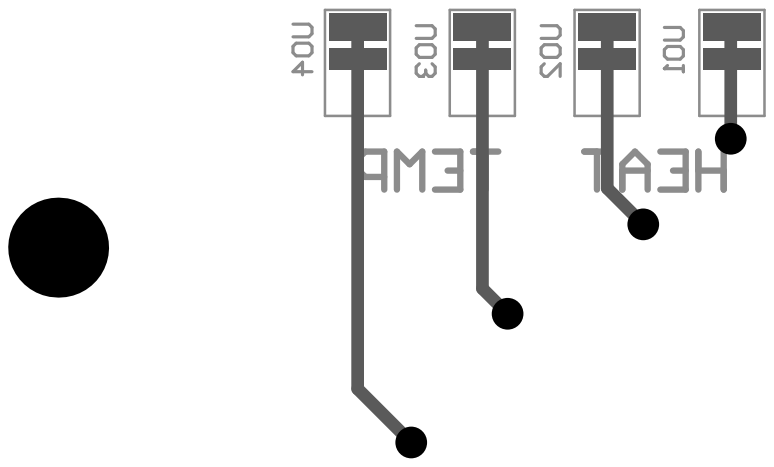
[picture p90: page 4]

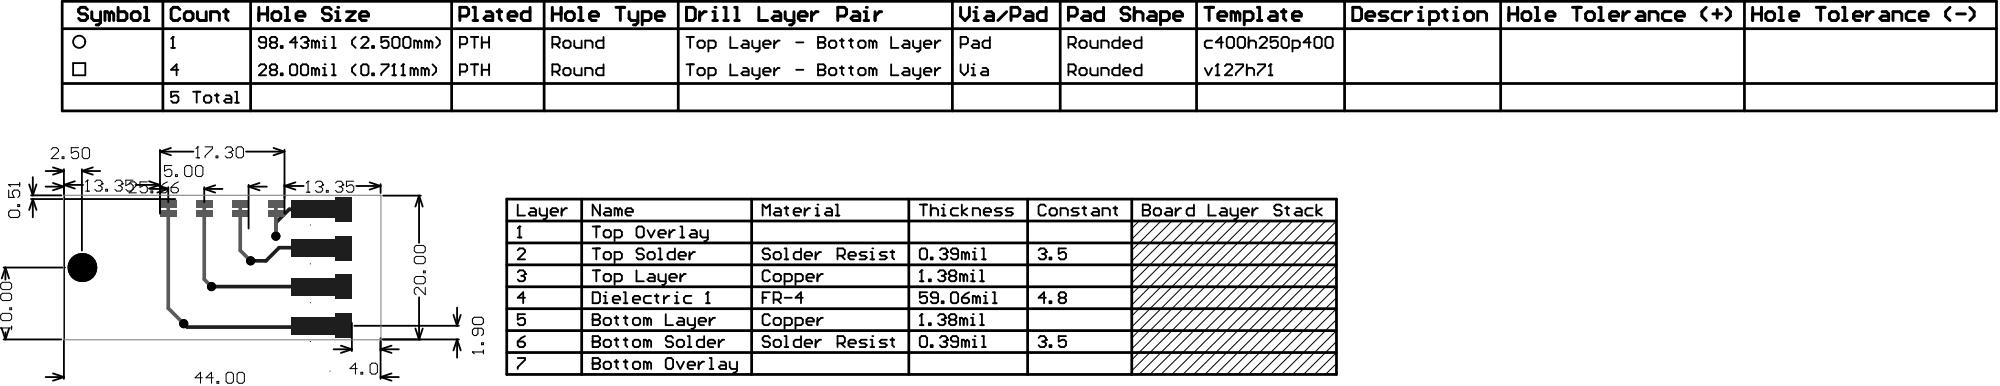
[picture p91: page 5]

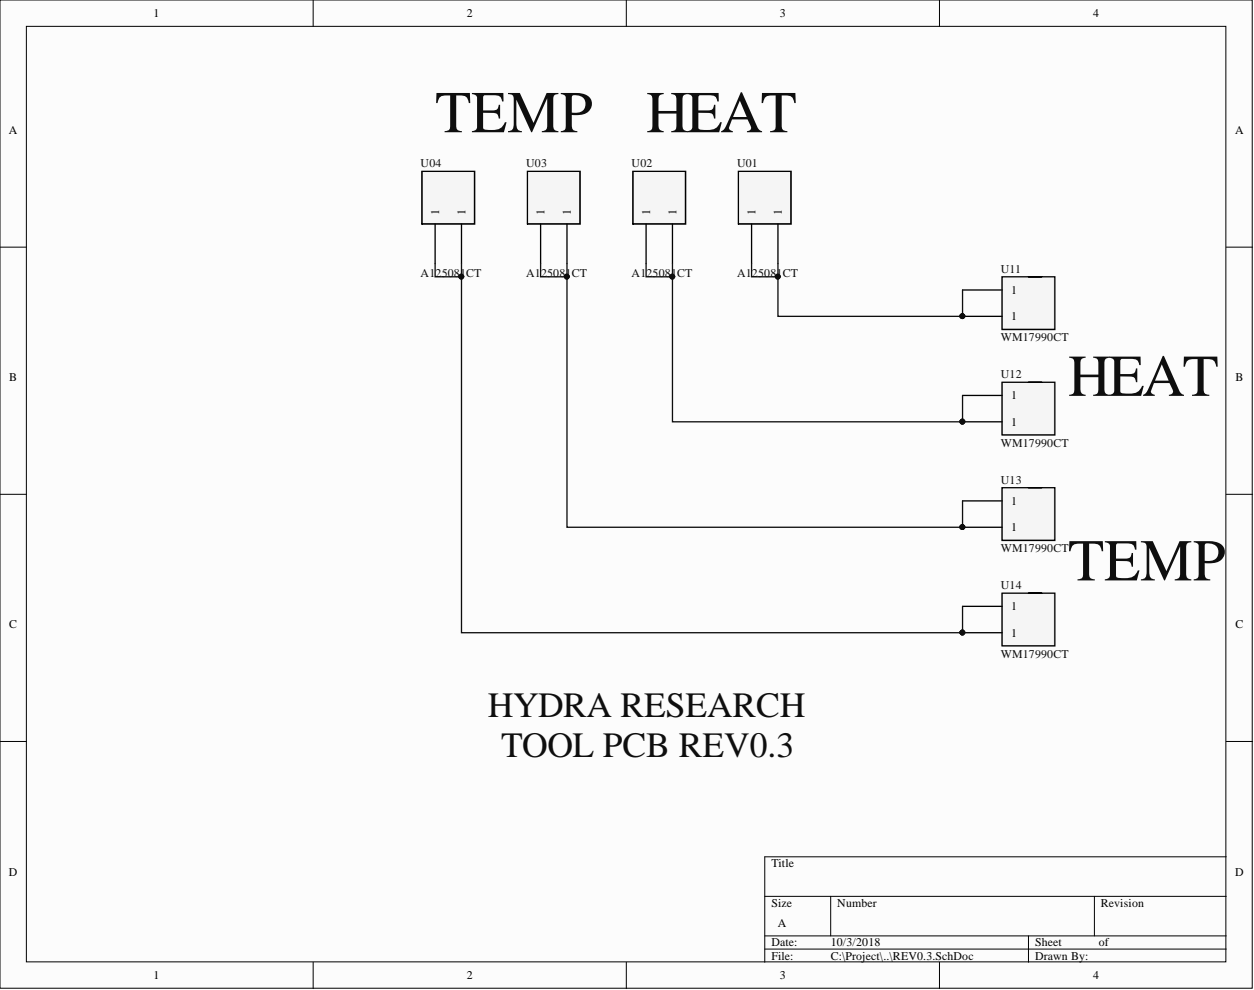
[picture p92: page 6]
