HydraResearchLLC/Nautilus-Hardware/Nautilus PCBs/Tool Head PCB/Too Head PCB REV0.3/Too Head PCB REV0.3/OUTPUT/Too Head PCB REV0.3 SCH.PDF

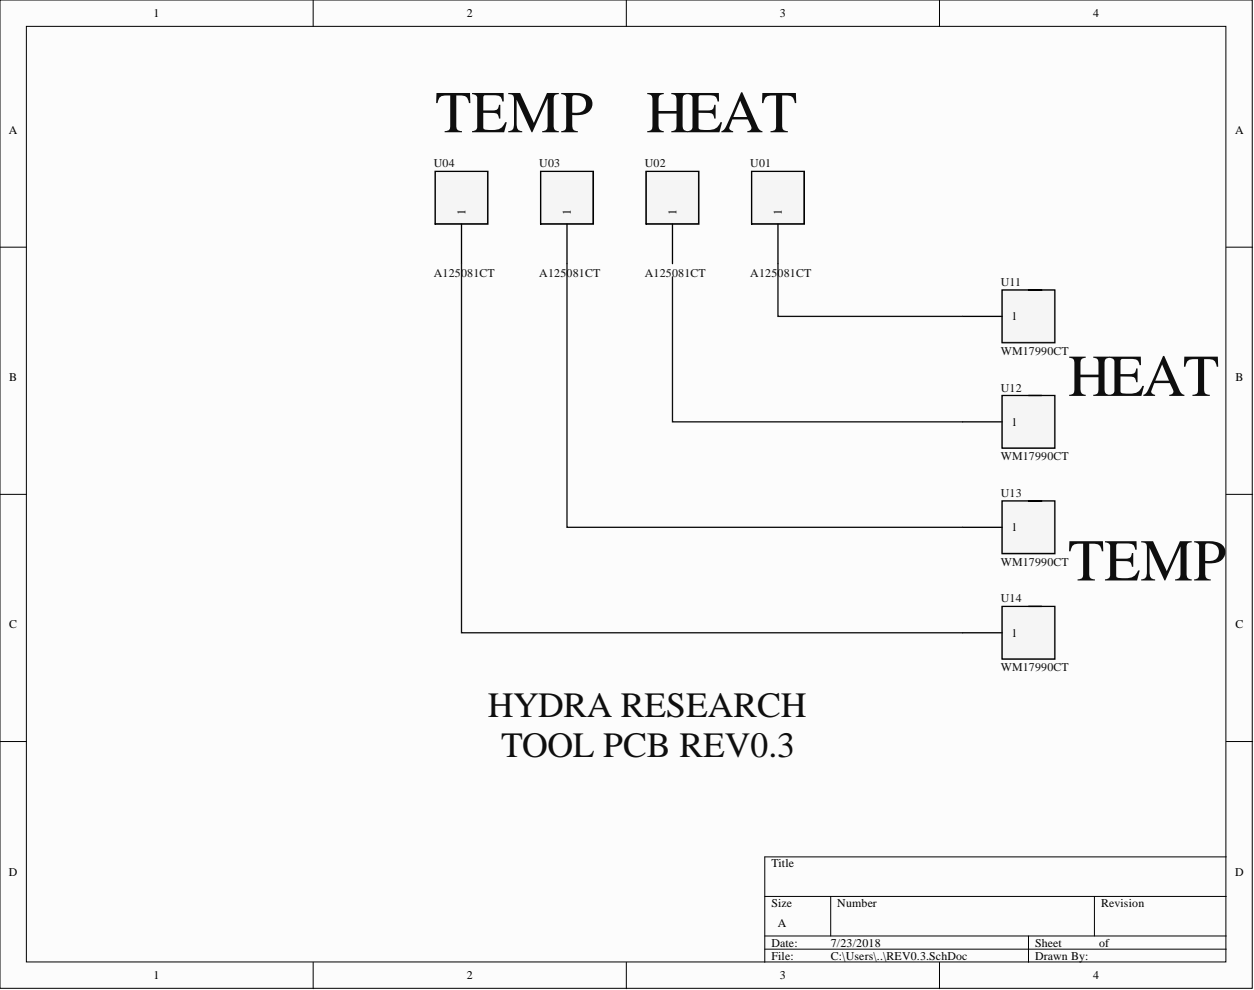
[picture p93: page 1]
