HydraResearchLLC/Nautilus-Hardware/Nautilus PCBs/Tool Head PCB/Too Head PCB REV0.3/Too Head PCB REV0.3/OUTPUT/Too Head PCB REV0.3.PDF

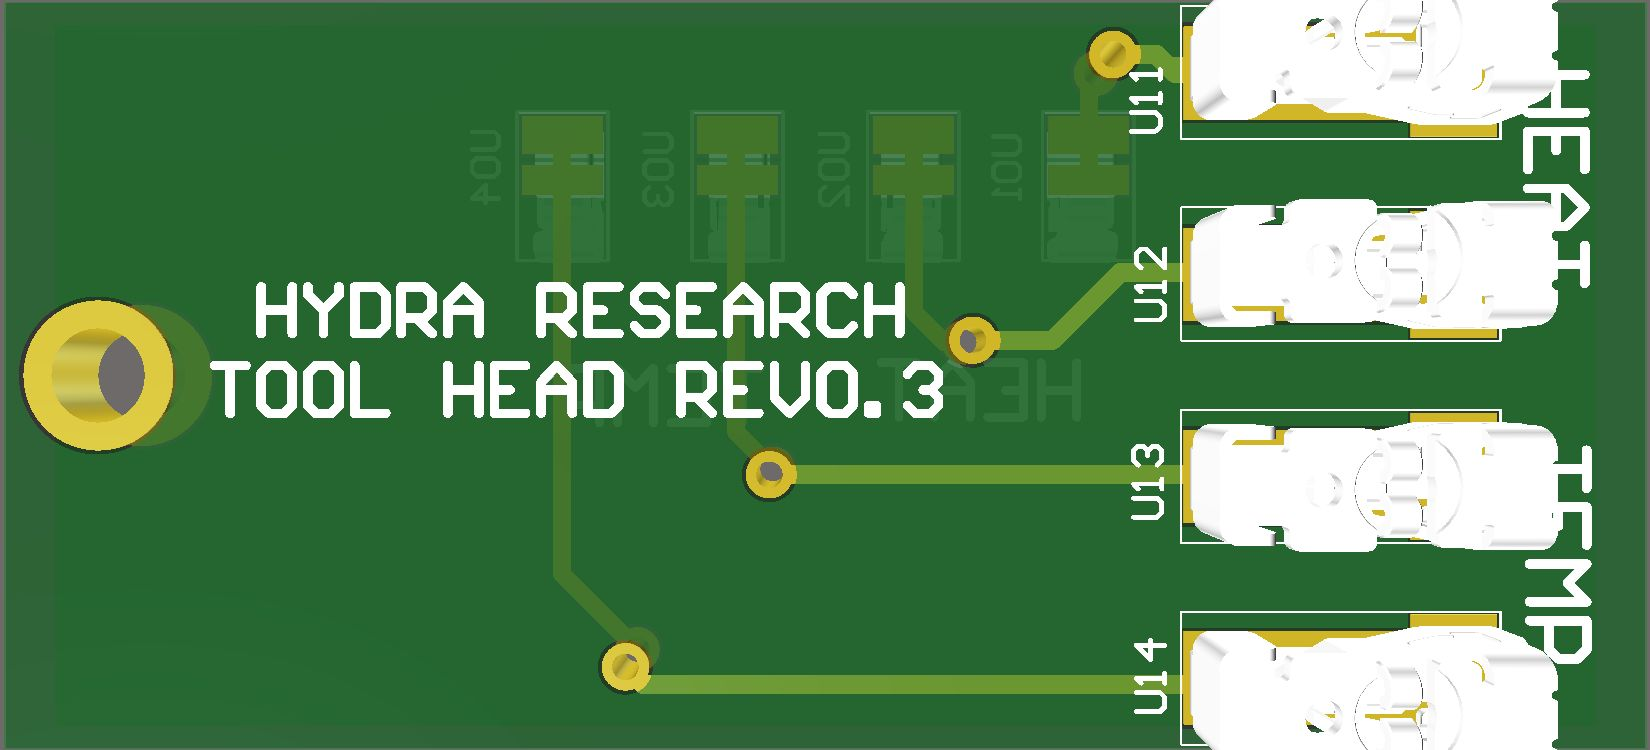
[picture p94: page 1]

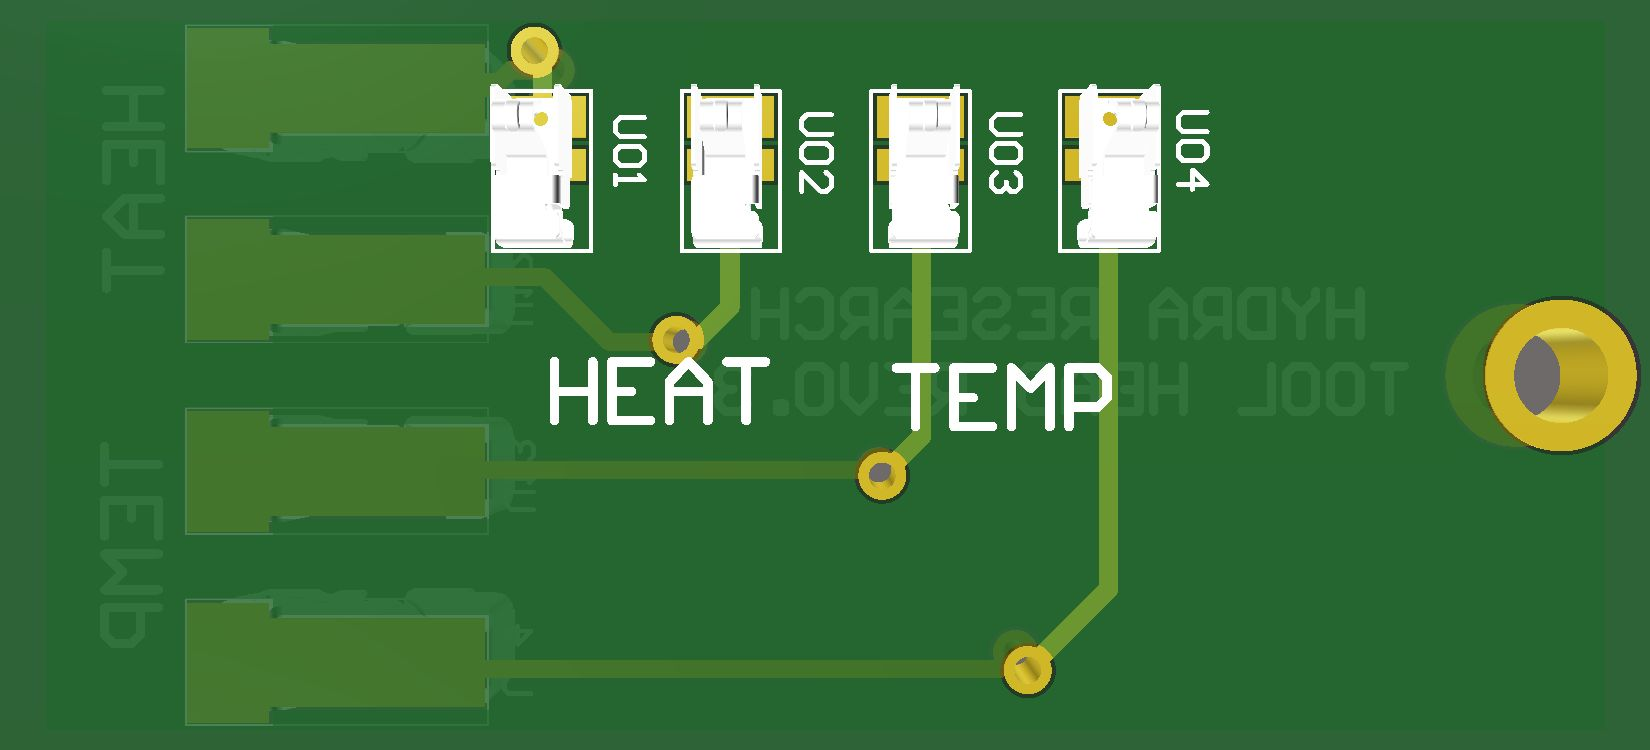
[picture p95: page 2]

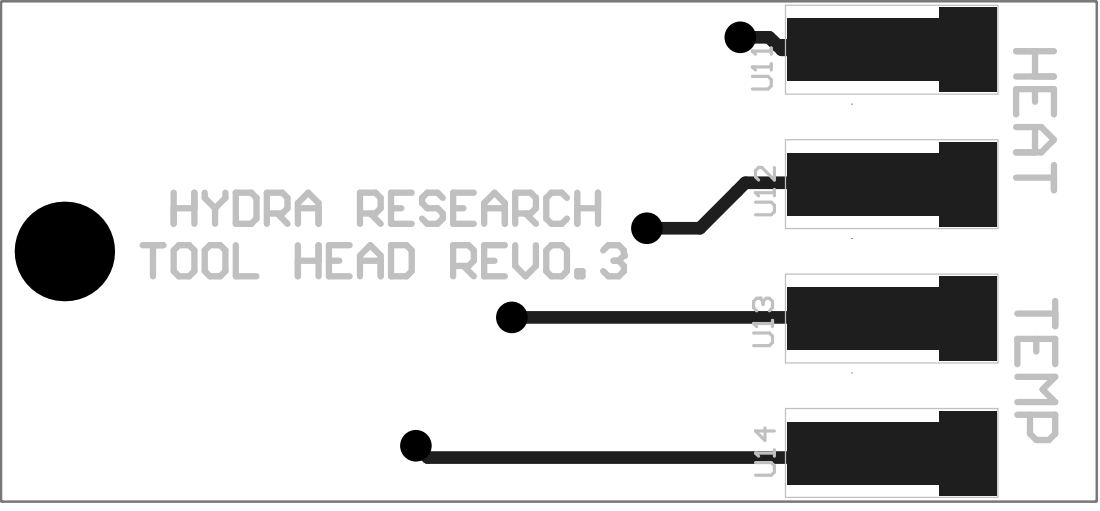
[picture p96: page 3]

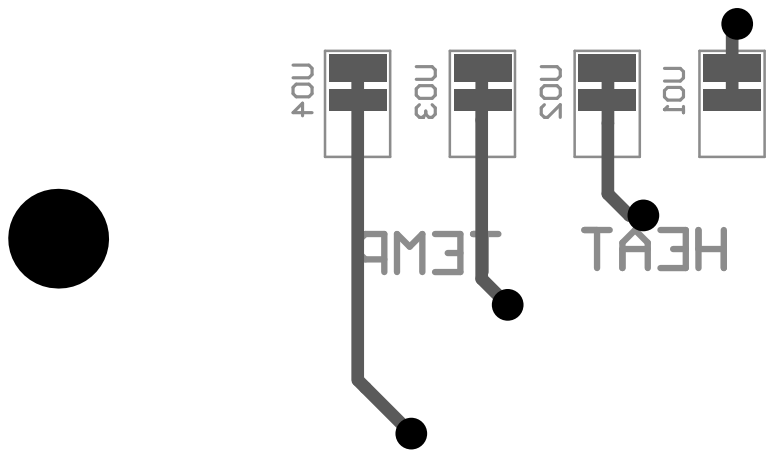
[picture p97: page 4]

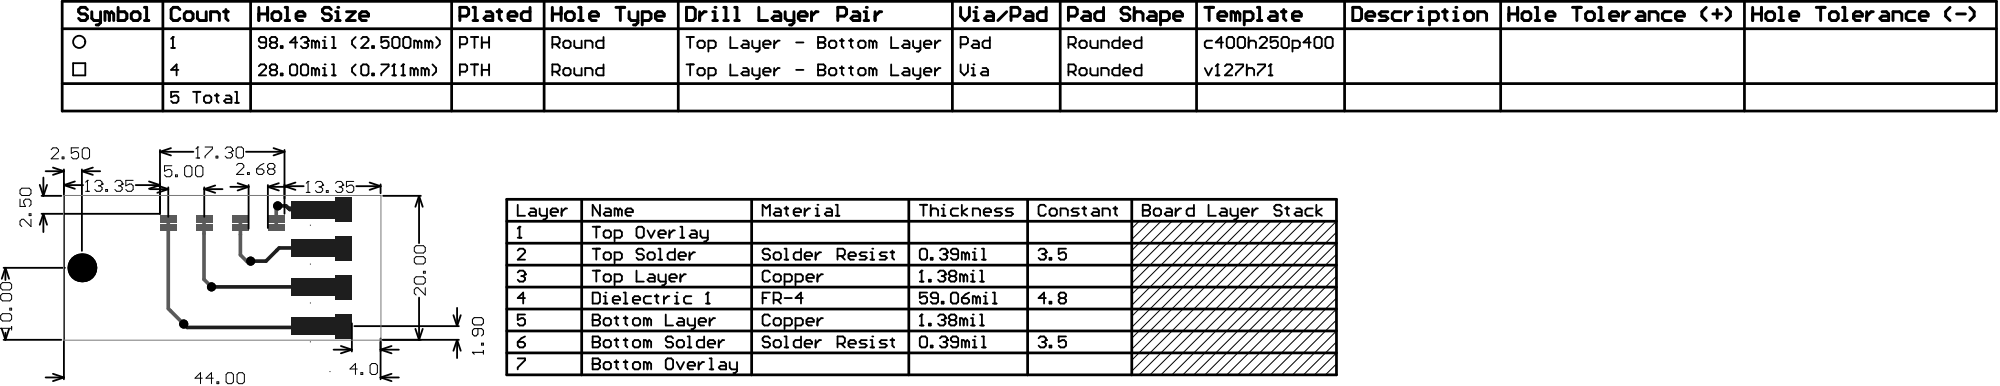
[picture p98: page 5]
