HydraResearchLLC/Nautilus-Hardware/Nautilus PCBs/Tool PCB/REV0.4_modified/REV0.4_modified/OUTPUT/REV04 PCB.PDF

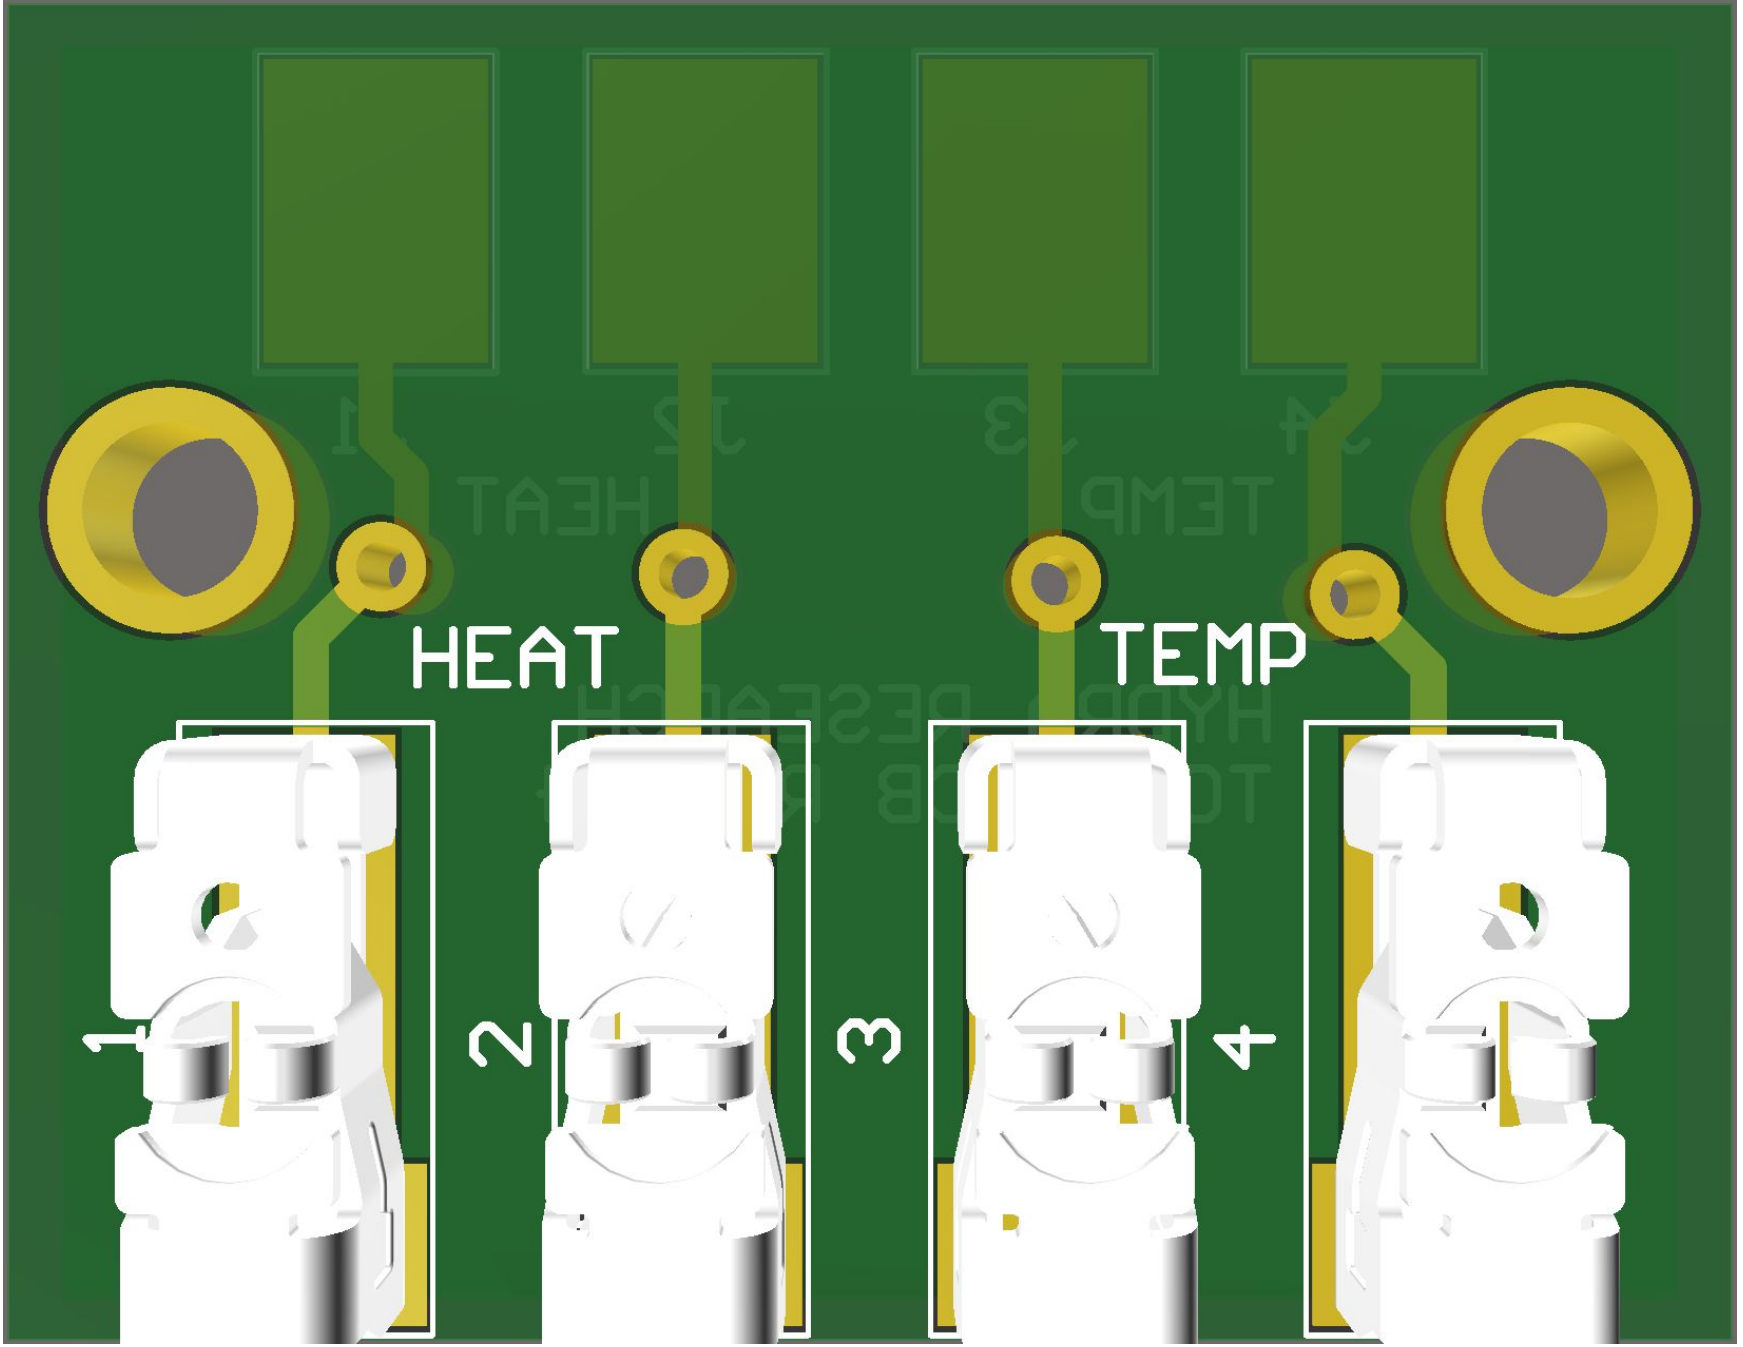
[picture p99: page 1]

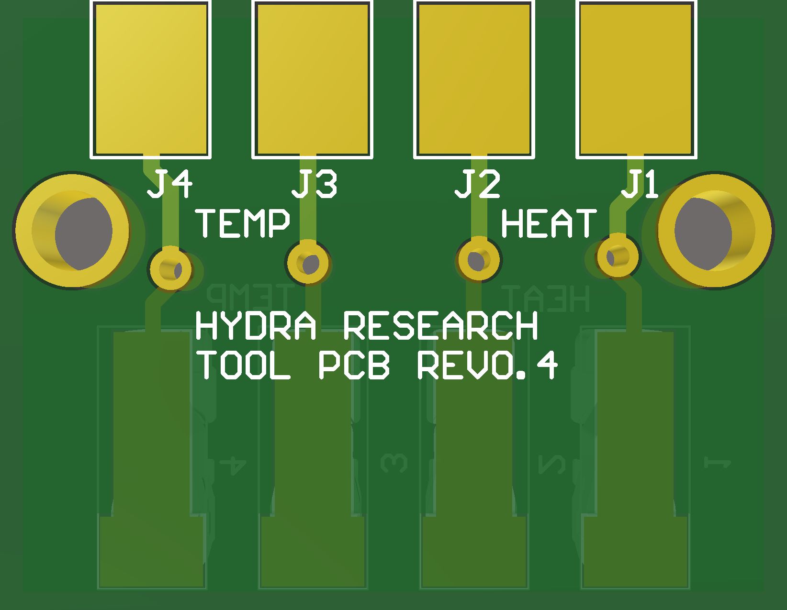
[picture p100: page 2]

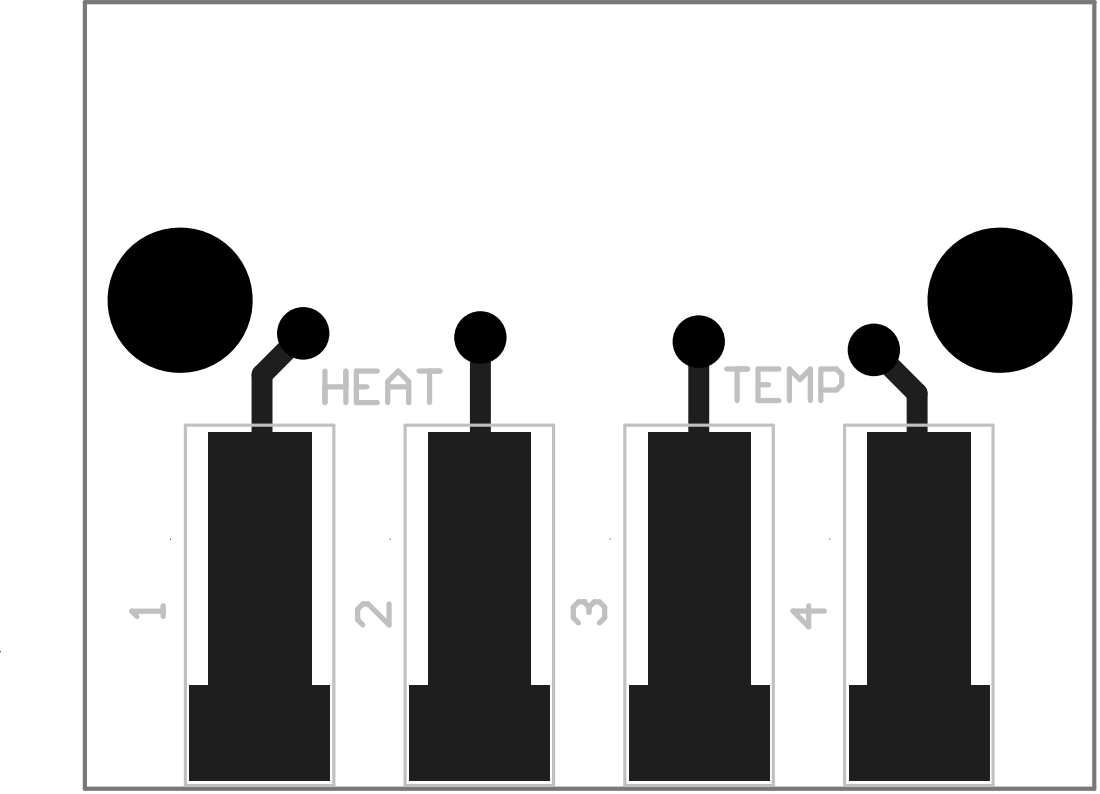
[picture p101: page 3]

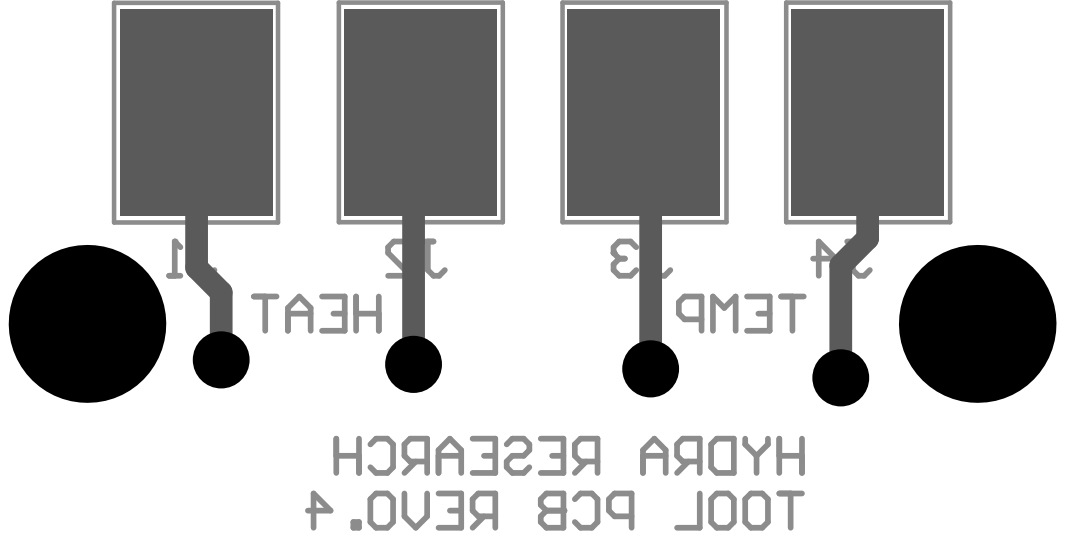
[picture p102: page 4]

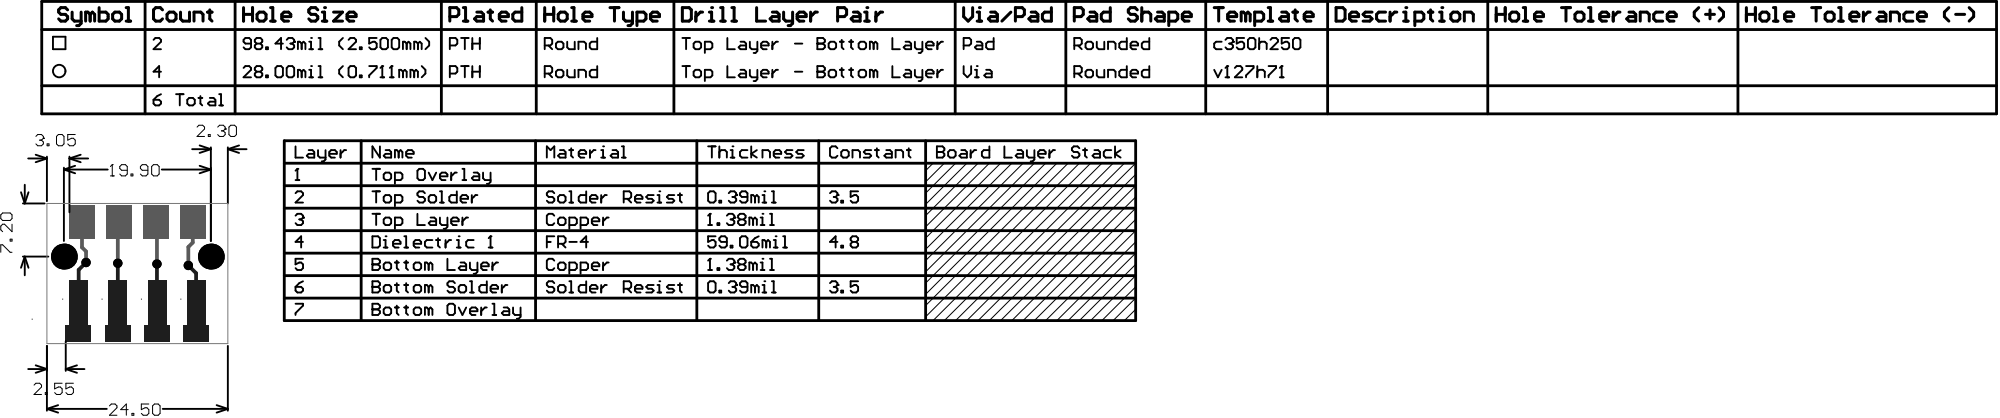
[picture p103: page 5]

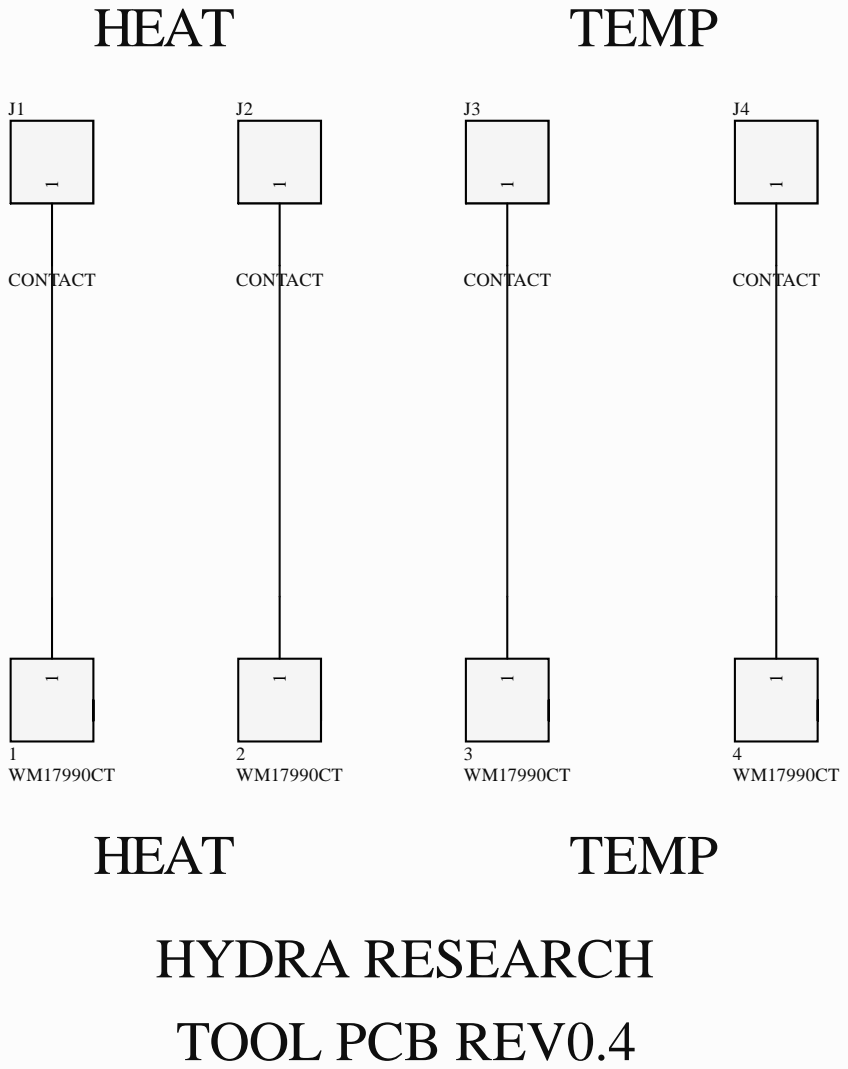
[picture p104: page 6]
