HydraResearchLLC/Nautilus-Hardware/Nautilus PCBs/Tool PCB/Tool Rev 0.4/REV0.4/REV0.4/OUTPUT/REV04 PCB.PDF

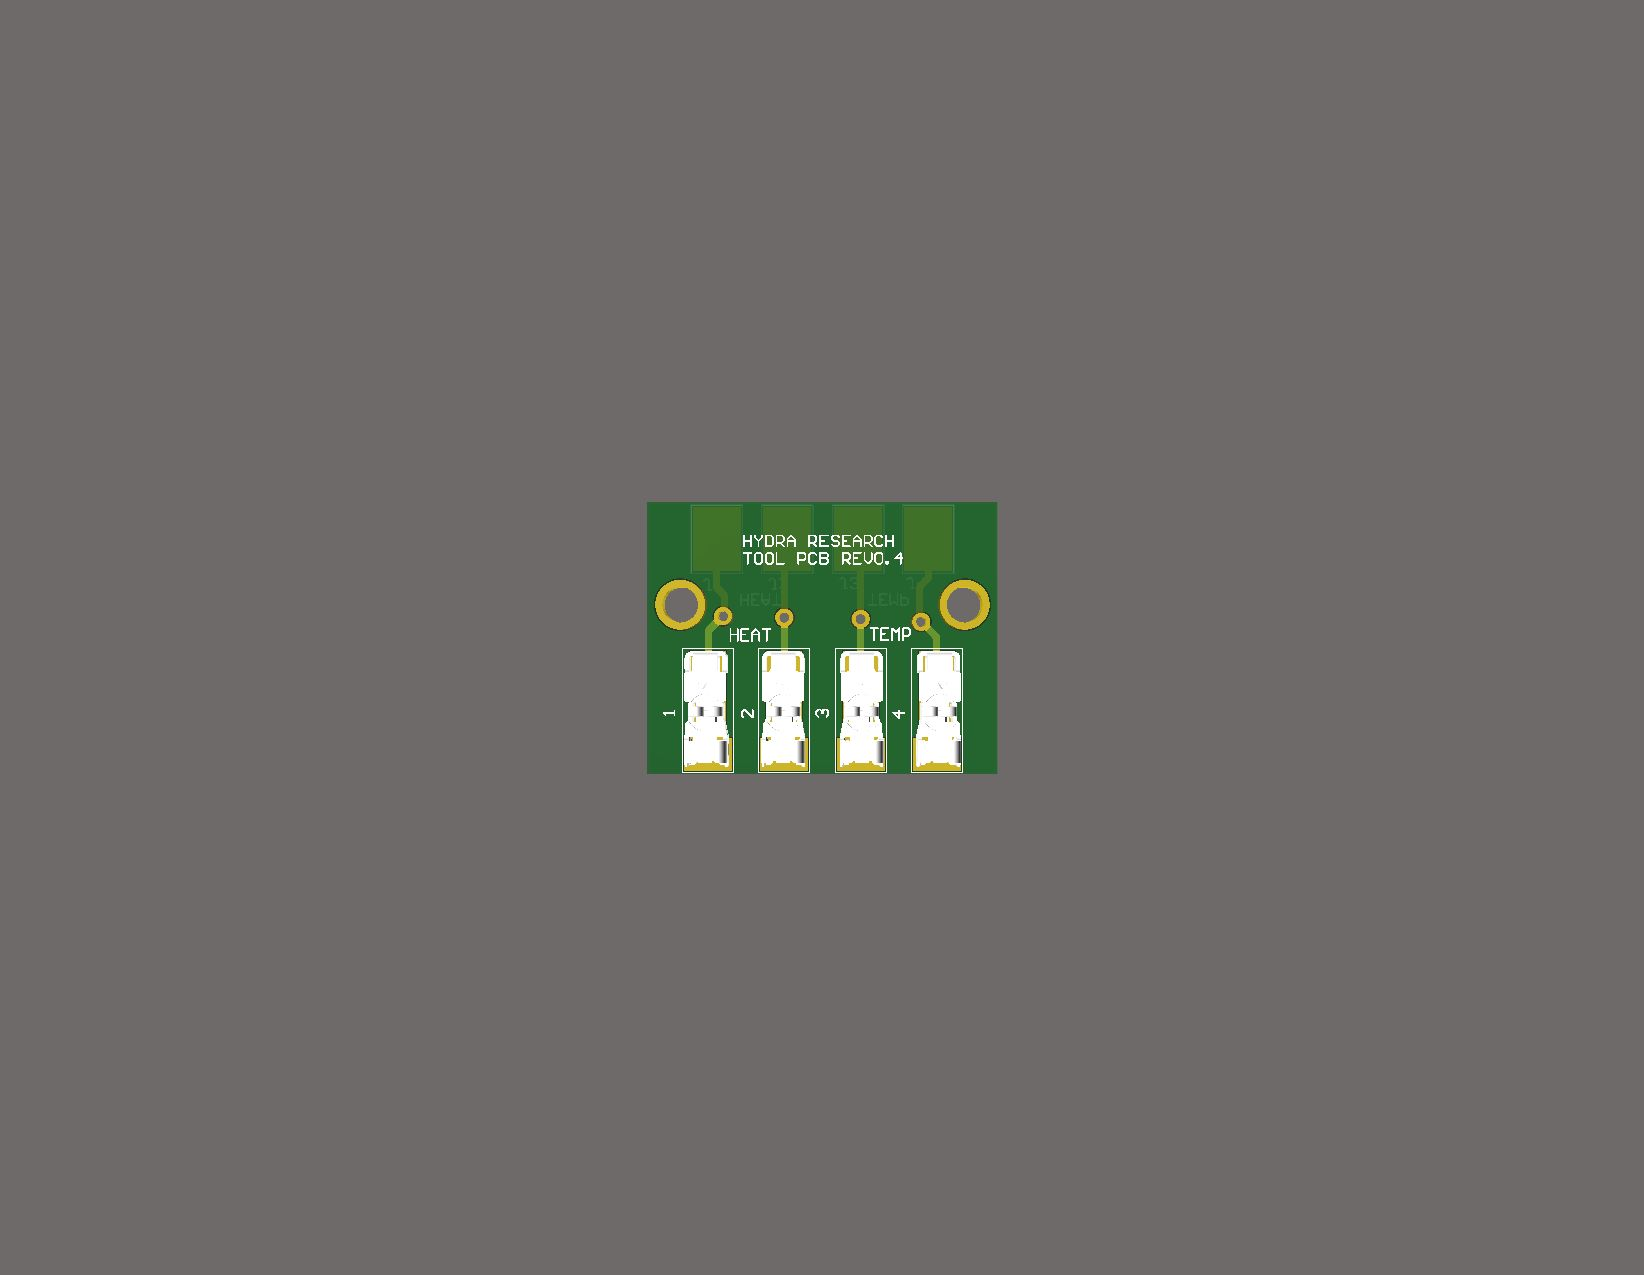
[picture p105: page 1]

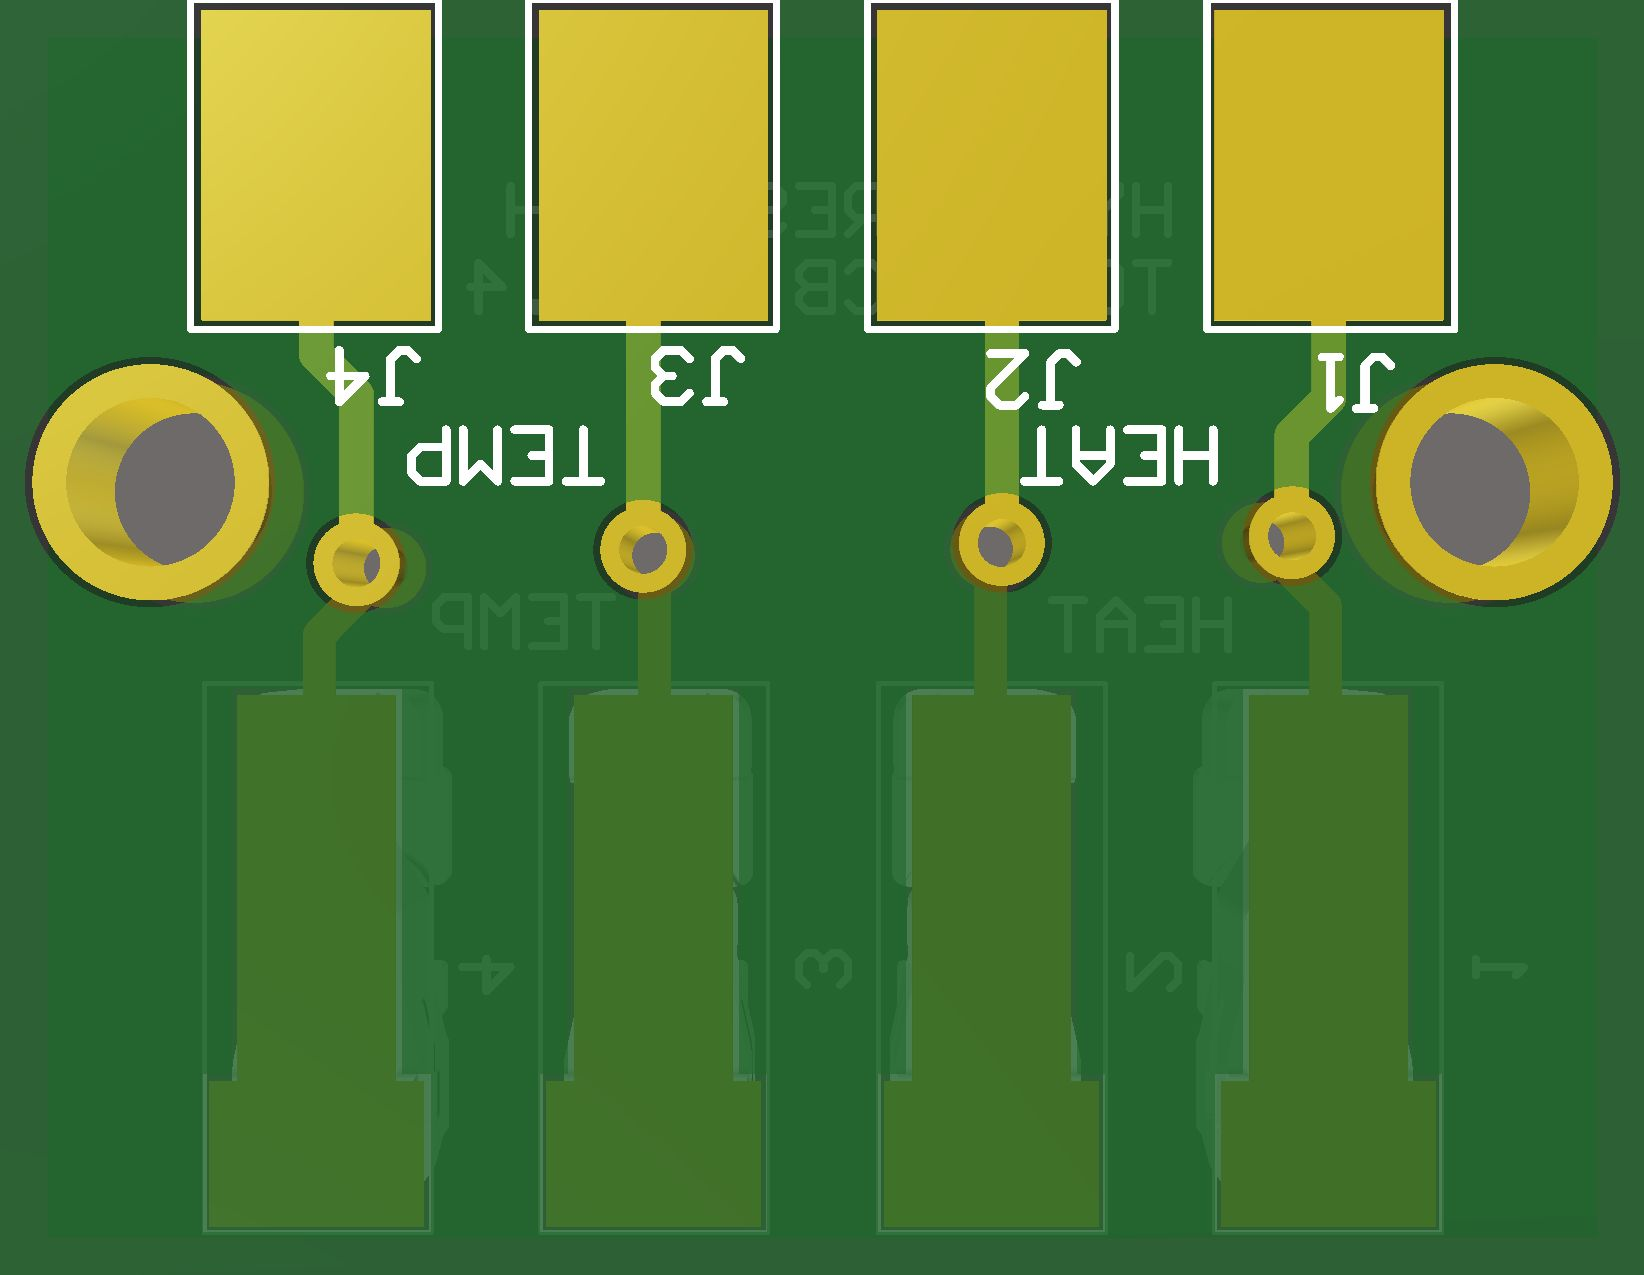
[picture p106: page 2]

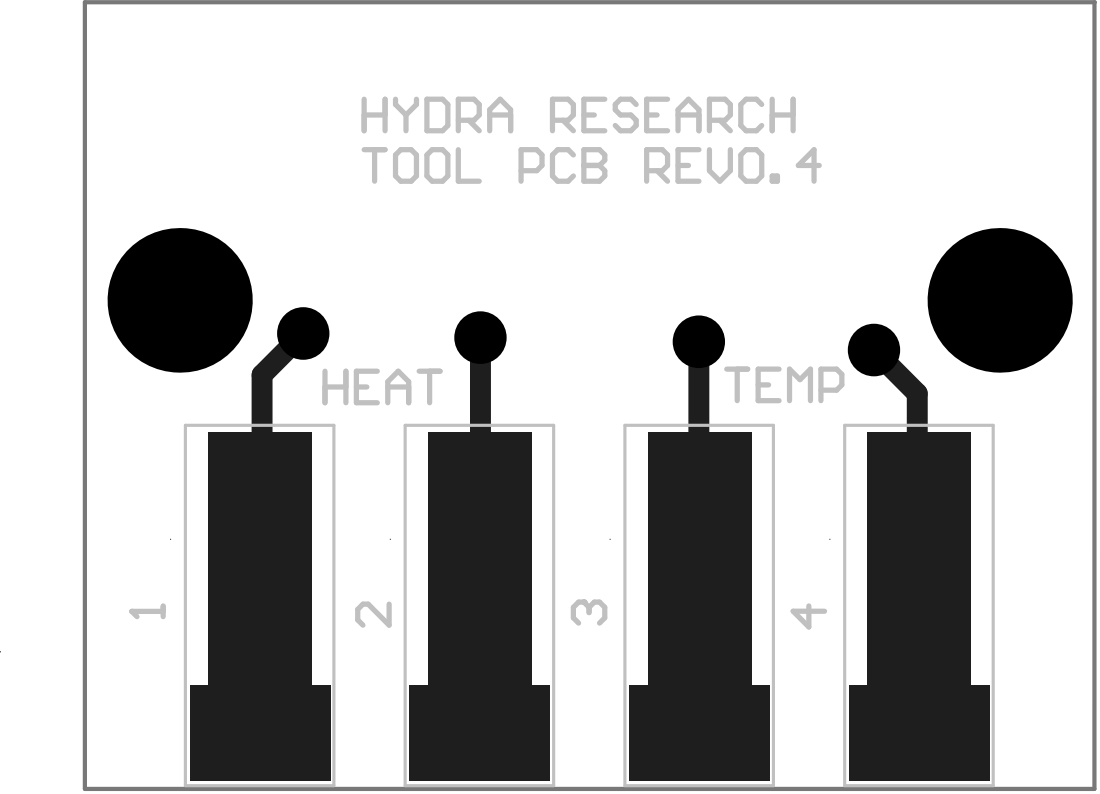
[picture p107: page 3]

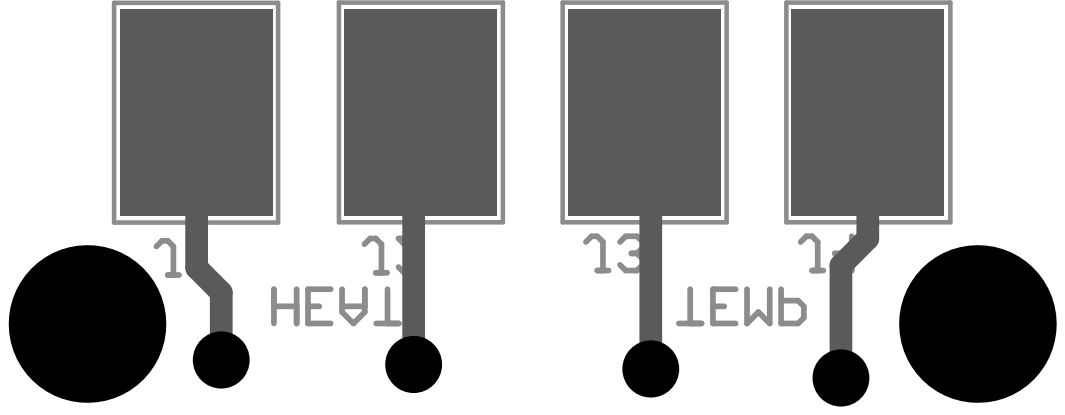
[picture p108: page 4]

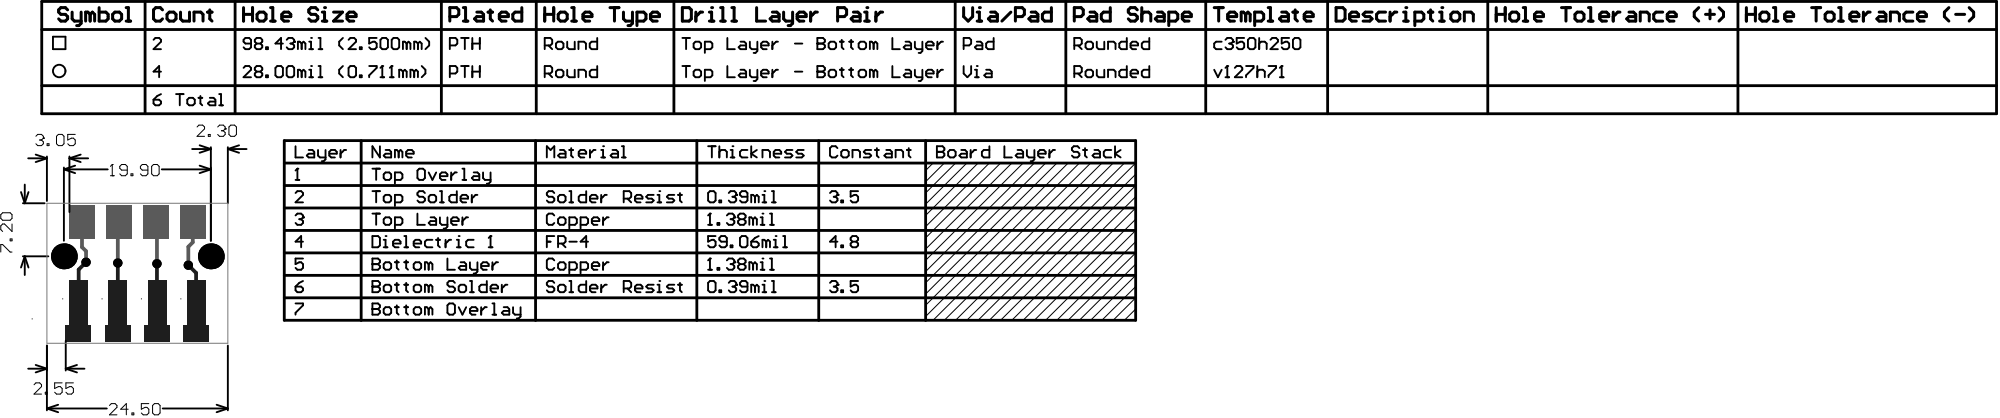
[picture p109: page 5]

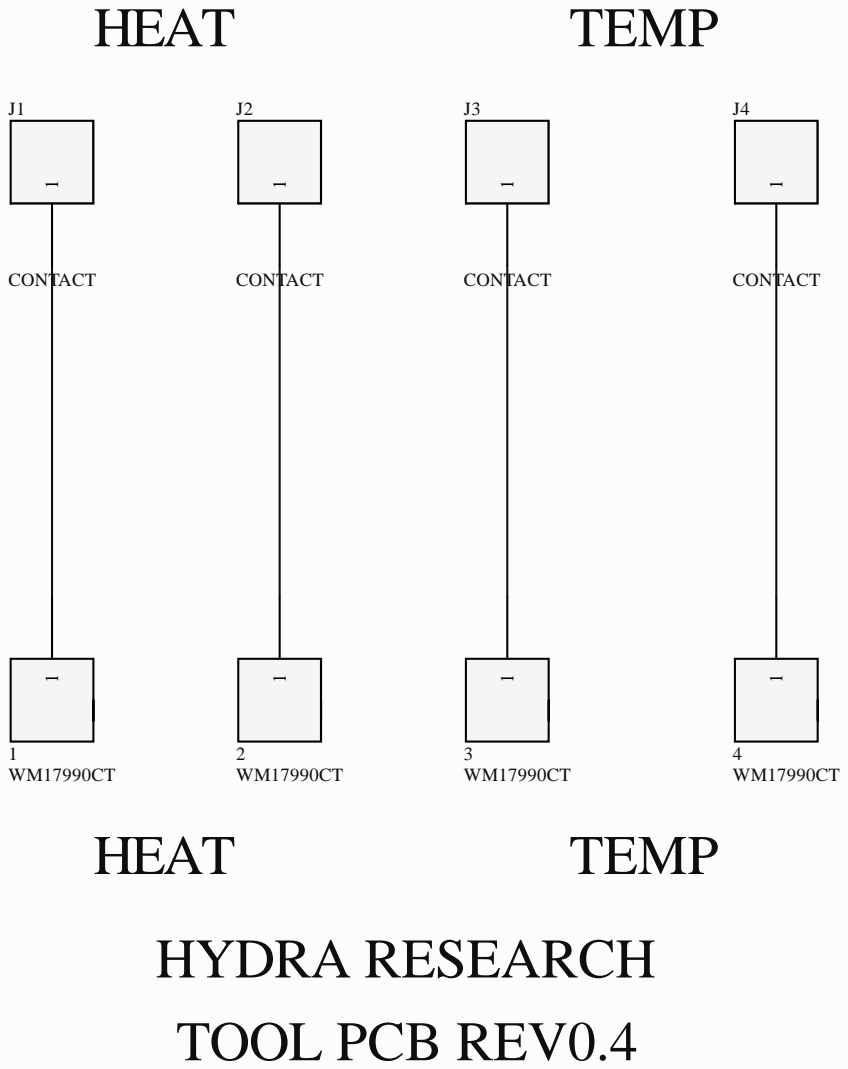
[picture p110: page 6]
