HydraResearchLLC/Nautilus-Hardware/Machined Parts/Build Plate/Build Plate Rev0.2/Build Plate Drawing Rev0.2.pdf

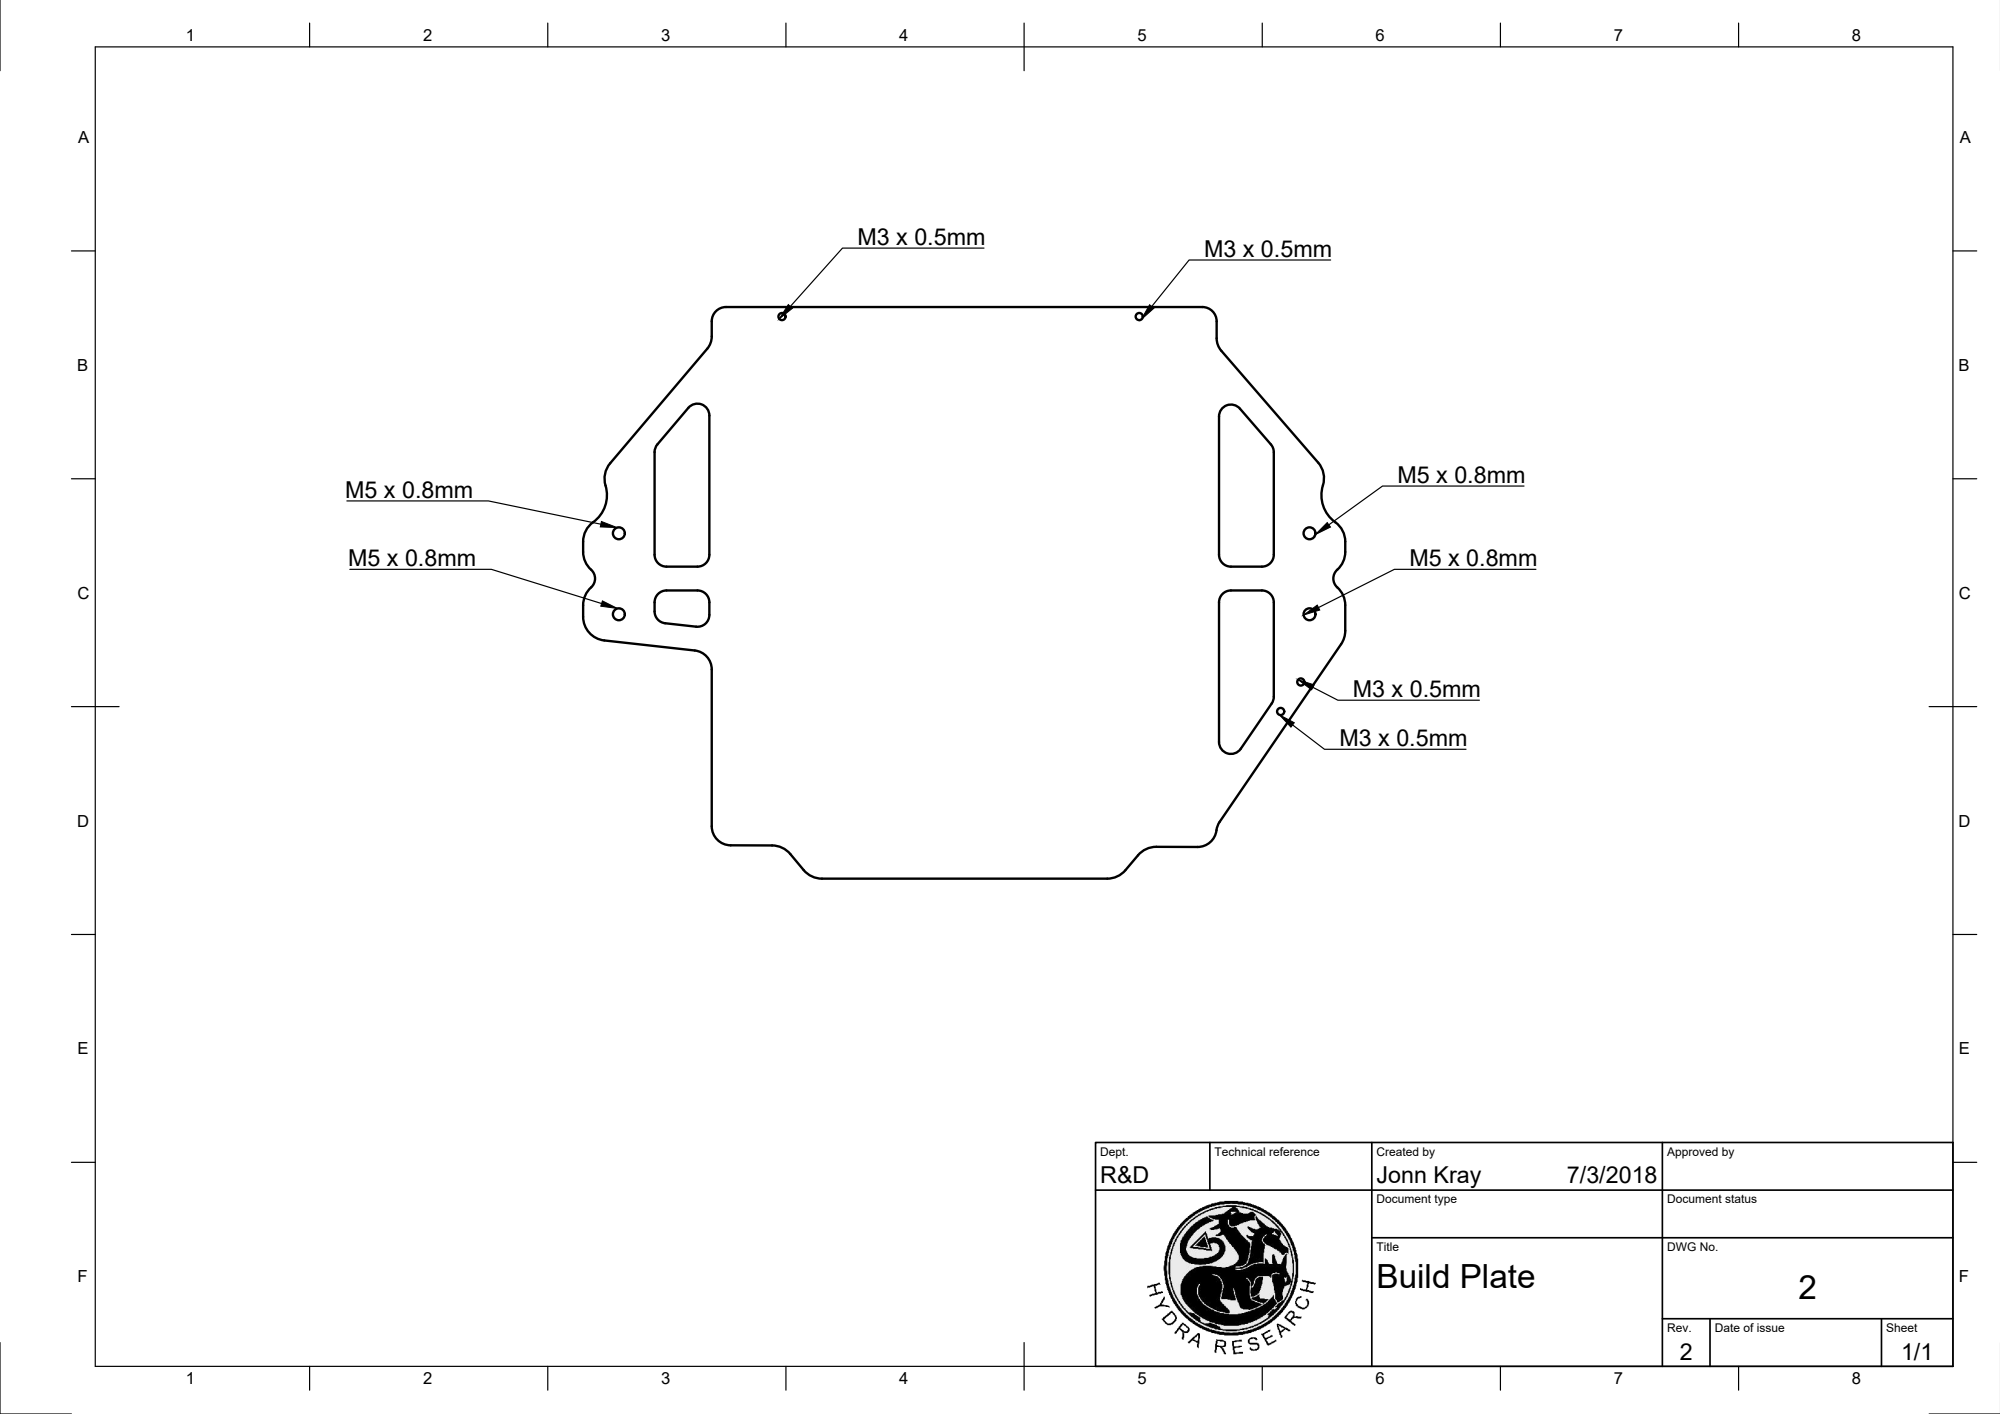
[picture p111: page 1]

Dept. R&D | Technical reference | Created by Jonn Kray 7/3/2018 | Approved by

Document type | Document status

Title | DWG No. 2 Build Plate

Rev. 2 | Date of issue | Sheet 1/1
