HydraResearchLLC/Nautilus-Hardware/Machined Parts/Build Plate/Build Plate rev0.6/Build Plate Drawing rev0.6.pdf

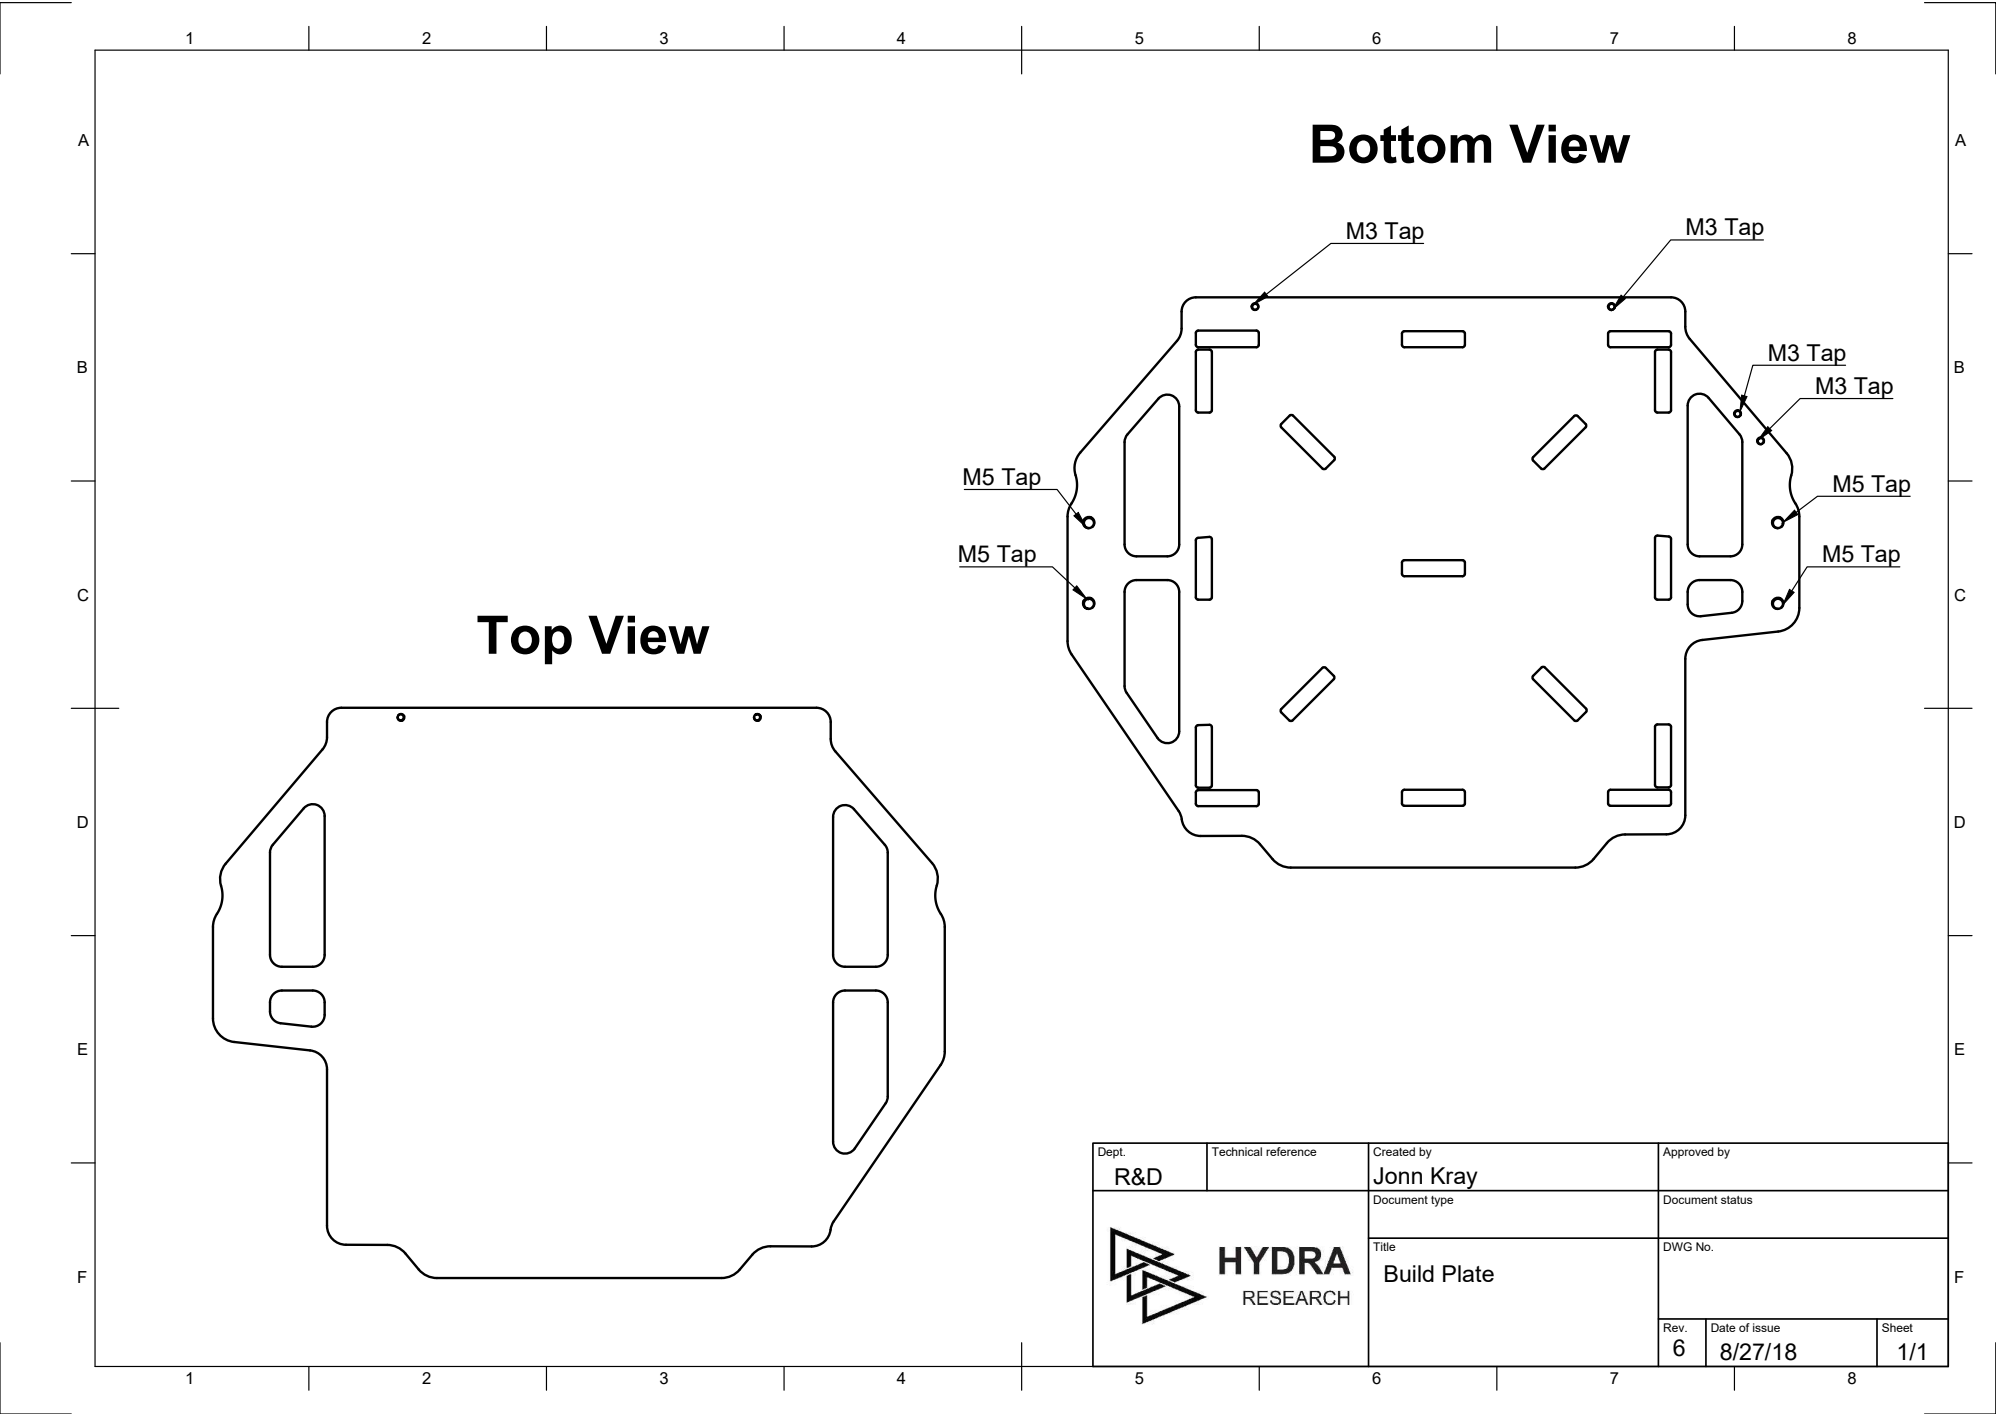
[picture p112: page 1]
M3 Tap; M5 Tap; Top View; Bottom View

Dept. R&D | Technical reference | Created by Jonn Kray | Approved by

Document type | Document status

Title Build Plate | DWG No.

Rev. 6 | Date of issue 8/27/18 | Sheet 1/1
