HydraResearchLLC/Nautilus-Hardware/Acrylic Enclosure/Acrylic Enclosure Rev0.9/Frame Front Rev0.9 Drwaing.pdf

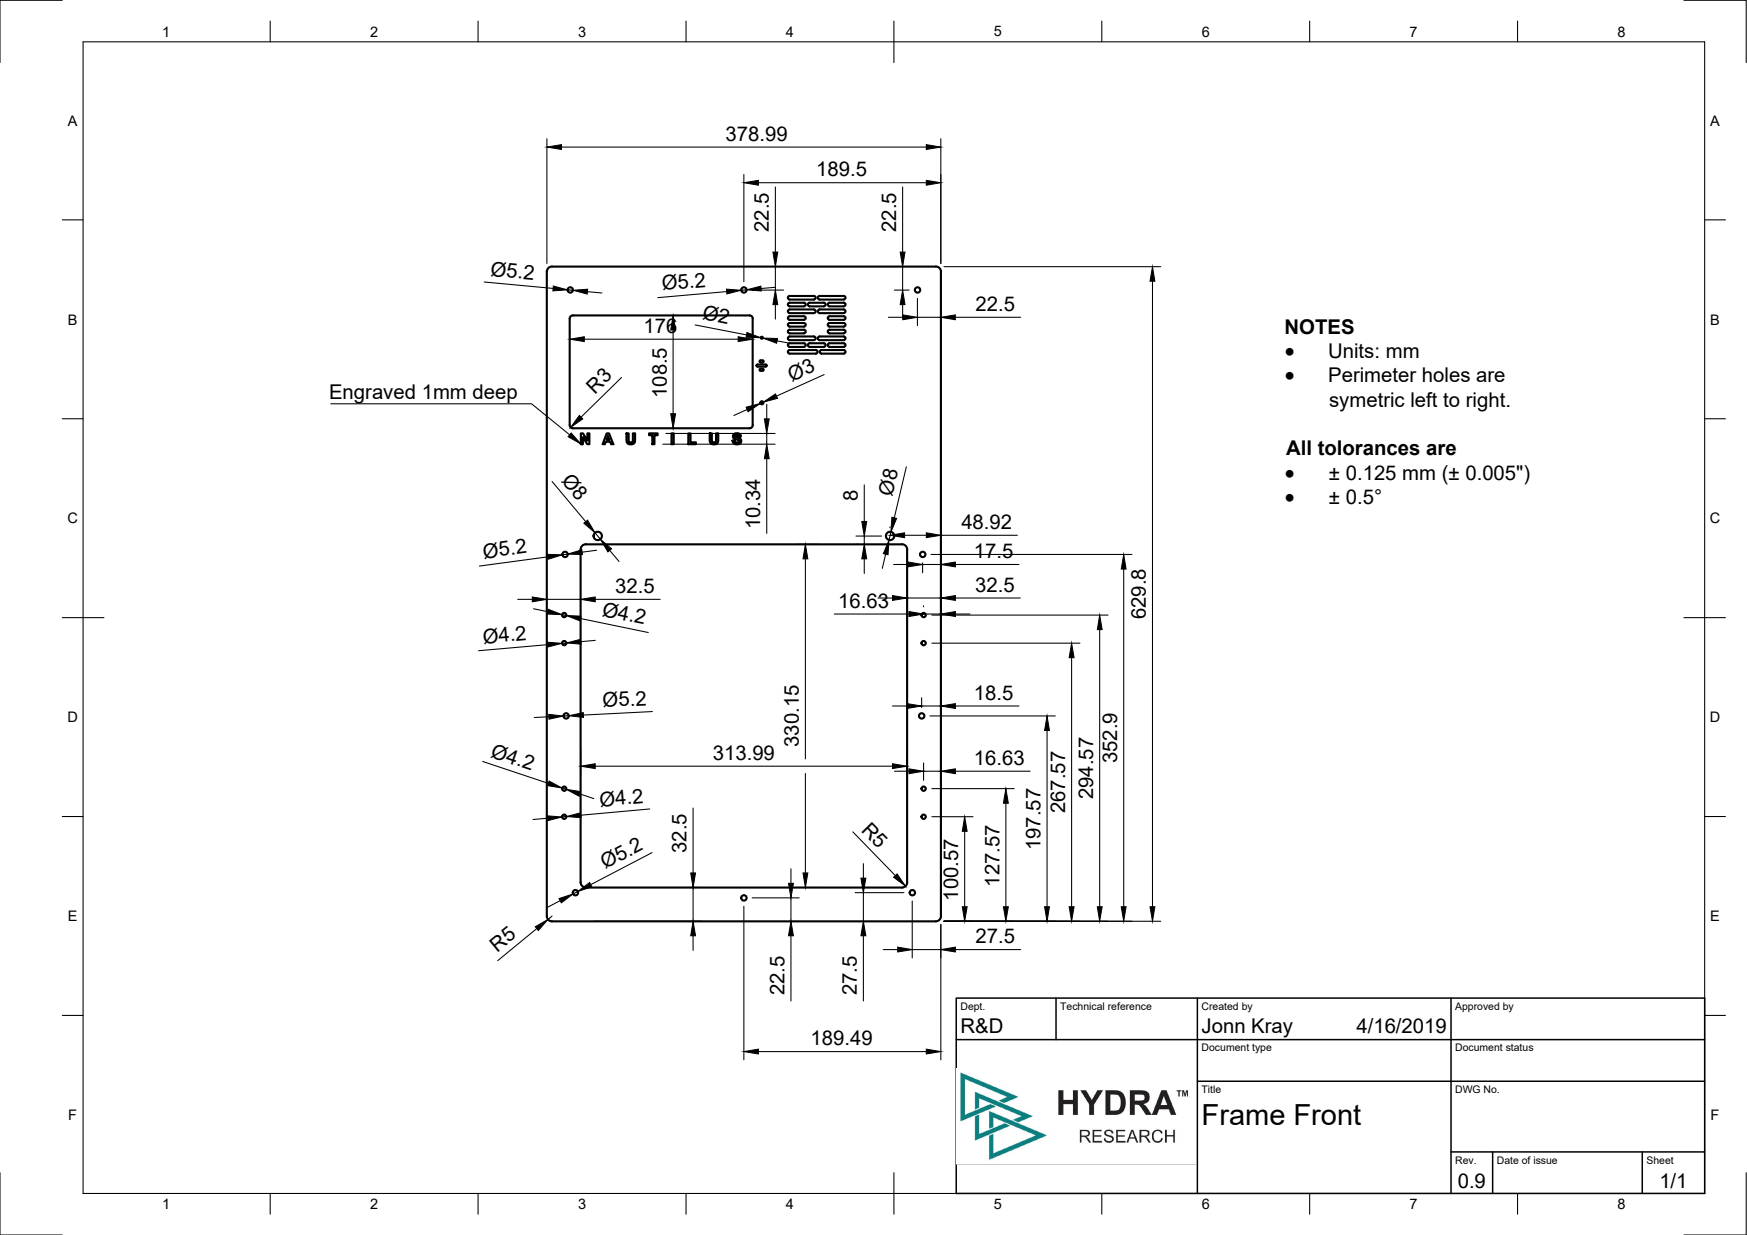
[picture p113: page 1]
Jonn Kray 629.8; Engraved 1mm deep

NOTES
· Units: mm
· Perimeter holes are
symetric left to right.

All tolorances are

Dept. | Technical reference | Created by 4/16/2019 | Approved by

Document type | Document status

Title Frame Front | DWG No.

Rev. 0.9 | Date of issue | Sheet 1/1
