HydraResearchLLC/Nautilus-Hardware/(list of files, drawings)

Other design files:
Nautilus PCBs/EIP PCB/EIP PCB Rev0.1/Extruders in Serise PCB/EIP PCB0.1.PrjPCB
Nautilus PCBs/EIP PCB/EIP PCB Rev0.1/Extruders in Serise PCB/EIP PCB0.1.SchDoc
Nautilus PCBs/EIP PCB/EIP PCB Rev0.1/Extruders in Serise PCB/PCB1.PcbDoc
Nautilus PCBs/Hydra_cartpcb.fzz
Nautilus PCBs/Tool Head 0.2.fzz
Nautilus PCBs/Tool Head PCB/REV0.3_modified/REV0.3_modified/PCB1.PcbDoc
Nautilus PCBs/Tool Head PCB/REV0.3_modified/REV0.3_modified/PCB1.PcbLib
Nautilus PCBs/Tool Head PCB/REV0.3_modified/REV0.3_modified/PcbLib1.PcbLib
Nautilus PCBs/Tool Head PCB/REV0.3_modified/REV0.3_modified/REV0.3.PrjPCB
Nautilus PCBs/Tool Head PCB/REV0.3_modified/REV0.3_modified/REV0.3.SchDoc
Nautilus PCBs/Tool Head PCB/REV0.3_modified/REV0.3_modified/Schlib1.SchLib
Nautilus PCBs/Tool Head PCB/Too Head PCB REV0.3/Too Head PCB REV0.3/PCB1.PcbDoc
Nautilus PCBs/Tool Head PCB/Too Head PCB REV0.3/Too Head PCB REV0.3/PCB1.PcbLib
Nautilus PCBs/Tool Head PCB/Too Head PCB REV0.3/Too Head PCB REV0.3/PcbLib1.PcbLib
Nautilus PCBs/Tool Head PCB/Too Head PCB REV0.3/Too Head PCB REV0.3/Schlib1.SchLib
Nautilus PCBs/Tool Head PCB/Too Head PCB REV0.3/Too Head PCB REV0.3/Too Head PCB REV0.3.PrjPCB
Nautilus PCBs/Tool Head PCB/Too Head PCB REV0.3/Too Head PCB REV0.3/Too Head PCB REV0.3.SchDoc
Nautilus PCBs/Tool PCB/REV0.4_modified/REV0.4_modified/REV04.PcbDoc
Nautilus PCBs/Tool PCB/REV0.4_modified/REV0.4_modified/REV04.PrjPCB
Nautilus PCBs/Tool PCB/REV0.4_modified/REV0.4_modified/REV04.SchDoc
Nautilus PCBs/Tool PCB/REV0.4_modified/REV0.4_modified/REV041.PcbLib
Nautilus PCBs/Tool PCB/Tool Rev 0.4/REV0.4/REV0.4/REV04.PcbDoc
Nautilus PCBs/Tool PCB/Tool Rev 0.4/REV0.4/REV0.4/REV04.PrjPCB
Nautilus PCBs/Tool PCB/Tool Rev 0.4/REV0.4/REV0.4/REV04.SchDoc
Nautilus PCBs/Tool PCB/Tool Rev 0.4/REV0.4/REV0.4/REV041.PcbLib
