HydraResearchLLC/Nautilus-Hardware/(commit log)

2019-05-24 added more stuff
    [BOM-Too Head PCB REV0.3.xlsx, Back Rev0.5.dxf, Back rev0.2.dxf, Back rev0.4.dxf, Band Sawe Mag Strips Jig.stl, Belt Tensioner v1.step, Bill of Materials-EIP PCB0.1.xls, Bill of Materials-REV0.3.xls]
2019-05-24 updating stls
    [Back Rev0.5.dxf, Back rev0.2.dxf, Back rev0.4.dxf, Belt Tensioner v1.step, Bottom Rev0.5.dxf, Bottom rev0.2.dxf, Bottom rev0.4.dxf, Build Plate Cable Mount.stl]
2019-06-13 updating files
    [Build Plate Cable Mount.stl, Door Rev0.9.dxf, Door v1.dxf, Electonics Enclosure Back Rev0.9.dxf, Electonics Enclosure Back v1.dxf, Extruder Body.stl, Frame Back Rev 0.9.dxf, Frame Back Rev v1.dxf]
2019-06-29 updating hardware files before release
    [FIP Single.stl, Y Back L.stl, Y Back R.stl, Y Front L.stl, Y Front R.stl, Y-Axis BL.stl, Y-Axis BR.stl, Y-Axis FL.stl]
2019-10-19 adding fifth contact for tool PCB
    [ToolPCB.brd, ToolPCB.dxf, ToolPCB.sch]
2019-10-20 PCB Tool Head with five contacts
    [ToolHead.brd, ToolHead.sch]
2019-10-23 updated PCBS with new parts 10-22-2019
2019-10-23 .gitignore update
    [ToolHead.brd, ToolHead.sch, ToolPCB.brd, ToolPCB.dxf, ToolPCB.sch]
